JackPikatea/pikatea-macropad-deej-firmware/README.md

# PikateaPCB
This is private repo for the Pikatea Macropad PCB source files. All files are owned by Pikatea Company
