JackPikatea/pikatea-macropad-deej-firmware/Pikatea Macropad GB4/BOM from GB3/Pikatea Macropad GB3.xls

Id | Designator | Package | Quantity | Designation | Manufacturer | Manufacturer Part Number | Description
7 | SW1 | SW_SPST_TL3342 | 1 | SW_DPST | HRO | K2-1187SQ-D4SW-06 | SPST-NO,12VDC,50mA,4-SMD
9 | R3 | R_0805_2012Metric | 1 | 10K | Yageo | RC0805FR-0710KL | 10K,1%,1/8W,0805
11 | C14,C12,C11 | C_0805_2012Metric | 3 | 100nF | Yageo | CC0805KRX7R9BB104 | 100nF,50V,10%,X7R,0805
14 | X1 | Crystal_SMD_SeikoEpson_FA238-4Pin_3.2x2.5mm | 1 | 16MHz | Yangxing Tech | X322516MLB4SI | 16MHz ±10ppm 9pF 60? SMD-3225_4P
15 | U1 | LQFP-44_10x10mm_P0.8mm | 1 | ATMEGA32U4-EP | Microchip Technology | ATMEGA32U4-AU | ATMEGA32U4-AU,44-TQFP
16 | R5,R4 | R_0805_2012Metric | 2 | 22 | Yageo | AC0805FR-0722RL | 22? ±1% 0.125W ±100ppm/? 0805
18 | C10,C5,C4,C3,C2,C1 | C_0805_2012Metric | 6 | 0u1 | Yageo | CC0805KRX7R9BB104 | 100nF,50V,10%,X7R,0805
19 | C9 | C_0805_2012Metric | 1 | 1u | Yageo | CC0805KKX7R9BB105 | 1uF,50V,10%,X7R,0805
20 | C8,C7 | C_0805_2012Metric | 2 | 22p | Yageo | CC0805JRNPO9BN220 | 22pF ±5% 50V NP0 0805
21 | C6 | C_0805_2012Metric | 1 | 4u7 | Yageo | CC0805KKX5R6BB475 | 4.7uF,10V,10%,X5R,0805
22 | J2 |  | 1 |  | Jing Extension of the Electronic Co. | 920-462A2021D10102 | Through Hole USB B Mini Connectors
