JackPikatea/pikatea-macropad-deej-firmware/Pikatea Macropad GB4/BOM from GB3/JLCSMT_Sample_BOM1.xlsx

Comment | Designator | Footprint | LCSC Part #（optional）
 | SW1 | SW_SPST_TL3342 | C223821
 | R3 | R_0805_2012Metric | C84376
 | C14,C12,C11 | C_0805_2012Metric | C49678
16MHz | X1 | Crystal:Crystal_SMD_SeikoEpson_FA238-4Pin_3.2x2.5mm | C13738
Atmega32U4-AU | U1 | Package_QFP:TQFP-44_10x10mm_P0.8mm | C44854
 | R5,R4 | R_0805_2012Metric | C144573
 | C10,C5,C4,C3,C2,C1 | C_0805_2012Metric | C49678
 | C9 | C_0805_2012Metric | C91185
 | C8,C7 | C_0805_2012Metric | C105623
 | C6 | C_0805_2012Metric | C107125
USB_B_Mini | J2 | usb_mini:USB-Mini-B_ LCSC-C46398 | C46398
