JackPikatea/pikatea-macropad-deej-firmware/Pikatea SD card Module/BOM/Pikatea SD card Module.xls

Id | Designator | Package | Quantity | Designation | Manufacturer | Manufacturer Part Number | Description
1 | XS1 | XUNPU_TF-110 | 1 | SD_ebay-uSD-push_push_SMD | XUNPU | TF-110 | microSD™ Memory Card 8 connector 11.25x11.35x1.32mm Card Sockets Connectors RoHS
2 | R4,R3,R2,R1 | R_0805_2012Metric | 4 | 3.3K | Yageo | RC0805FR-073K3L | 3.3K,1%,1/8W,0805
3 | U2 | SOT-223-3_TabPin2 | 1 | AMS1117-3.3 | SHIKUES(??) | AMS1117-3.3 | AMS1117-3.3,SOT-223
4 | U3 | TSSOP-14-1EP_4.4x5mm_P0.65mm | 1 | 74LVC125APW,118 | Nxp Semiconductors | 74LVC125APW,118 | 74LVC125APW,118,14-TSSOP
5 | C1,C2,C4 | C_0805_2012Metric | 3 | 100nF | Yageo | CC0805KRX7R9BB104 | 100nF,50V,10%,X7R,0805
6 | C3 | C_0805_2012Metric | 1 | 10uF | Samsung Electro-Mechanics | CL21A106KAYNNNE | 10uF,25V,10%,X5R,0805
