JackPikatea/pikatea-macropad-deej-firmware/Pikatea Macropad Mini/BOM/Pikatea Macropad Mini.xls

Id | Designator | Package | Quantity | Designation | Manufacturer | Manufacturer Part Number | Description
3 | C13 | C_0805_2012Metric | 1 | 10uF | Samsung Electro-Mechanics | CL21A106KAYNNNE | 10uF,25V,10%,X5R,0805
5 | U3 | TSSOP-14-1EP_4.4x5mm_P0.65mm | 1 | 74LVC125APW,118 | Nxp Semiconductors | 74LVC125APW,118 | 74LVC125APW,118,14-TSSOP
6 | U2 | SOT-223-3_TabPin2 | 1 | AMS1117-3.3 | SHIKUES(??) | AMS1117-3.3 | AMS1117-3.3,SOT-223
7 | SW1 | SW_SPST_TL3342 | 1 | SW_DPST | HRO | K2-1187SQ-D4SW-06 | SPST-NO,12VDC,50mA,4-SMD
8 | R7,R6,R2,R1 | R_0805_2012Metric | 4 | 3.3K | Yageo | RC0805FR-073K3L | 3.3K,1%,1/8W,0805
9 | R3 | R_0805_2012Metric | 1 | 10K | Yageo | RC0805FR-0710KL | 10K,1%,1/8W,0805
11 | C14,C12,C11 | C_0805_2012Metric | 3 | 100nF | Yageo | CC0805KRX7R9BB104 | 100nF,50V,10%,X7R,0805
13 | XS1 | XUNPU_TF-110 | 1 | SD_ebay-uSD-push_push_SMD | XUNPU | TF-110 | microSD™ Memory Card 8 connector 11.25x11.35x1.32mm Card Sockets Connectors RoHS
14 | X1 | Crystal_SMD_SeikoEpson_FA238-4Pin_3.2x2.5mm | 1 | 16MHz | YXC???? | X322516MLB4SI | 16MHZ,9PF,4-SMD
15 | U1 | LQFP-44_10x10mm_P0.8mm | 1 | ATMEGA32U4-EP | Microchip Technology | ATMEGA32U4-AU | ATMEGA32U4-AU,44-TQFP
16 | R5,R4 | R_0805_2012Metric | 2 | 22 | TE Connectivity | CRG0805F22R | 22R,1%,1/8W,0805
18 | C10,C5,C4,C3,C2,C1 | C_0805_2012Metric | 6 | 0u1 | Yageo | CC0805KRX7R9BB104 | 100nF,50V,10%,X7R,0805
19 | C9 | C_0805_2012Metric | 1 | 1u | Yageo | CC0805KKX7R9BB105 | 1uF,50V,10%,X7R,0805
20 | C8,C7 | C_0805_2012Metric | 2 | 22p | KEMET | C0805C220J5GACTU | 22pF,50V,5%,C0G,0805
21 | C6 | C_0805_2012Metric | 1 | 4u7 | Yageo | CC0805KKX5R6BB475 | 4.7uF,10V,10%,X5R,0805
