JackPikatea/pikatea-macropad-deej-firmware/Pikatea R26 macropad/Pikatea R26 Macropad/assembled1.step

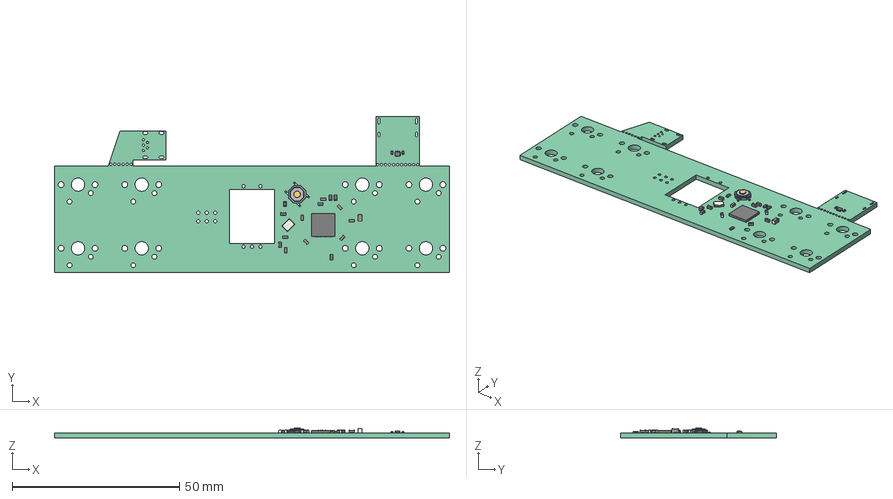
[picture p6: CAD file, 2022-02-02]
Pikatea R26 macropad/Pikatea R26 Macropad/assembled1.step
118.2 x 46.7 x 3.14 mm
Local_CS_fcbd
Pcb_fcbd
PCB_Sketch_fcbd
SW1_SW_SPST_TL3342_61F87470
R5_R_0603_1608Metric_61F8A8D3
Y1_Crystal_SMD_SeikoEpson_FA238-4Pin_3.2x2.5mm_61F812BB
U2_SOT_666_61F81285
U1_QFN-44-1EP_7x7mm_Pitch0.5mm_61F8126F
R_HWB1_R_0603_1608Metric_61F84E14
R4_R_0603_1608Metric_61F853EC
R3_R_0603_1608Metric_61F85494
R2_R_0402_1005Metric_61F81196
R1_R_0402_1005Metric_61F81187
C12_C_0603_1608Metric_61F81039
C11_C_0603_1608Metric_61F8860B
C10_C_0805_2012Metric_61F81017
C9_C_0603_1608Metric_61F81006
C8_C_0603_1608Metric_61F80FF5
C7_C_0603_1608Metric_61F80FE4
C6_C_0603_1608Metric_61F80FD3
C5_C_0603_1608Metric_61F80FC2
C4_C_0603_1608Metric_61F80FB1
C3_C_0603_1608Metric_61F80FA0
C2_C_0603_1608Metric_61F80F8F
C1_C_0603_1608Metric_61F84EFE
