JackPikatea/pikatea-macropad-deej-firmware/Pikatea Desktop Macropad/PCB Model.step

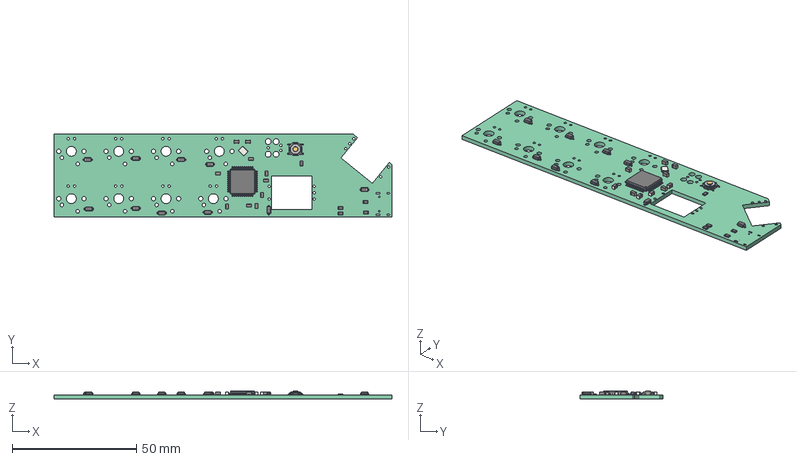
[picture p9: CAD file, 2021-05-04]
Pikatea Desktop Macropad/PCB Model.step
136.0 x 33.5 x 3.14 mm
Local_CS_4ca4
Pcb_4ca4
PCB_Sketch_4ca4
R2_R_0805_2012Metric_607FE78E
R1_R_0805_2012Metric_607FE77D
X1_Crystal_SMD_SeikoEpson_FA238-4Pin_3.2x2.5mm_60806100
U1_LQFP_44_10x10mm_P08mm_608056F7
SW1_SW_SPST_TL3342_607F38D0
R5_R_0805_2012Metric_607F4A5F
R4_R_0805_2012Metric_607F3889
R3_R_0805_2012Metric_607F3878
D10_D_SOD_123_60805B52
D9_D_SOD_123_607F3736
D8_D_SOD_123_607F371D
D7_D_SOD_123_607F3704
D6_D_SOD_123_607F36EB
D5_D_SOD_123_607F36D2
D4_D_SOD_123_607F5B08
D3_D_SOD_123_607F36A0
D2_D_SOD_123_607F3687
D1_D_SOD_123_607F366E
C10_C_0805_2012Metric_60806FC0
C9_C_0805_2012Metric_60809403
C8_C_0805_2012Metric_607F3633
C7_C_0805_2012Metric_607F3622
C6_C_0805_2012Metric_60806B1D
C5_C_0805_2012Metric_607F3600
C4_C_0805_2012Metric_607F35EF
C3_C_0805_2012Metric_607F35DE
C2_C_0805_2012Metric_60806F2E
C1_C_0805_2012Metric_607F35BC
