JackPikatea/pikatea-macropad-deej-firmware/Pikatea handwire helpers/2u Hand Wire Helpers/rev2.step

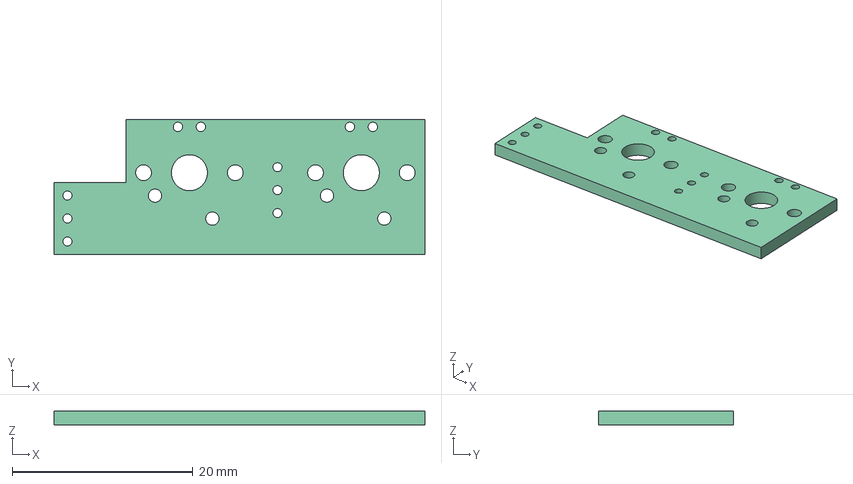
[picture p10: CAD file, 2021-09-28]
Pikatea handwire helpers/2u Hand Wire Helpers/rev2.step
41.1 x 15.0 x 1.60 mm
Local_CS_9b5
Pcb_9b5
PCB_Sketch_9b5
Top_9b5
