JackPikatea/pikatea-macropad-deej-firmware/Pikatea Keyboard ProMicro/PCB1.step

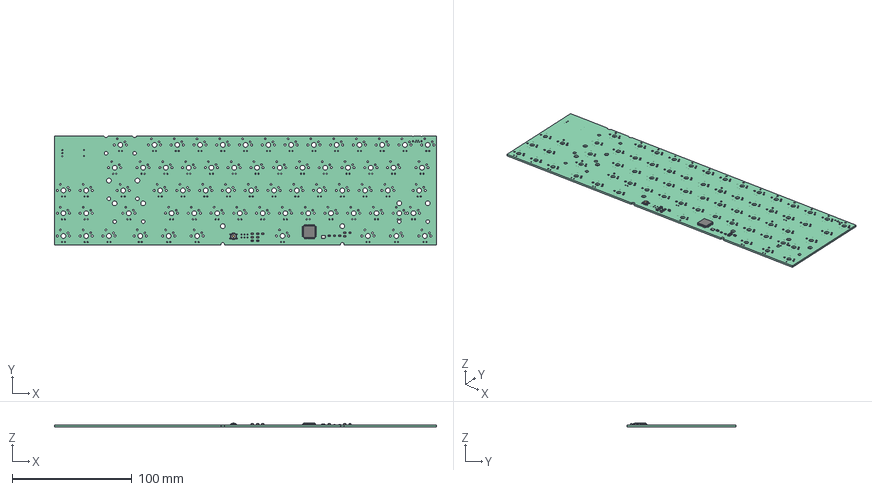
[picture p11: CAD file, 2021-05-04]
Pikatea Keyboard ProMicro/PCB1.step
319.6 x 91.1 x 3.14 mm
Local_CS_c713
Pcb_c713
PCB_Sketch_c713
X1_Crystal_SMD_SeikoEpson_FA238-4Pin_3.2x2.5mm_608C011E
U1_LQFP_44_10x10mm_P08mm_608C921C
SW1_SW_SPST_TL3342_608C00A2
R5_R_0805_2012Metric_608C006C
R4_R_0805_2012Metric_608C005B
R3_R_0805_2012Metric_608C004A
C10_C_0805_2012Metric_608BF9E7
C9_C_0805_2012Metric_608BF9D6
C8_C_0805_2012Metric_608BF9C5
C7_C_0805_2012Metric_608BF9B4
C6_C_0805_2012Metric_608BF9A3
C5_C_0805_2012Metric_608BF992
C4_C_0805_2012Metric_608BF981
C3_C_0805_2012Metric_608BF970
C2_C_0805_2012Metric_608BF95F
C1_C_0805_2012Metric_608BF94E
