JackPikatea/pikatea-macropad-deej-firmware/Pikatea Macropad GB3/GB3 PCB.step

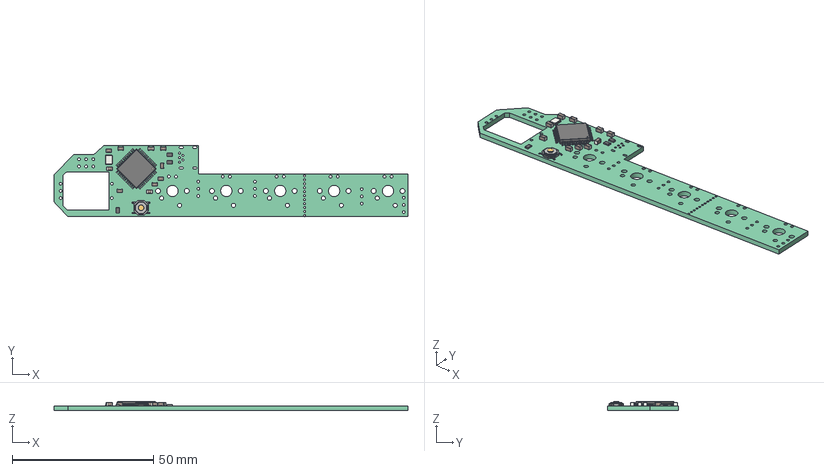
[picture p12: CAD file, 2021-09-28]
Pikatea Macropad GB3/GB3 PCB.step
125.1 x 25.2 x 3.14 mm
Local_CS_68f9
Pcb_68f9
PCB_Sketch_68f9
SW1_SW_SPST_TL3342_605A6D3F
X1_Crystal_SMD_SeikoEpson_FA238-4Pin_3.2x2.5mm_605A6E1B
R5_R_0805_2012Metric_605A6D09
R4_R_0805_2012Metric_605A6CF8
R3_R_0805_2012Metric_605A6CE7
C10_C_0805_2012Metric_605CCE2F
C9_C_0805_2012Metric_605A6B15
C8_C_0805_2012Metric_605A6B04
C7_C_0805_2012Metric_605A6AF3
C6_C_0805_2012Metric_605A6AE2
C5_C_0805_2012Metric_605A6AD1
C4_C_0805_2012Metric_605A6AC0
C3_C_0805_2012Metric_605A6AAF
C2_C_0805_2012Metric_605A6A9E
C1_C_0805_2012Metric_605CC52D
U1_LQFP_44_10x10mm_P08mm_605AD741
