JackPikatea/pikatea-macropad-deej-firmware/Pikatea Macropad GB4 Full Kit/Library Files/Type-C.pretty-master/Type-C.pretty-master/HRO  TYPE-C-31-M-12.step

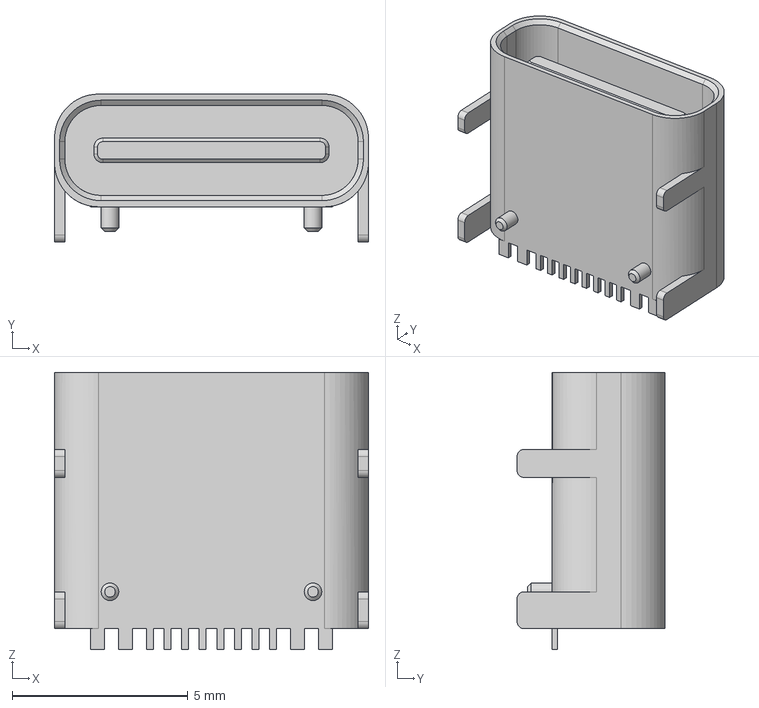
[picture p13: CAD file, 2021-05-04]
Pikatea Macropad GB4 Full Kit/Library Files/Type-C.pretty-master/Type-C.pretty-master/HRO TYPE-C-31-M-12.step
8.94 x 4.21 x 7.90 mm
