JackPikatea/pikatea-macropad-deej-firmware/Pikatea R26 macropad/Pikatea R26 Kit LED Macropad/Pikatea R26 Kit LED Macropad PCB Model.step

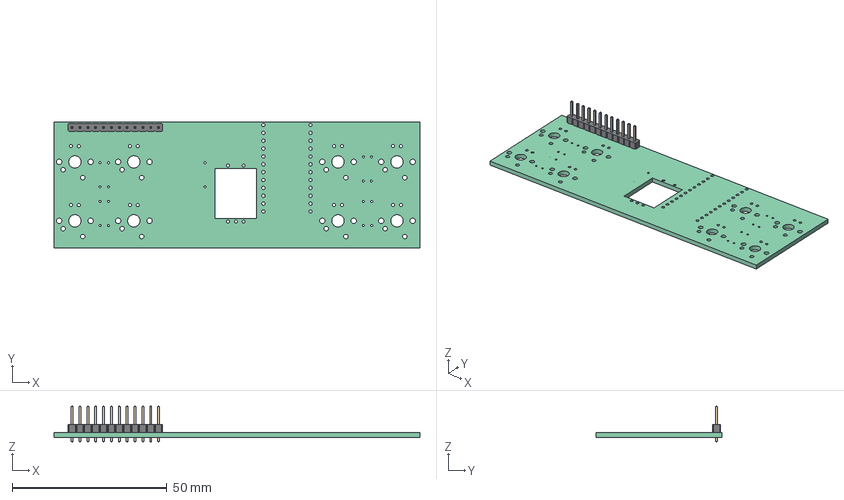
[picture p14: CAD file, 2022-01-25]
Pikatea R26 macropad/Pikatea R26 Kit LED Macropad/Pikatea R26 Kit LED Macropad PCB Model.step
118.3 x 40.8 x 11.5 mm
Local_CS_c334
Pcb_c334
PCB_Sketch_c334
J1_PinHeader_1x12_P254mm_Vertical_61C3FEEA
