JackPikatea/pikatea-macropad-deej-firmware/Pikatea R26 macropad/Pikatea R26 Plate/reference plate2.dxf

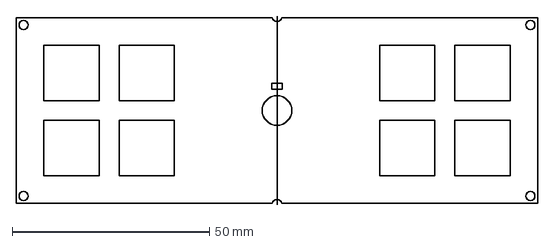
[picture p15: CAD file, 2022-02-08]
Pikatea R26 macropad/Pikatea R26 Plate/reference plate2.dxf
132.1 x 47.6 mm
