JackPikatea/pikatea-macropad-deej-firmware/Pikatea R26 macropad/top plate template sketch.dxf

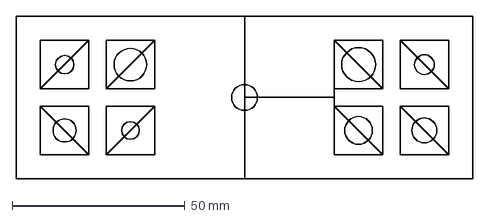
[picture p16: CAD file, 2022-01-31]
Pikatea R26 macropad/top plate template sketch.dxf
132.1 x 47.1 mm
