JackPikatea/pikatea-macropad-deej-firmware/Pikatea Richard/PR-BottomCase/The Richard Bottom Plate.step

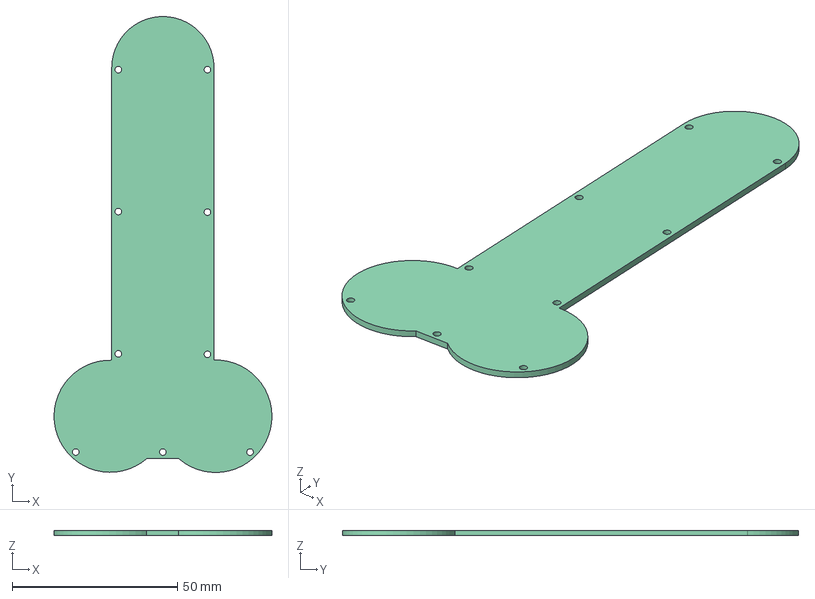
[picture p17: CAD file, 2021-06-23]
Pikatea Richard/PR-BottomCase/The Richard Bottom Plate.step
66.0 x 138.1 x 1.60 mm
Local_CS_8dec
Pcb_8dec
PCB_Sketch_8dec
Step_Models_8dec
