JackPikatea/pikatea-macropad-deej-firmware/Pikatea Richard/PR-PCB/The richard PCB.step

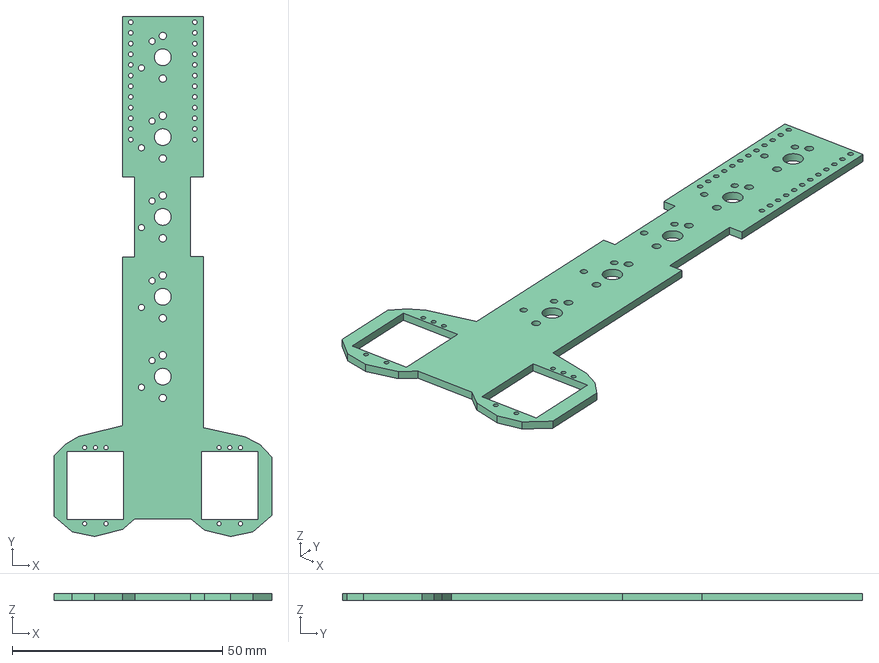
[picture p18: CAD file, 2022-03-31]
Pikatea Richard/PR-PCB/The richard PCB.step
51.8 x 123.8 x 1.60 mm
Local_CS_413a
Pcb_413a
PCB_Sketch_413a
Step_Models_413a
