JackPikatea/pikatea-macropad-deej-firmware/Pikatea Richard/PR-TopPlate/Richard Top Plate.step

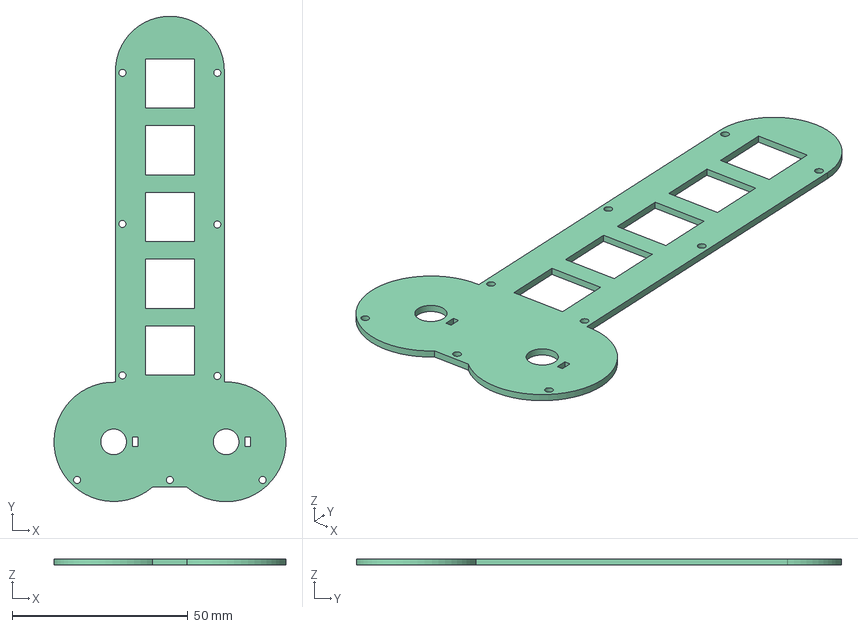
[picture p19: CAD file, 2021-06-23]
Pikatea Richard/PR-TopPlate/Richard Top Plate.step
66.0 x 138.1 x 1.60 mm
Local_CS_3f50
Pcb_3f50
PCB_Sketch_3f50
Step_Models_3f50
