JackPikatea/pikatea-macropad-deej-firmware/Pikatea R26 macropad/Backside cover sketch.dxf

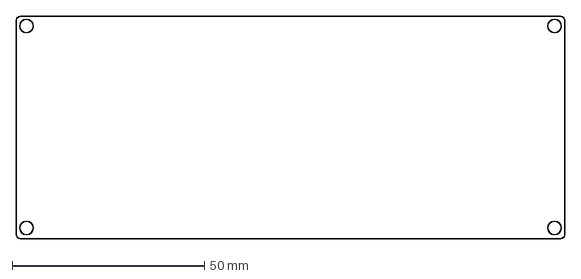
[picture p21: CAD file, 2022-01-31]
Pikatea R26 macropad/Backside cover sketch.dxf
142.6 x 57.8 mm
