JackPikatea/pikatea-macropad-deej-firmware/Pikatea R26 macropad/Pikatea R26 Plate/reference plate.dxf

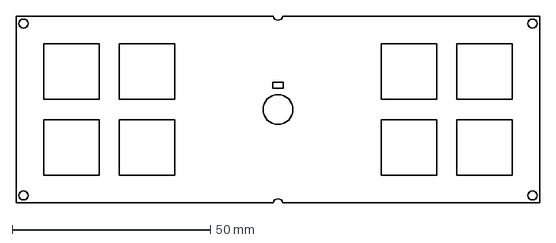
[picture p22: CAD file, 2022-02-08]
Pikatea R26 macropad/Pikatea R26 Plate/reference plate.dxf
132.1 x 47.1 mm
