JackPikatea/pikatea-macropad-deej-firmware/Pikatea R26 macropad/Pikatea R26 Macropad/step6.step

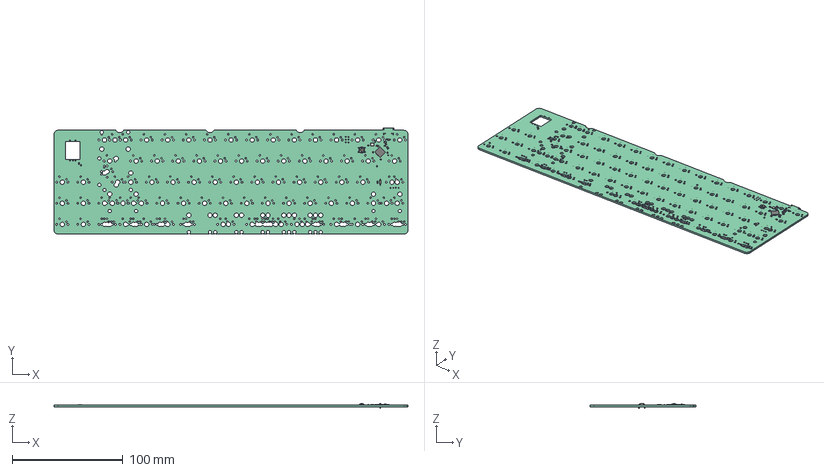
[picture p23: CAD file, 2022-01-31]
Pikatea R26 macropad/Pikatea R26 Macropad/step6.step
319.6 x 95.7 x 4.59 mm
Local_CS_8b00
Pcb_8b00
PCB_Sketch_8b00
SW1_SW_SPST_TL3342_61CD82D5
C12_C_0603_1608Metric_61CD6900
C11_C_0603_1608Metric_61CD68EF
C6_C_0603_1608Metric_61CA5CF7
R5_R_0603_1608Metric_61CCE06B
U2_SOT_666_61CB1819
U1_QFN-44-1EP_7x7mm_Pitch0.5mm_61CAB430
Y1_Crystal_SMD_SeikoEpson_FA238-4Pin_3.2x2.5mm_61CA77BC
R_HWB1_R_0603_1608Metric_61CA7686
R4_R_0603_1608Metric_61CA7664
R3_R_0603_1608Metric_61CA7653
R2_R_0402_1005Metric_61CA7642
R1_R_0402_1005Metric_61CA7633
C10_C_0805_2012Metric_61CADA8C
C9_C_0603_1608Metric_61CA5D2A
C8_C_0603_1608Metric_61CAD480
C7_C_0603_1608Metric_61CD3611
C5_C_0603_1608Metric_61CA5CE6
C4_C_0603_1608Metric_61CAD9CA
C3_C_0603_1608Metric_61CAC993
C2_C_0603_1608Metric_61CA5CB3
C1_C_0603_1608Metric_61CA5CA2
capslock_led_resistor_SMD1_R_0805_2012Metric_61611AB7
capslock_led_resistor_THT1_R_Axial_DIN0204_L36mm_D16mm_P508mm_ Horizontal_6144AEC9
