JackPikatea/pikatea-macropad-deej-firmware/(list of files, cad)

Other CAD files:
4 button Macropad(2)/pcb.step
Pikatea handwire helpers/1u Hand Wire Helpers/rev1.step
Pikatea handwire helpers/2u Hand Wire Helpers/rev1.step
Pikatea handwire helpers/Space Hand Wire Helpers/rev1.step
