JackPikatea/pikatea-macropad-deej-firmware/(list of files, drawings)

Other design files:
4 button Macropad(2)/BigSwitch.dsn
