JackPikatea/pikatea-macropad-deej-firmware/Pikatea Macropad GB4 Full Kit/Pikatea Macropad GB4 Full Kit.kicad_pcb

## KiCad design Pikatea Macropad GB4 Full Kit/Pikatea Macropad GB4 Full Kit.kicad_pcb (2022-03-31)

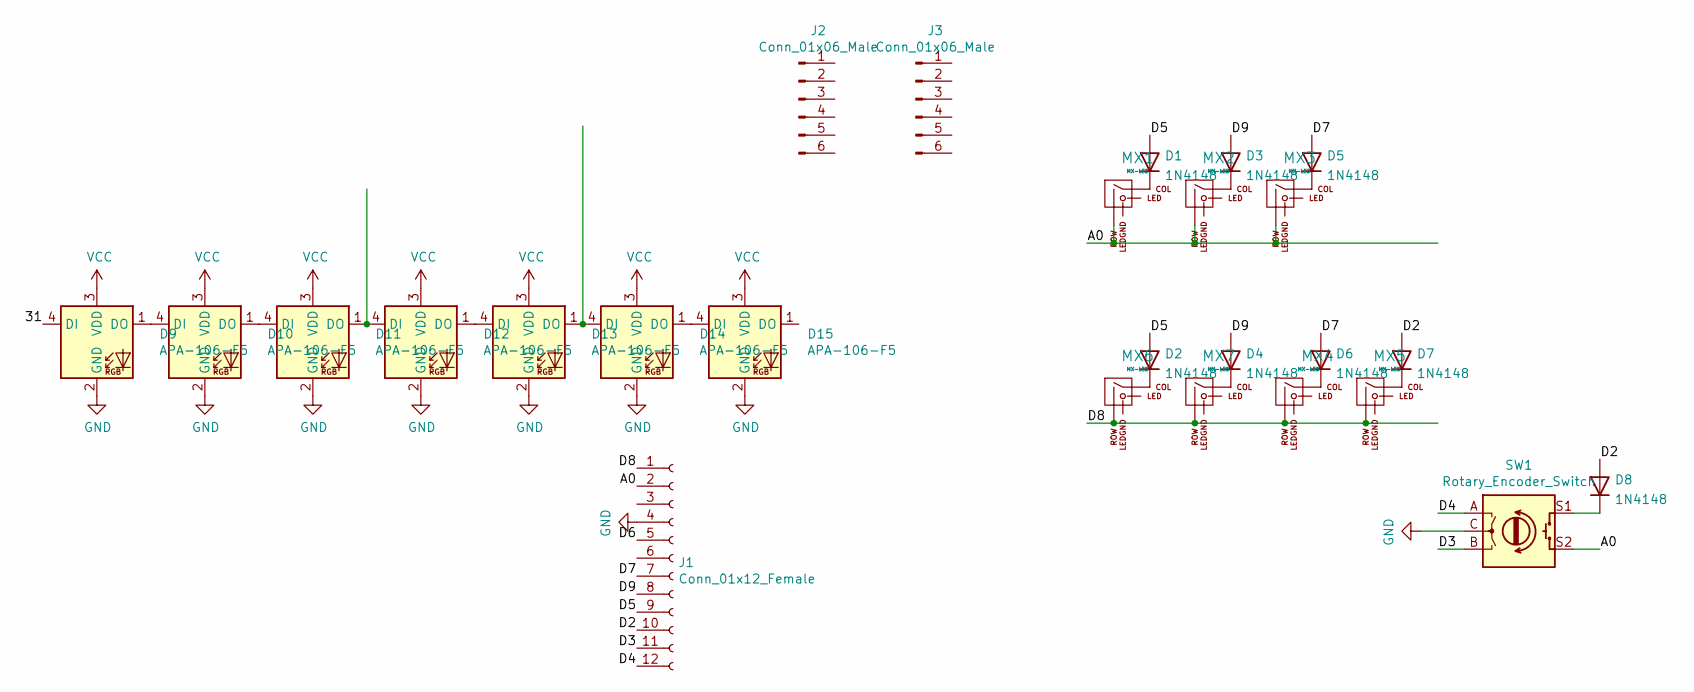
[picture p27: schematic Pikatea Macropad GB4 Full Kit.kicad_sch]

Parts:
D1, D2, D3, D4, D5, D6, D7, D8: 1N4148; D_SOD123W_hand
D9, D10, D11, D12, D13, D14, D15: APA-106-F5; TONYU-DY-S352818-RGBC
J1: Conn_01x12_Female; PinHeader_1x12_P2.54mm_Vertical
J2, J3: Conn_01x06_Male; Breakaway-Throughole
MX1, MX2, MX3, MX4, MX5, MX6, MX7: MX-LED; MXOnly-1U-SquareCutLED
SW1: Rotary_Encoder_Switch; Encoder-BI_EN11_HSM0E

Connections:
/31: D9.4 (DI)
/A0: J1.2, MX1.2 (ROW), MX2.2 (ROW), MX3.2 (ROW), SW1.S2
/D2: D7.2 (A), D8.2 (A), J1.10
/D3: J1.11, SW1.B
/D4: J1.12, SW1.A
/D5: D1.2 (A), D2.2 (A), J1.9
/D6: J1.5
/D7: D5.2 (A), D6.2 (A), J1.7
/D8: J1.1, MX4.2 (ROW), MX5.2 (ROW), MX6.2 (ROW), MX7.2 (ROW)
/D9: D3.2 (A), D4.2 (A), J1.8
GND: D9.2 (GND), D10.2 (GND), D11.2 (GND), D12.2 (GND), D13.2 (GND), D14.2 (GND), D15.2 (GND), J1.4, SW1.C
unnamed: D2.1 (K), MX6.1 (COL)
unnamed: D4.1 (K), MX7.1 (COL)
unnamed: D10.1 (DO), D11.4 (DI)
unnamed: D9.1 (DO), D10.4 (DI)
unnamed: D11.1 (DO), D12.4 (DI)
unnamed: D12.1 (DO), D13.4 (DI)
unnamed: D13.1 (DO), D14.4 (DI)
unnamed: D14.1 (DO), D15.4 (DI)
unnamed: D1.1 (K), MX1.1 (COL)
unnamed: D3.1 (K), MX2.1 (COL)
unnamed: D5.1 (K), MX3.1 (COL)
unnamed: D6.1 (K), MX4.1 (COL)
unnamed: D7.1 (K), MX5.1 (COL)
unnamed: D8.1 (K), SW1.S1
VCC: D9.3 (VDD), D10.3 (VDD), D11.3 (VDD), D12.3 (VDD), D13.3 (VDD), D14.3 (VDD), D15.3 (VDD)

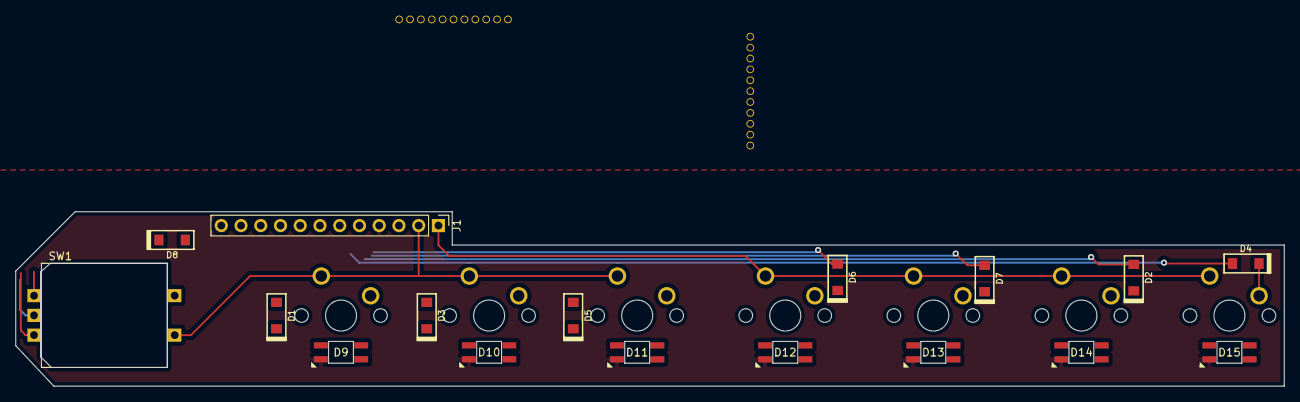
[picture p28: board Pikatea Macropad GB4 Full Kit.kicad_pcb from above]

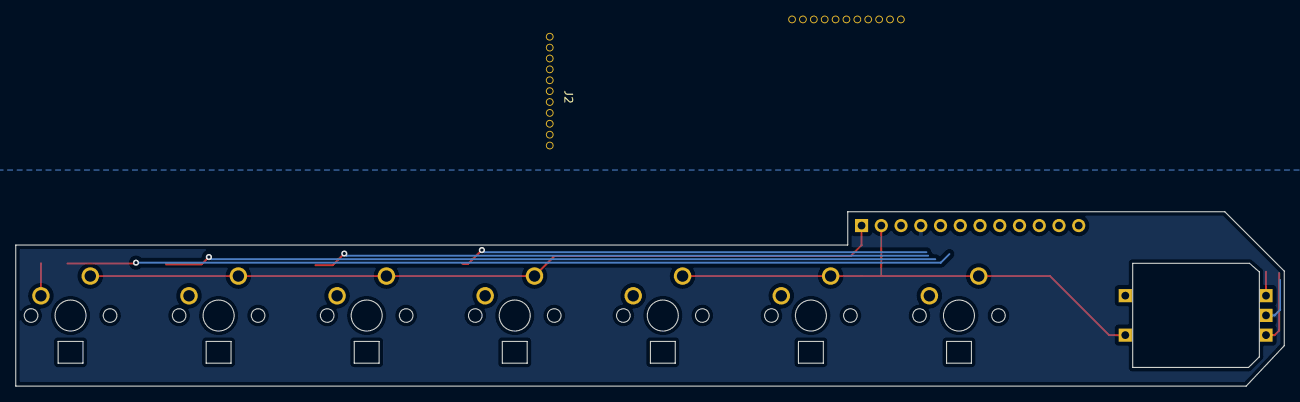
[picture p29: board Pikatea Macropad GB4 Full Kit.kicad_pcb from below]

Board: 2 copper layers, 163.2 x 22.4 mm, 26 parts (14 on the bottom side), 24 nets.
