JackPikatea/pikatea-macropad-deej-firmware/Pikatea Richard/PR-PCB/PR-PCB.kicad_pcb

## KiCad design Pikatea Richard/PR-PCB/PR-PCB.kicad_pcb (2022-03-31)

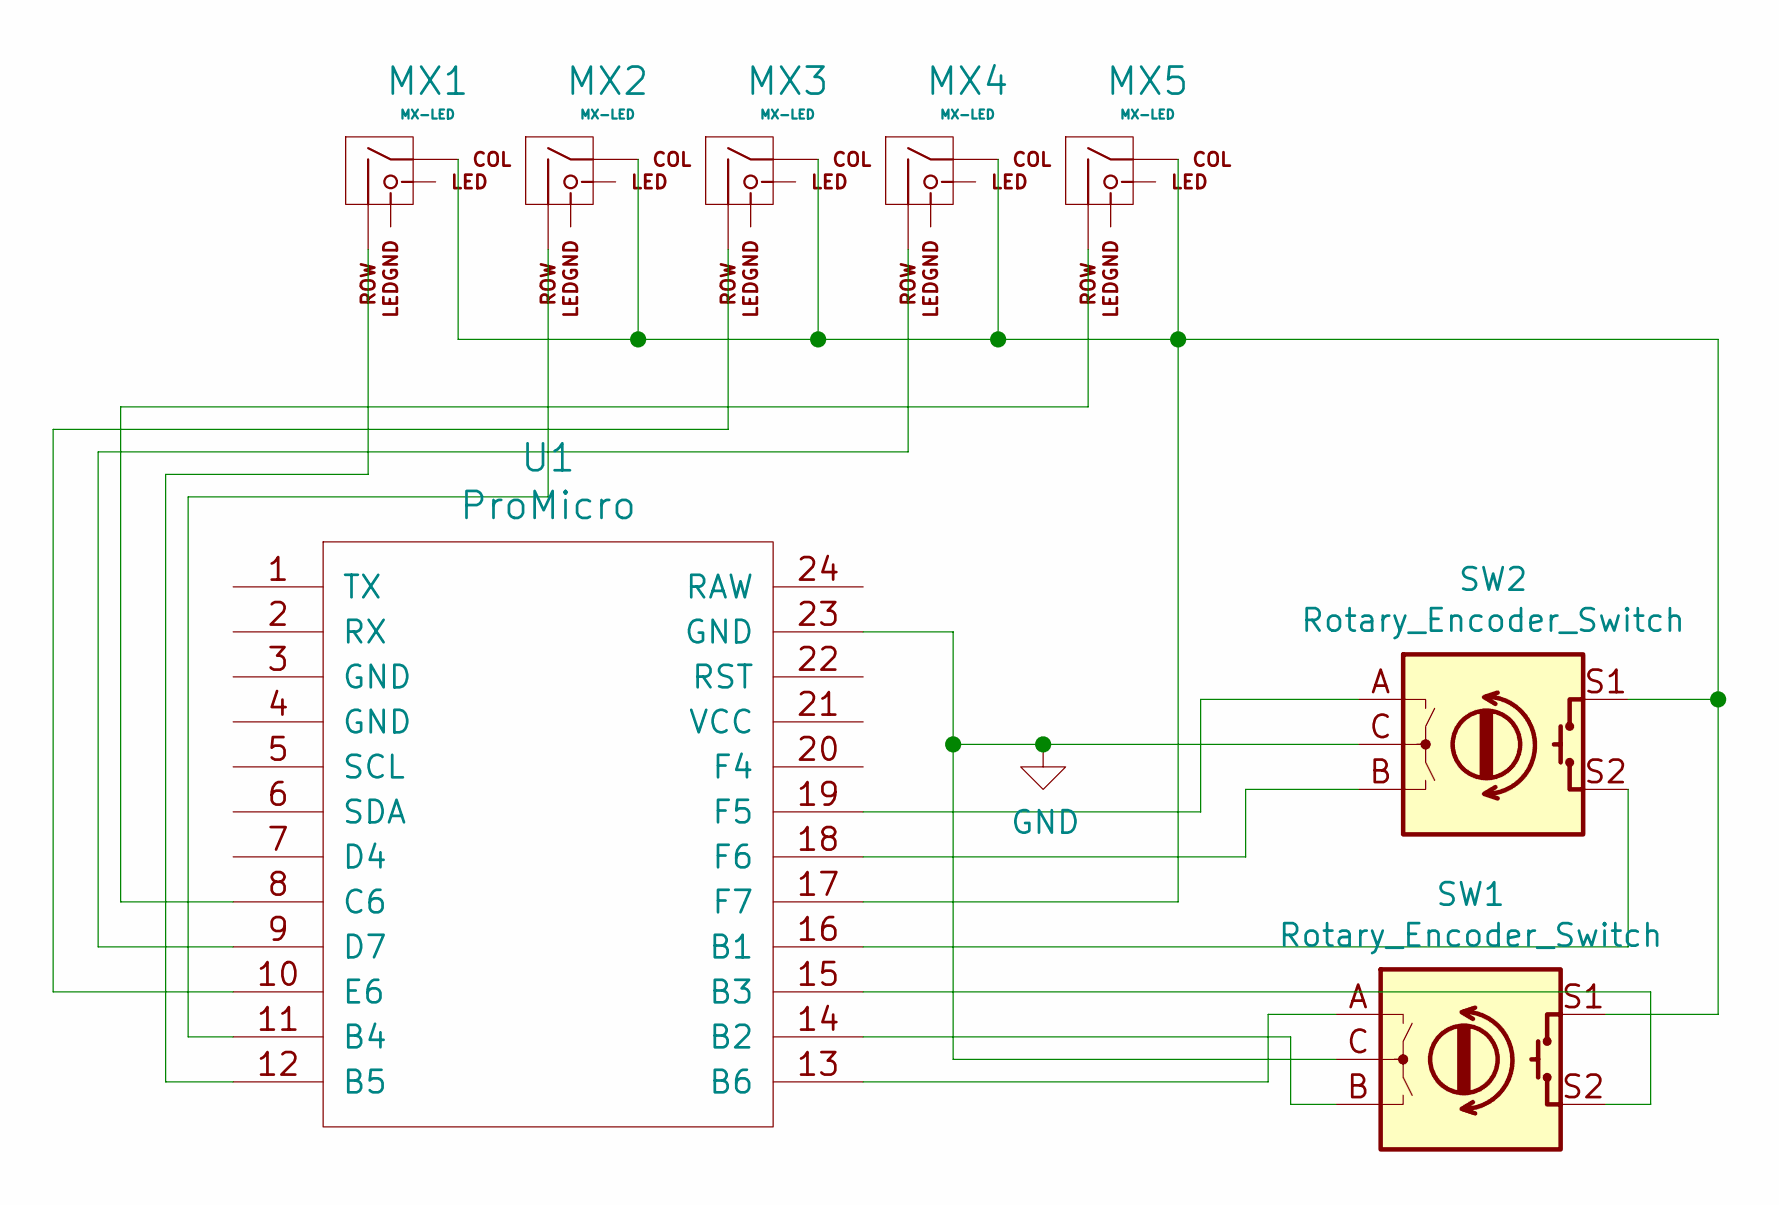
[picture p30: schematic PR-PCB.sch]

Parts:
MX1, MX2, MX3, MX4, MX5: MX-LED; MXOnly-1U-NoLED
SW1, SW2: Rotary_Encoder_Switch; Encoder-BI_EN11_HSM0E
U1: ProMicro

Connections:
GND: SW1.C, SW2.C, U1.23 (GND)
unnamed: MX1.1 (COL), MX2.1 (COL), MX3.1 (COL), MX4.1 (COL), MX5.1 (COL), SW1.S1, SW2.S1, U1.17 (F7)
unnamed: MX1.2 (ROW), U1.12 (B5)
unnamed: MX2.2 (ROW), U1.11 (B4)
unnamed: MX3.2 (ROW), U1.10 (E6)
unnamed: MX4.2 (ROW), U1.9 (D7)
unnamed: MX5.2 (ROW), U1.8 (C6)
unnamed: SW1.A, U1.13 (B6)
unnamed: SW1.B, U1.14 (B2)
unnamed: SW1.S2, U1.15 (B3)
unnamed: SW2.A, U1.19 (F5)
unnamed: SW2.B, U1.18 (F6)
unnamed: SW2.S2, U1.16 (B1)

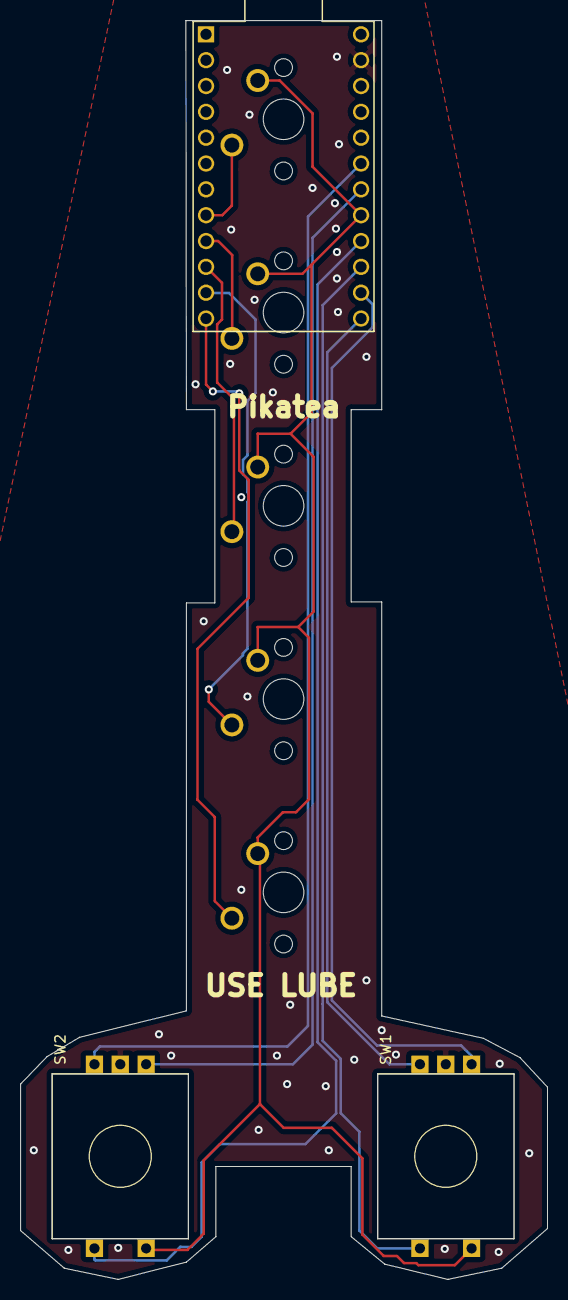
[picture p31: board PR-PCB.kicad_pcb from above]

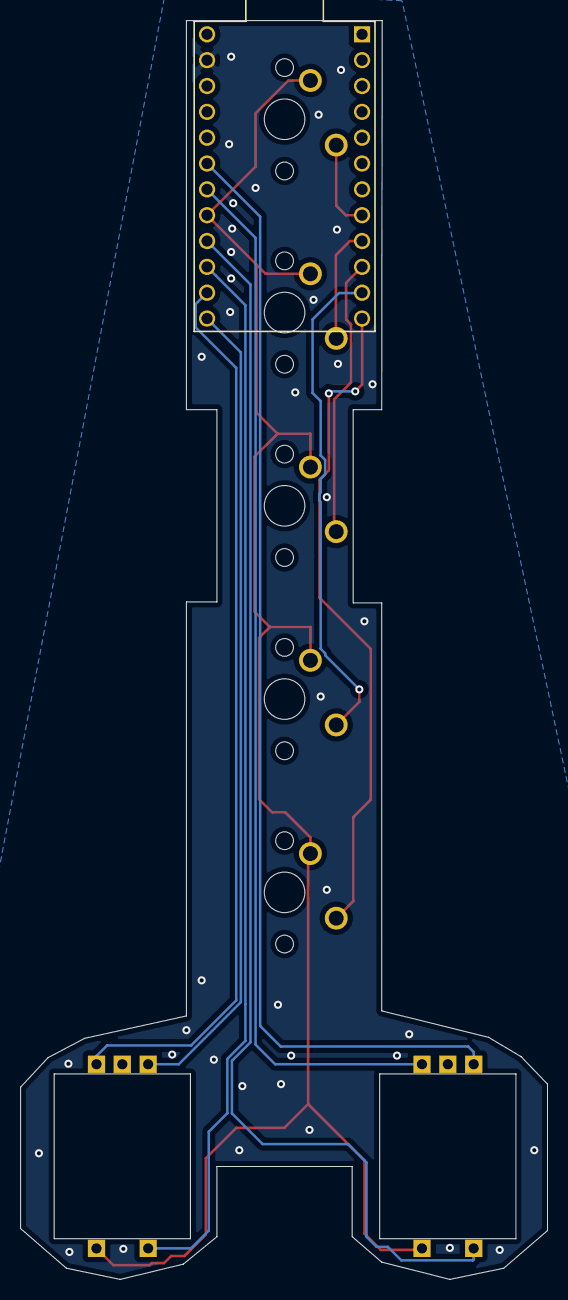
[picture p32: board PR-PCB.kicad_pcb from below]

Board: 2 copper layers, 51.8 x 123.8 mm, 8 parts (5 on the bottom side), 13 nets.
