JackPikatea/pikatea-macropad-deej-firmware/Pikatea Macropad GB4/Pikatea Macropad GB4.kicad_pcb

## KiCad design Pikatea Macropad GB4/Pikatea Macropad GB4.kicad_pcb (2022-03-31)

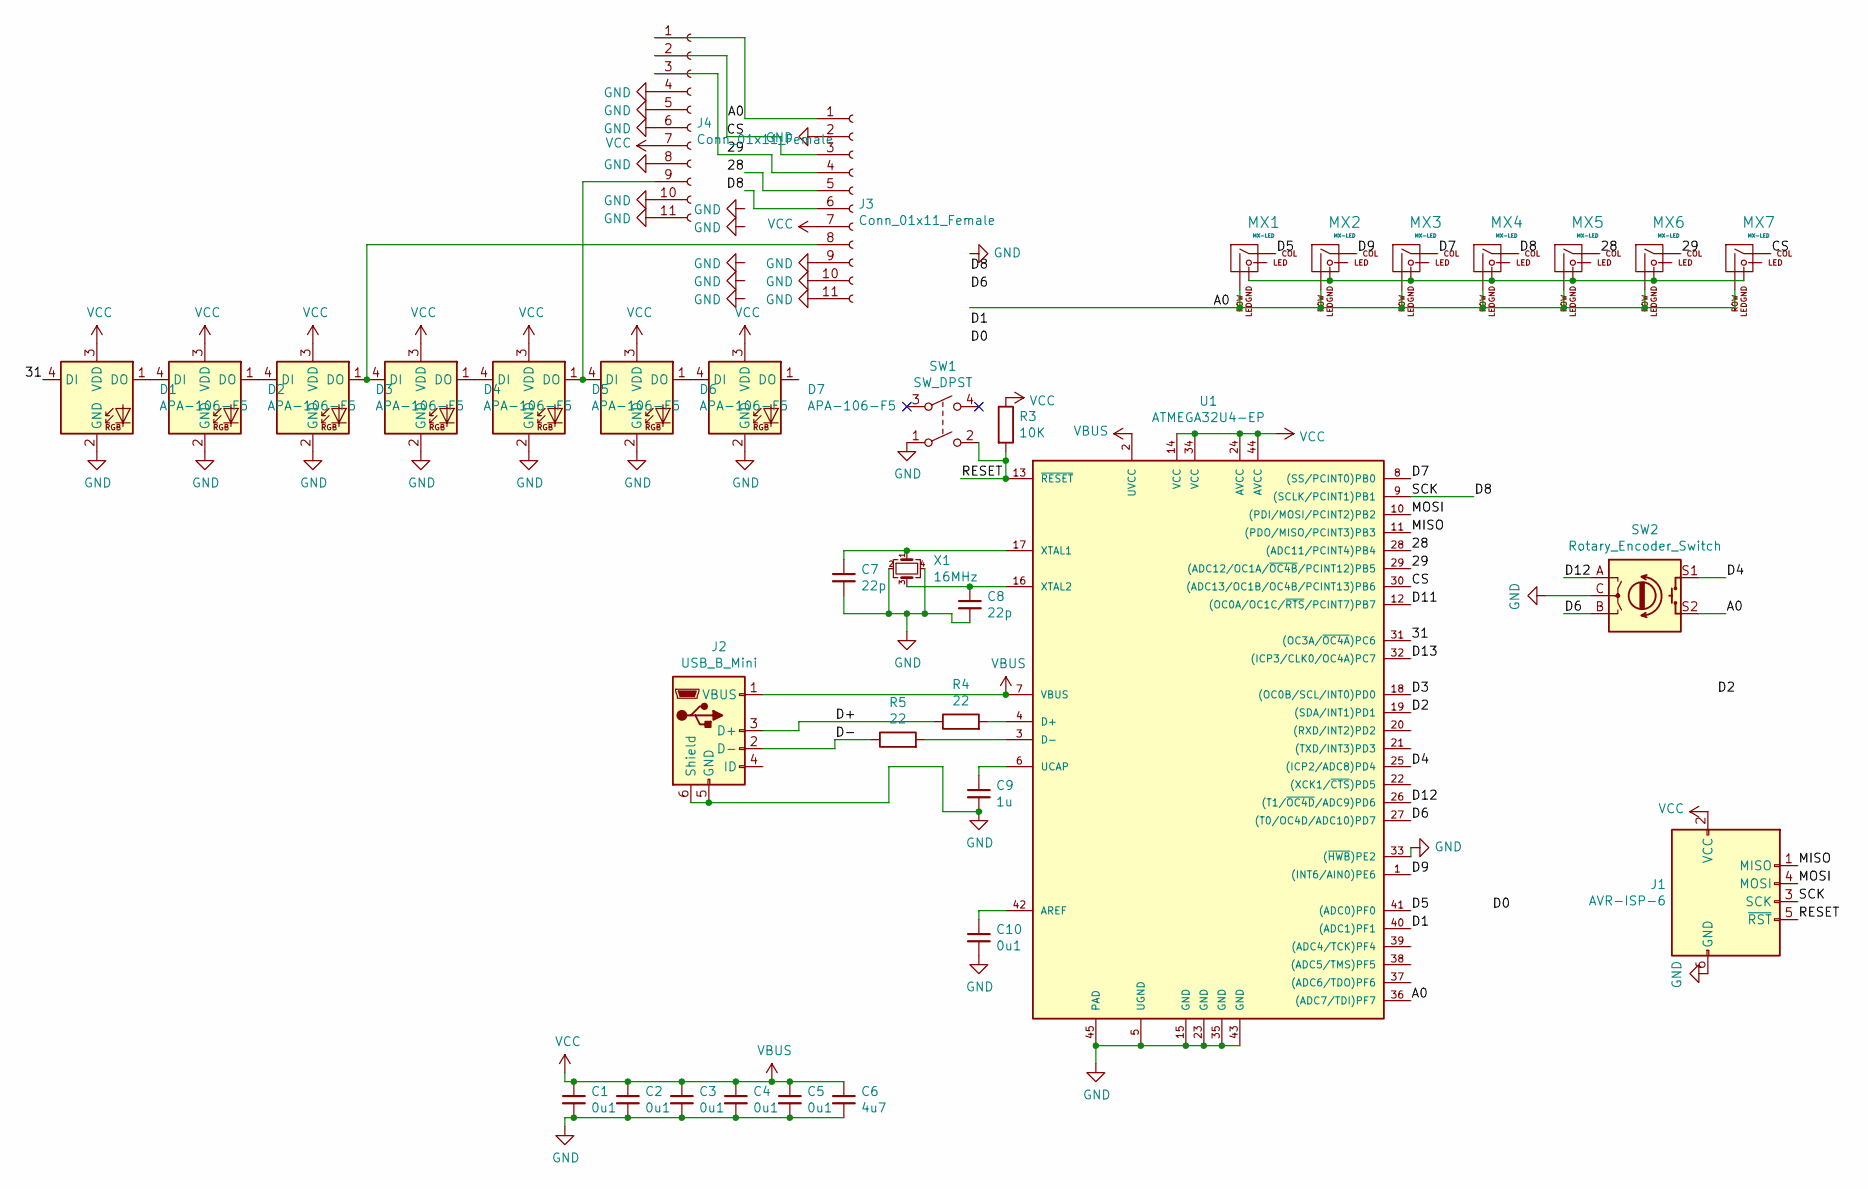
[picture p33: schematic Pikatea Macropad GB4.kicad_sch]

Parts:
C1, C2, C3, C4, C5, C10: 0u1; C_0805_2012Metric
C6: 4u7; C_0805_2012Metric
C7, C8: 22p; C_0805_2012Metric
C9: 1u; C_0805_2012Metric
D1, D2, D3, D4, D5, D6, D7: APA-106-F5; TONYU-DY-S352818-RGBC
J1: AVR-ISP-6; AVR_ICSP_3x2
J2: USB_B_Mini; USB-Mini-B_ LCSC-C46398
J3, J4: Conn_01x11_Female; Breakaway-Throughole-GB4
MX1, MX2, MX3, MX4, MX5, MX6, MX7: MX-LED; MXOnly-1U-NoLED
R3: 10K; R_0805_2012Metric
R4, R5: 22; R_0805_2012Metric
SW1: SW_DPST; SW_SPST_TL3342
SW2: Rotary_Encoder_Switch; Encoder-BI_EN11_HSM0E
U1: ATMEGA32U4-EP; QFN-44-1EP_7x7mm_P0.5mm_EP5.15x5.15mm_ThermalVias
X1: 16MHz; Crystal_SMD_SeikoEpson_FA238-4Pin_3.2x2.5mm

Connections:
/28: J3.5, MX5.1 (COL), U1.28 ((ADC11/PCINT4)PB4)
/29: J3.4, J4.3, MX6.1 (COL), U1.29 ((ADC12/OC1A/~OC4B/PCINT12)PB5)
/31: D1.4 (DI), U1.31 ((OC3A/~OC4A)PC6)
/A0: J3.1, J4.1, MX1.2 (ROW), MX2.2 (ROW), MX3.2 (ROW), MX4.2 (ROW), MX5.2 (ROW), MX6.2 (ROW), MX7.2 (ROW), SW2.S2, U1.36 ((ADC7/TDI)PF7)
/CS: J3.3, J4.2, MX7.1 (COL), U1.30 ((ADC13/OC1B/OC4B/PCINT13)PB6)
/D1: U1.40 ((ADC1)PF1)
/D2: U1.19 ((SDA/INT1)PD1)
/D3: U1.18 ((OC0B/SCL/INT0)PD0)
/D4: SW2.S1, U1.25 ((ICP2/ADC8)PD4)
/D5: MX1.1 (COL), U1.41 ((ADC0)PF0)
/D6: SW2.B, U1.27 ((T0/OC4D/ADC10)PD7)
/D7: MX3.1 (COL), U1.8 ((SS/PCINT0)PB0)
/D8: J1.3 (SCK), J3.6, MX4.1 (COL), U1.9 ((SCLK/PCINT1)PB1)
/D9: MX2.1 (COL), U1.1 ((INT6/AIN0)PE6)
/D11: U1.12 ((OC0A/OC1C/~RTS/PCINT7)PB7)
/D12: SW2.A, U1.26 ((T1/~OC4D/ADC9)PD6)
/D13: U1.32 ((ICP3/CLK0/OC4A)PC7)
/D+: J2.3 (D+), R4.1
/D-: J2.2 (D-), R5.1
/MISO: J1.1 (MISO), U1.11 ((PDO/MISO/PCINT3)PB3)
/MOSI: J1.4 (MOSI), U1.10 ((PDI/MOSI/PCINT2)PB2)
/RESET: J1.5 (~RST), R3.2, SW1.2, U1.13 (~RESET)
GND: C1.2, C2.2, C3.2, C4.2, C5.2, C6.2, C7.2, C8.2, C9.2, C10.2, D1.2 (GND), D2.2 (GND), D3.2 (GND), D4.2 (GND), D5.2 (GND), D6.2 (GND), D7.2 (GND), J1.6 (GND), J2.5 (GND), J2.6 (Shield), J3.2, J3.9, J3.10, J3.11, J4.4, J4.5, J4.6, J4.8, J4.10, J4.11, SW1.1, SW2.C, U1.5 (UGND), U1.15 (GND), U1.23 (GND), U1.33 ((~HWB)PE2), U1.35 (GND), U1.43 (GND), U1.45 (PAD), X1.2, X1.4
unnamed: C7.1, U1.17 (XTAL1), X1.1
unnamed: C8.1, U1.16 (XTAL2), X1.3
unnamed: C9.1, U1.6 (UCAP)
unnamed: C10.1, U1.42 (AREF)
unnamed: D1.1 (DO), D2.4 (DI)
unnamed: D2.1 (DO), D3.4 (DI)
unnamed: D3.1 (DO), D4.4 (DI), J3.8
unnamed: D4.1 (DO), D5.4 (DI)
unnamed: D5.1 (DO), D6.4 (DI), J4.9
unnamed: D6.1 (DO), D7.4 (DI)
unnamed: R4.2, U1.4 (D+)
unnamed: R5.2, U1.3 (D-)
VBUS: C1.1, C2.1, C3.1, C4.1, C5.1, C6.1, D1.3 (VDD), D2.3 (VDD), D3.3 (VDD), D4.3 (VDD), D5.3 (VDD), D6.3 (VDD), D7.3 (VDD), J1.2 (VCC), J2.1 (VBUS), J3.7, J4.7, R3.1, U1.2 (UVCC), U1.7 (VBUS), U1.14 (VCC), U1.24 (AVCC), U1.34 (VCC), U1.44 (AVCC)

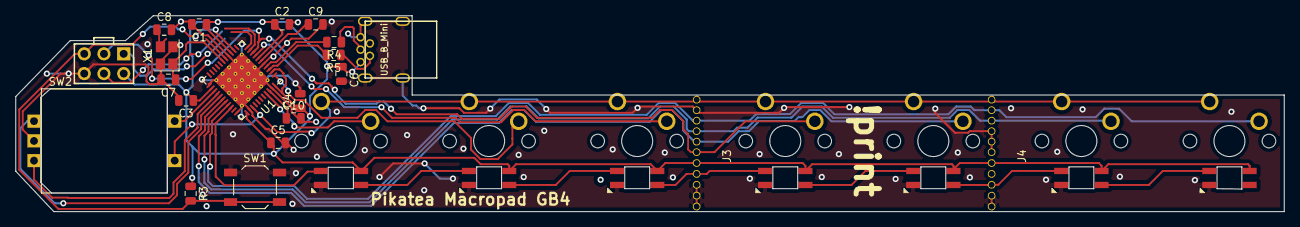
[picture p34: board Pikatea Macropad GB4.kicad_pcb from above]

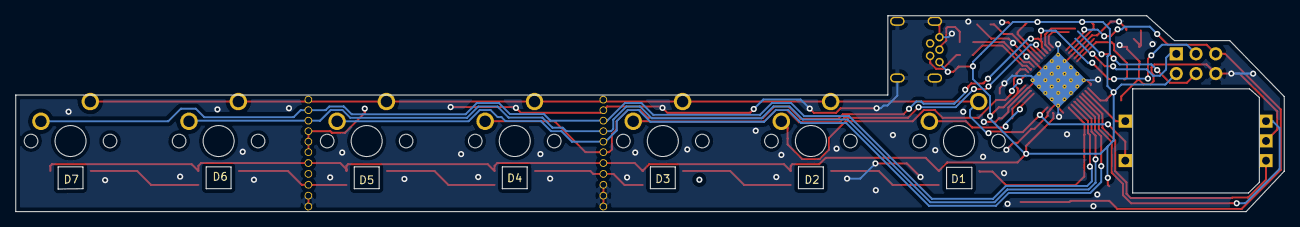
[picture p35: board Pikatea Macropad GB4.kicad_pcb from below]

Board: 2 copper layers, 163.2 x 25.2 mm, 35 parts (14 on the bottom side), 31 nets.
