JackPikatea/pikatea-macropad-deej-firmware/Pikatea R26 macropad/Pikatea R26 Macropad/Pikatea R26 PCB.kicad_pcb

## KiCad design Pikatea R26 macropad/Pikatea R26 Macropad/Pikatea R26 PCB.kicad_pcb (2022-03-21)

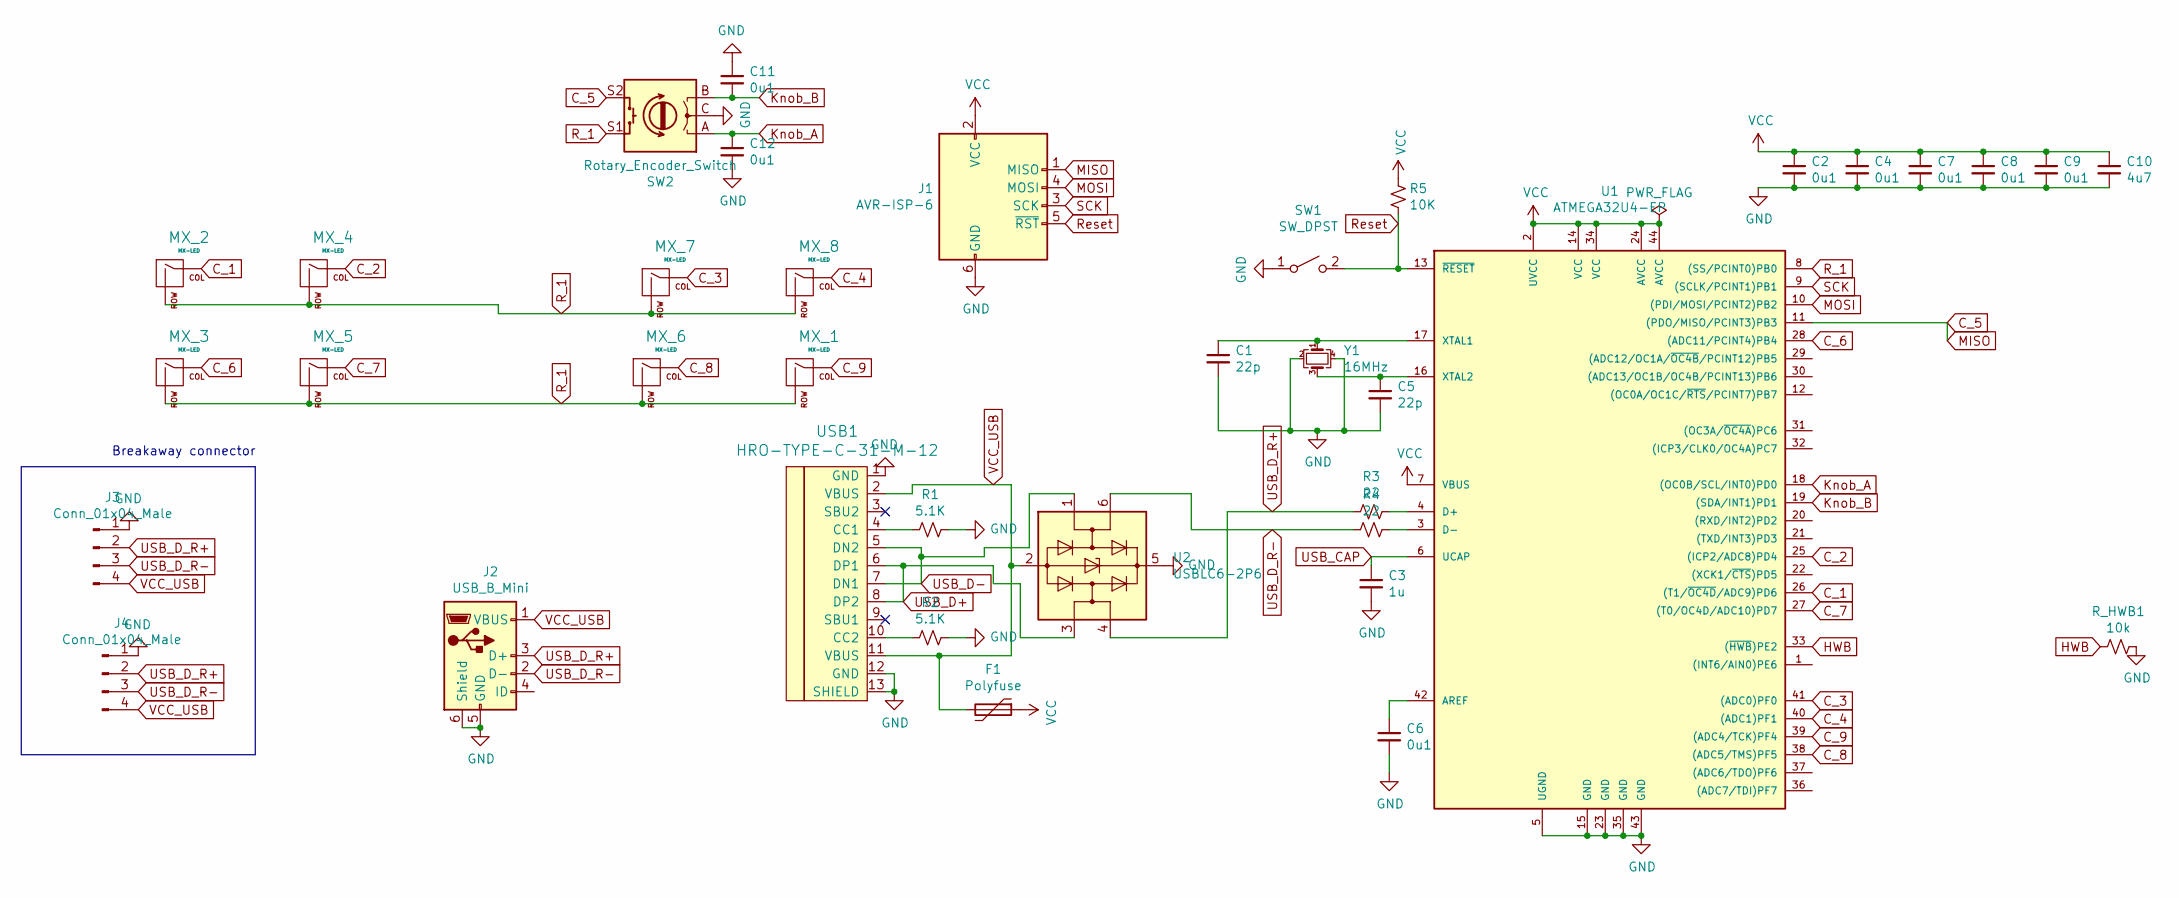
[picture p36: schematic Pikatea R26 PCB.sch]

Parts:
C1, C5: 22p; C_0603_1608Metric
C2, C4, C6, C7, C8, C9, C11, C12: 0u1; C_0603_1608Metric
C3: 1u; C_0603_1608Metric
C10: 4u7; C_0805_2012Metric
F1: Polyfuse; Fuse_1812_4532Metric
J1: AVR-ISP-6; AVR_ICSP_3x2
J2: USB_B_Mini; USB-Mini-B_ LCSC-C46398
J3: Conn_01x04_Male; Breakaway-Throughole-R26
J4: Conn_01x04_Male; Breakaway-Throughole-R26_2
MX_1, MX_2, MX_3, MX_4, MX_5, MX_6, MX_7, MX_8: MX-LED; MXOnly-1U-NoLED
R1, R2: 5.1K; R_0402_1005Metric
R3, R4: 22; R_0603_1608Metric
R5: 10K; R_0603_1608Metric
R_HWB1: 10k; R_0603_1608Metric
SW1: SW_DPST; SW_SPST_TL3342
SW2: Rotary_Encoder_Switch; Encoder-BI_EN11_HSM0E
U1: ATMEGA32U4-EP; QFN-44-1EP_7x7mm_P0.5mm_EP5.15x5.15mm
U2: USBLC6-2P6; SOT-666
USB1: HRO-TYPE-C-31-M-12
Y1: 16MHz; Crystal_SMD_SeikoEpson_FA238-4Pin_3.2x2.5mm

Connections:
C_1: MX_2.1 (COL), U1.26 ((T1/~OC4D~/ADC9)PD6)
C_2: MX_4.1 (COL), U1.25 ((ICP2/ADC8)PD4)
C_3: MX_7.1 (COL), U1.41 ((ADC0)PF0)
C_4: MX_8.1 (COL), U1.40 ((ADC1)PF1)
C_5: J1.1 (MISO), SW2.S2, U1.11 ((PDO/MISO/PCINT3)PB3)
C_6: MX_3.1 (COL), U1.28 ((ADC11/PCINT4)PB4)
C_7: MX_5.1 (COL), U1.27 ((T0/OC4D/ADC10)PD7)
C_8: MX_6.1 (COL), U1.38 ((ADC5/TMS)PF5)
C_9: MX_1.1 (COL), U1.39 ((ADC4/TCK)PF4)
GND: C1.2, C2.2, C3.2, C4.2, C5.2, C6.2, C7.2, C8.2, C9.2, C10.2, C11.1, C12.2, J1.6 (GND), J2.5 (GND), J2.6 (Shield), J3.1, J4.1, R1.1, R2.1, R_HWB1.1, SW1.1 (A), SW2.C, U1.5 (UGND), U1.15 (GND), U1.23 (GND), U1.35 (GND), U1.43 (GND), U2.5 (VBUS), USB1.1 (GND), USB1.12 (GND), USB1.13 (SHIELD), Y1.2, Y1.4
HWB: R_HWB1.2, U1.33 ((~HWB~)PE2)
Knob_A: C12.1, SW2.A, U1.18 ((OC0B/SCL/INT0)PD0)
Knob_B: C11.2, SW2.B, U1.19 ((SDA/INT1)PD1)
MOSI: J1.4 (MOSI), U1.10 ((PDI/MOSI/PCINT2)PB2)
unnamed: C1.1, U1.17 (XTAL1), Y1.1
unnamed: C5.1, U1.16 (XTAL2), Y1.3
unnamed: C6.1, U1.42 (AREF)
unnamed: R1.2, USB1.4 (CC1)
unnamed: R2.2, USB1.10 (CC2)
unnamed: R3.1, U1.4 (D+)
unnamed: R4.1, U1.3 (D-)
R_1: MX_1.2 (ROW), MX_2.2 (ROW), MX_3.2 (ROW), MX_4.2 (ROW), MX_5.2 (ROW), MX_6.2 (ROW), MX_7.2 (ROW), MX_8.2 (ROW), SW2.S1, U1.8 ((SS/PCINT0)PB0)
Reset: J1.5 (~RST), R5.2, SW1.2 (B), U1.13 (~RESET~)
SCK: J1.3 (SCK), U1.9 ((SCLK/PCINT1)PB1)
USB_CAP: C3.1, U1.6 (UCAP)
USB_D+: U2.3 (I/O2), USB1.6 (DP1), USB1.8 (DP2)
USB_D-: U2.1 (I/O1), USB1.5 (DN2), USB1.7 (DN1)
USB_D_R+: J2.3 (D+), J3.2, J4.2, R3.2, U2.4 (I/O2)
USB_D_R-: J2.2 (D-), J3.3, J4.3, R4.2, U2.6 (I/O1)
VCC: C2.1, C4.1, C7.1, C8.1, C9.1, C10.1, F1.1, J1.2 (VCC), R5.1, U1.2 (UVCC), U1.7 (VBUS), U1.14 (VCC), U1.24 (AVCC), U1.34 (VCC), U1.44 (AVCC)
VCC_USB: F1.2, J2.1 (VBUS), J3.4, J4.4, U2.2 (GND), USB1.2 (VBUS), USB1.11 (VBUS)

Notes on the sheet:
Breakaway connector

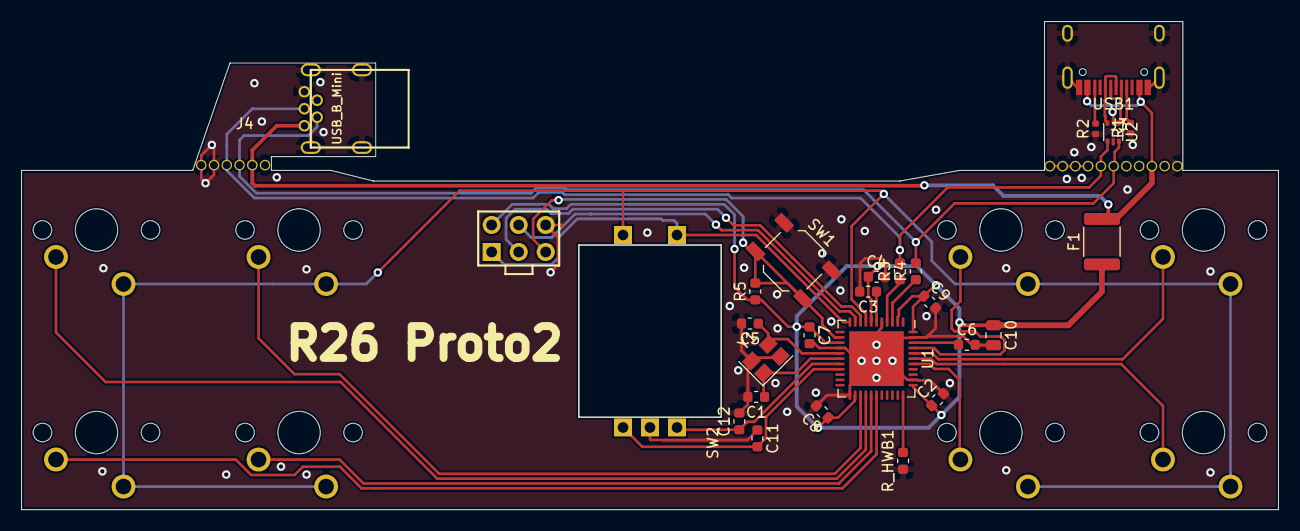
[picture p37: board Pikatea R26 PCB.kicad_pcb from above]

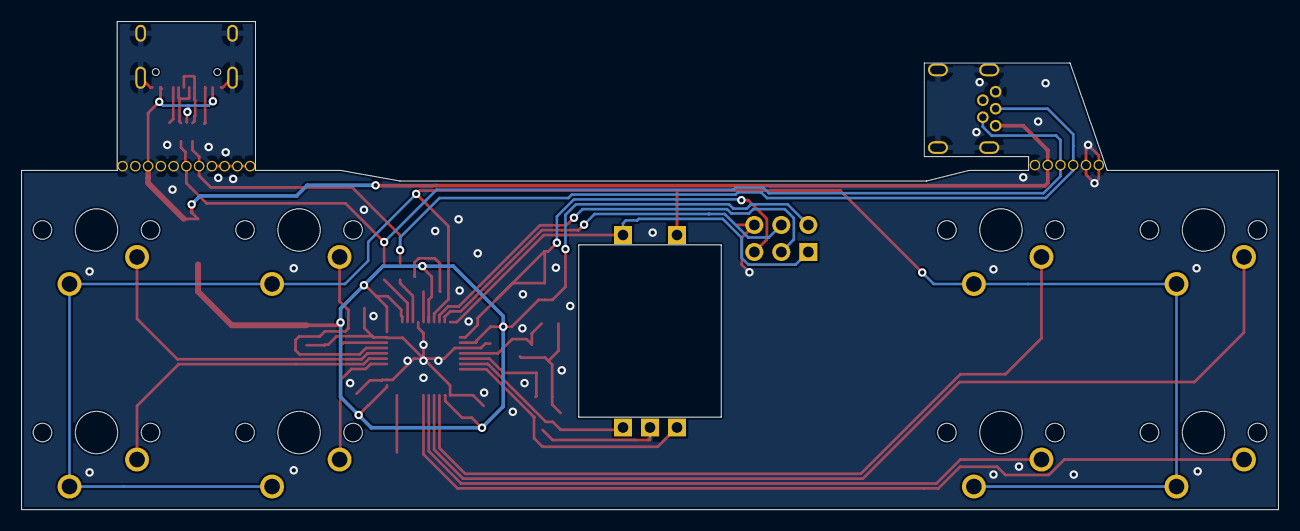
[picture p38: board Pikatea R26 PCB.kicad_pcb from below]

Board: 2 copper layers, 118.2 x 45.9 mm, 37 parts (8 on the bottom side), 31 nets.
