JackPikatea/pikatea-macropad-deej-firmware/Pikatea handwire helpers/2u Hand Wire Helpers/2u Hand Wire Helpers.kicad_pcb

## KiCad design Pikatea handwire helpers/2u Hand Wire Helpers/2u Hand Wire Helpers.kicad_pcb (2022-02-20)

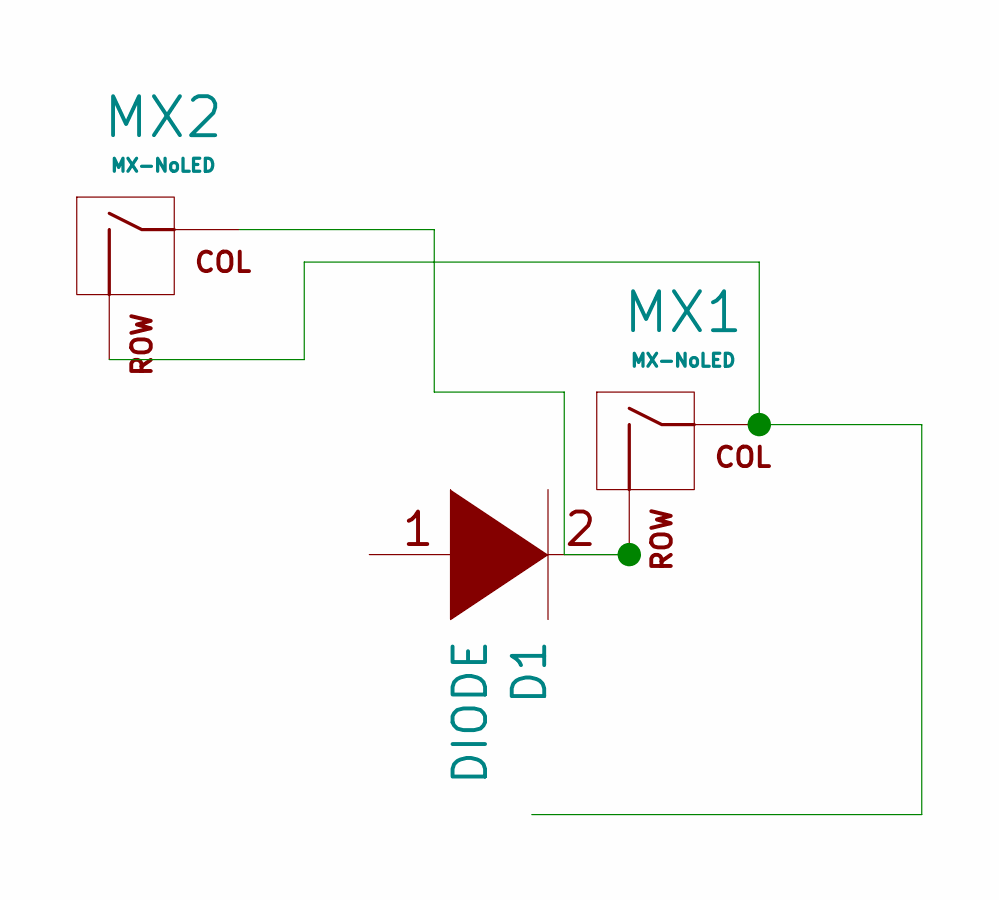
[picture p39: schematic 2u Hand Wire Helpers.sch]

Parts:
D1: DIODE; Diode Handwire helper
MX1: MX-NoLED; SW_Cherry_MX_2.00u_PCB
MX2: MX-NoLED; SW_Cherry_MX_1.00u_PCB

Connections:
unnamed: D1.2 (A), MX1.2 (ROW), MX2.1 (COL)
unnamed: MX1.1 (COL), MX2.2 (ROW)

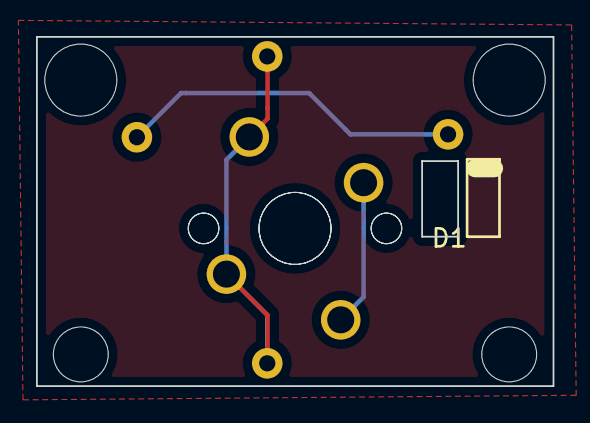
[picture p40: board 2u Hand Wire Helpers.kicad_pcb from above]

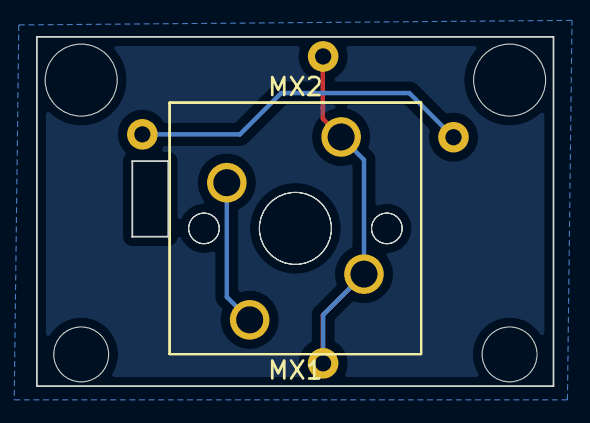
[picture p41: board 2u Hand Wire Helpers.kicad_pcb from below]

Board: 2 copper layers, 28.7 x 19.4 mm, 3 parts (2 on the bottom side), 2 nets.
