JackPikatea/pikatea-macropad-deej-firmware/FinnGus/FinnGusPCB/FinnGusPCB.kicad_pcb

## KiCad design FinnGus/FinnGusPCB/FinnGusPCB.kicad_pcb (2021-11-05)

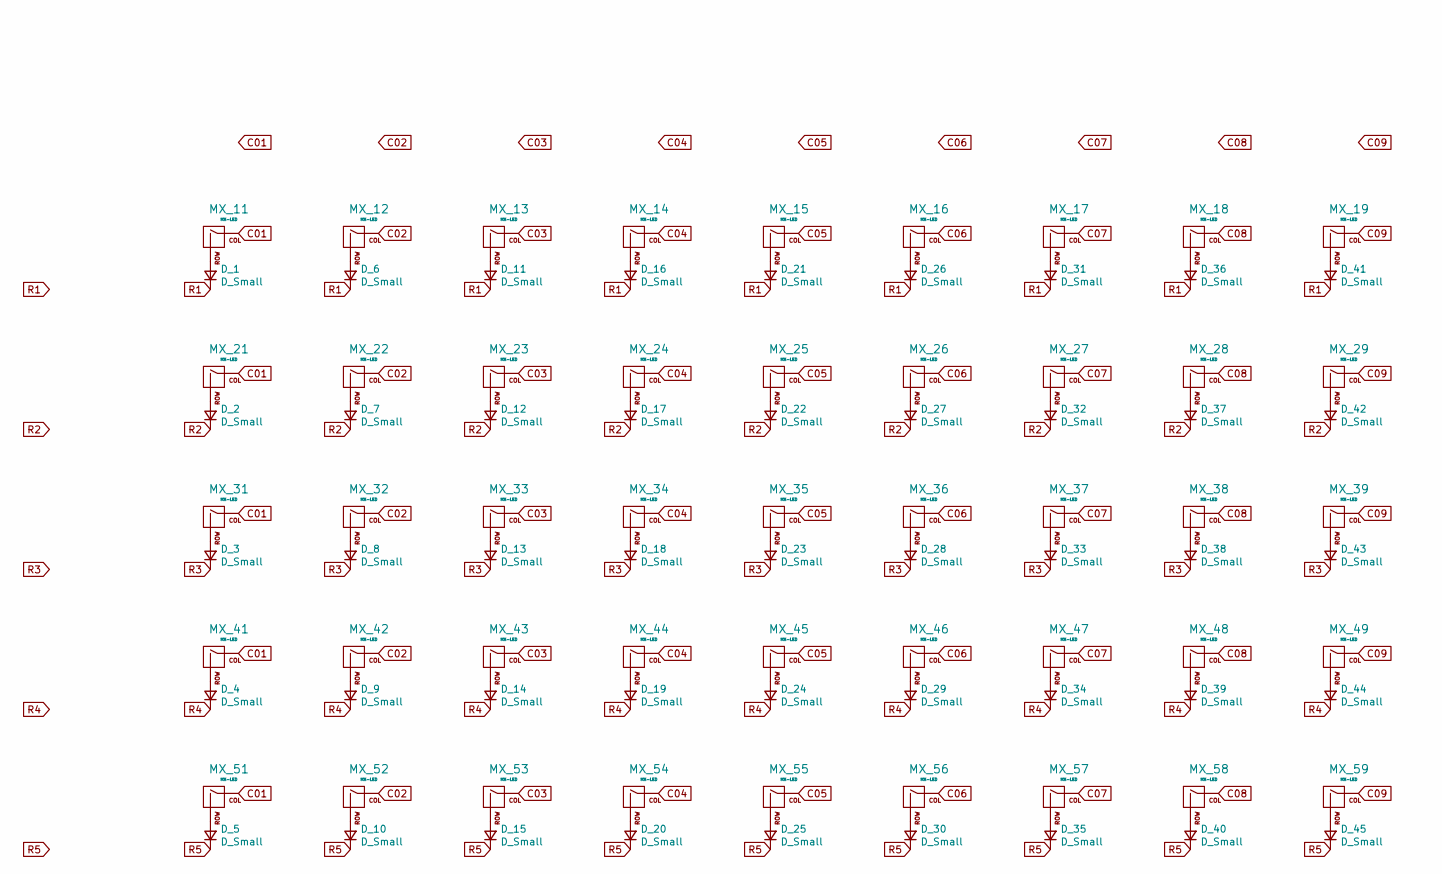
[picture p42: schematic FinnGusPCB.sch, part in row 1, column 1]

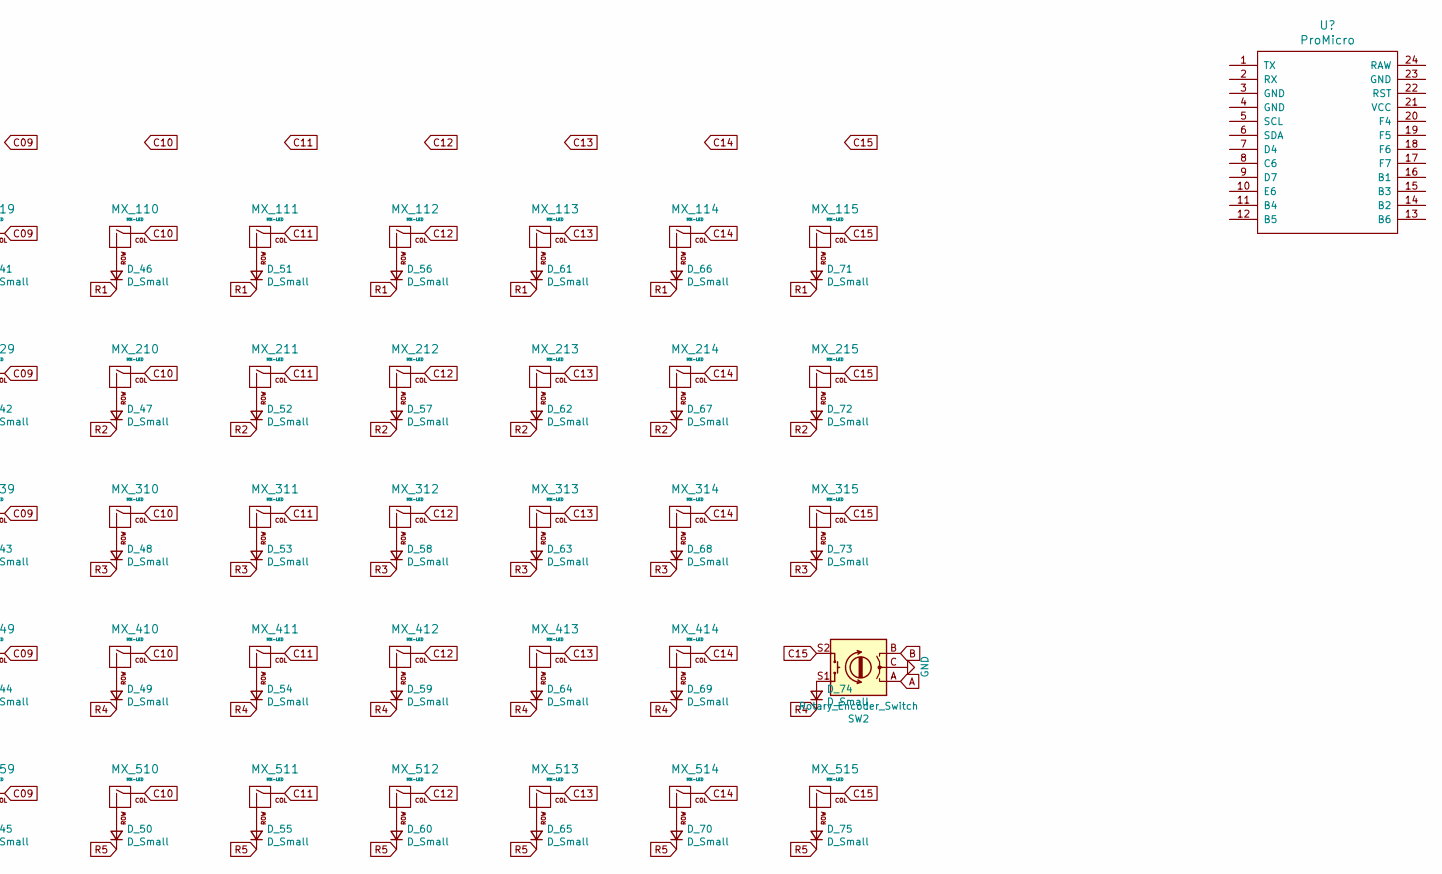
[picture p43: schematic FinnGusPCB.sch, part in row 1, column 2]

Parts:
D_1, D_2, D_3, D_4, D_5, D_6, D_7, D_8, D_9, D_10, D_11, D_12, D_13, D_14, D_15, D_16, D_17, D_18, D_19, D_20, D_21, D_22, D_23, D_24, D_25, D_26, D_27, D_28, D_29, D_30, D_31, D_32, D_33, D_34, D_35, D_36, D_37, D_38, D_39, D_40, D_41, D_42, D_43, D_44, D_45, D_46, D_47, D_48, D_49, D_50, D_51, D_52, D_53, D_54, D_55, D_56, D_57, D_58, D_59, D_60, D_61, D_62, D_63, D_64, D_65, D_66, D_67, D_68, D_69, D_70, D_71, D_72, D_73, D_74, D_75: D_Small; D_axial
MX_11, MX_12, MX_13, MX_14, MX_15, MX_16, MX_17, MX_18, MX_19, MX_21, MX_22, MX_23, MX_24, MX_25, MX_26, MX_27, MX_28, MX_29, MX_31, MX_32, MX_33, MX_34, MX_35, MX_36, MX_37, MX_38, MX_39, MX_41, MX_42, MX_43, MX_44, MX_45, MX_46, MX_47, MX_48, MX_49, MX_51, MX_52, MX_53, MX_54, MX_55, MX_56, MX_57, MX_58, MX_59, MX_110, MX_111, MX_112, MX_113, MX_114, MX_115, MX_210, MX_211, MX_212, MX_213, MX_214, MX_215, MX_310, MX_311, MX_312, MX_313, MX_314, MX_315, MX_410, MX_411, MX_412, MX_413, MX_414, MX_510, MX_511, MX_512, MX_513, MX_514, MX_515: MX-LED; MXOnly-1U-NoLED
SW2: Rotary_Encoder_Switch; Encoder-BI_EN11_HSM0E

Connections:
A: SW2.A; also elsewhere on the board
B: SW2.B; also elsewhere on the board
C01: MX_11.1 (COL), MX_21.1 (COL), MX_31.1 (COL), MX_41.1 (COL), MX_51.1 (COL); also elsewhere on the board
C02: MX_12.1 (COL), MX_22.1 (COL), MX_32.1 (COL), MX_42.1 (COL), MX_52.1 (COL); also elsewhere on the board
C03: MX_13.1 (COL), MX_23.1 (COL), MX_33.1 (COL), MX_43.1 (COL), MX_53.1 (COL); also elsewhere on the board
C04: MX_14.1 (COL), MX_24.1 (COL), MX_34.1 (COL), MX_44.1 (COL), MX_54.1 (COL); also elsewhere on the board
C05: MX_15.1 (COL), MX_25.1 (COL), MX_35.1 (COL), MX_45.1 (COL), MX_55.1 (COL); also elsewhere on the board
C06: MX_16.1 (COL), MX_26.1 (COL), MX_36.1 (COL), MX_46.1 (COL), MX_56.1 (COL); also elsewhere on the board
C07: MX_17.1 (COL), MX_27.1 (COL), MX_37.1 (COL), MX_47.1 (COL), MX_57.1 (COL); also elsewhere on the board
C08: MX_18.1 (COL), MX_28.1 (COL), MX_38.1 (COL), MX_48.1 (COL), MX_58.1 (COL); also elsewhere on the board
C09: MX_19.1 (COL), MX_29.1 (COL), MX_39.1 (COL), MX_49.1 (COL), MX_59.1 (COL); also elsewhere on the board
C10: MX_110.1 (COL), MX_210.1 (COL), MX_310.1 (COL), MX_410.1 (COL), MX_510.1 (COL); also elsewhere on the board
C11: MX_111.1 (COL), MX_211.1 (COL), MX_311.1 (COL), MX_411.1 (COL), MX_511.1 (COL); also elsewhere on the board
C12: MX_112.1 (COL), MX_212.1 (COL), MX_312.1 (COL), MX_412.1 (COL), MX_512.1 (COL); also elsewhere on the board
C13: MX_113.1 (COL), MX_213.1 (COL), MX_313.1 (COL), MX_413.1 (COL), MX_513.1 (COL); also elsewhere on the board
C14: MX_114.1 (COL), MX_214.1 (COL), MX_314.1 (COL), MX_414.1 (COL), MX_514.1 (COL); also elsewhere on the board
GND: SW2.C; also elsewhere on the board
unnamed: D_1.2 (A), MX_11.2 (ROW)
unnamed: D_2.2 (A), MX_21.2 (ROW)
unnamed: D_3.2 (A), MX_31.2 (ROW)
unnamed: D_4.2 (A), MX_41.2 (ROW)
unnamed: D_5.2 (A), MX_51.2 (ROW)
unnamed: D_6.2 (A), MX_12.2 (ROW)
unnamed: D_7.2 (A), MX_22.2 (ROW)
unnamed: D_8.2 (A), MX_32.2 (ROW)
unnamed: D_9.2 (A), MX_42.2 (ROW)
unnamed: D_10.2 (A), MX_52.2 (ROW)
unnamed: D_11.2 (A), MX_13.2 (ROW)
unnamed: D_12.2 (A), MX_23.2 (ROW)
unnamed: D_13.2 (A), MX_33.2 (ROW)
unnamed: D_14.2 (A), MX_43.2 (ROW)
unnamed: D_15.2 (A), MX_53.2 (ROW)
unnamed: D_16.2 (A), MX_14.2 (ROW)
unnamed: D_17.2 (A), MX_24.2 (ROW)
unnamed: D_18.2 (A), MX_34.2 (ROW)
unnamed: D_19.2 (A), MX_44.2 (ROW)
unnamed: D_20.2 (A), MX_54.2 (ROW)
unnamed: D_21.2 (A), MX_15.2 (ROW)
unnamed: D_22.2 (A), MX_25.2 (ROW)
unnamed: D_23.2 (A), MX_35.2 (ROW)
unnamed: D_24.2 (A), MX_45.2 (ROW)
unnamed: D_25.2 (A), MX_55.2 (ROW)
unnamed: D_26.2 (A), MX_16.2 (ROW)
unnamed: D_27.2 (A), MX_26.2 (ROW)
unnamed: D_28.2 (A), MX_36.2 (ROW)
unnamed: D_29.2 (A), MX_46.2 (ROW)
unnamed: D_30.2 (A), MX_56.2 (ROW)
unnamed: D_31.2 (A), MX_17.2 (ROW)
unnamed: D_32.2 (A), MX_27.2 (ROW)
unnamed: D_33.2 (A), MX_37.2 (ROW)
unnamed: D_34.2 (A), MX_47.2 (ROW)
unnamed: D_35.2 (A), MX_57.2 (ROW)
unnamed: D_36.2 (A), MX_18.2 (ROW)
unnamed: D_37.2 (A), MX_28.2 (ROW)
unnamed: D_38.2 (A), MX_38.2 (ROW)
unnamed: D_39.2 (A), MX_48.2 (ROW)
unnamed: D_40.2 (A), MX_58.2 (ROW)
unnamed: D_41.2 (A), MX_19.2 (ROW)
unnamed: D_42.2 (A), MX_29.2 (ROW)
unnamed: D_43.2 (A), MX_39.2 (ROW)
unnamed: D_44.2 (A), MX_49.2 (ROW)
unnamed: D_45.2 (A), MX_59.2 (ROW)
unnamed: D_46.2 (A), MX_110.2 (ROW)
unnamed: D_47.2 (A), MX_210.2 (ROW)
unnamed: D_48.2 (A), MX_310.2 (ROW)
unnamed: D_49.2 (A), MX_410.2 (ROW)
unnamed: D_50.2 (A), MX_510.2 (ROW)
unnamed: D_51.2 (A), MX_111.2 (ROW)
unnamed: D_52.2 (A), MX_211.2 (ROW)
unnamed: D_53.2 (A), MX_311.2 (ROW)
unnamed: D_54.2 (A), MX_411.2 (ROW)
unnamed: D_55.2 (A), MX_511.2 (ROW)
unnamed: D_56.2 (A), MX_112.2 (ROW)
unnamed: D_57.2 (A), MX_212.2 (ROW)
unnamed: D_58.2 (A), MX_312.2 (ROW)
unnamed: D_59.2 (A), MX_412.2 (ROW)
unnamed: D_60.2 (A), MX_512.2 (ROW)
unnamed: D_61.2 (A), MX_113.2 (ROW)
unnamed: D_62.2 (A), MX_213.2 (ROW)
unnamed: D_63.2 (A), MX_313.2 (ROW)
unnamed: D_64.2 (A), MX_413.2 (ROW)
unnamed: D_65.2 (A), MX_513.2 (ROW)
unnamed: D_66.2 (A), MX_114.2 (ROW)
unnamed: D_67.2 (A), MX_214.2 (ROW)
unnamed: D_68.2 (A), MX_314.2 (ROW)
unnamed: D_69.2 (A), MX_414.2 (ROW)
unnamed: D_70.2 (A), MX_514.2 (ROW)
unnamed: D_71.2 (A), MX_115.2 (ROW)
unnamed: D_72.2 (A), MX_215.2 (ROW)
unnamed: D_73.2 (A), MX_315.2 (ROW)
unnamed: D_75.2 (A), MX_515.2 (ROW)
R1: D_1.1 (K), D_6.1 (K), D_11.1 (K), D_16.1 (K), D_21.1 (K), D_26.1 (K), D_31.1 (K), D_36.1 (K), D_41.1 (K), D_46.1 (K), D_51.1 (K), D_56.1 (K), D_61.1 (K), D_66.1 (K), D_71.1 (K); also elsewhere on the board
R2: D_2.1 (K), D_7.1 (K), D_12.1 (K), D_17.1 (K), D_22.1 (K), D_27.1 (K), D_32.1 (K), D_37.1 (K), D_42.1 (K), D_47.1 (K), D_52.1 (K), D_57.1 (K), D_62.1 (K), D_67.1 (K), D_72.1 (K); also elsewhere on the board
R3: D_3.1 (K), D_8.1 (K), D_13.1 (K), D_18.1 (K), D_23.1 (K), D_28.1 (K), D_33.1 (K), D_38.1 (K), D_43.1 (K), D_48.1 (K), D_53.1 (K), D_58.1 (K), D_63.1 (K), D_68.1 (K), D_73.1 (K); also elsewhere on the board
R4: D_4.1 (K), D_9.1 (K), D_14.1 (K), D_19.1 (K), D_24.1 (K), D_29.1 (K), D_34.1 (K), D_39.1 (K), D_44.1 (K), D_49.1 (K), D_54.1 (K), D_59.1 (K), D_64.1 (K), D_69.1 (K), D_74.1 (K); also elsewhere on the board
R5: D_5.1 (K), D_10.1 (K), D_15.1 (K), D_20.1 (K), D_25.1 (K), D_30.1 (K), D_35.1 (K), D_40.1 (K), D_45.1 (K), D_50.1 (K), D_55.1 (K), D_60.1 (K), D_65.1 (K), D_70.1 (K), D_75.1 (K); also elsewhere on the board

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
Board: 2 copper layers, 152 parts (71 on the bottom side), 98 nets, no tracks yet.

Other parts of the board:
D_152: D_Small; D_axial
U2: Teensy2.0_(Arduino); Teensy2.0

Their connections:
A: U2.24; also elsewhere on the board
B: U2.23; also elsewhere on the board
C01: U2.27; also elsewhere on the board
C02: U2.28; also elsewhere on the board
C03: U2.12; also elsewhere on the board
C04: U2.11; also elsewhere on the board
C05: U2.10; also elsewhere on the board
C06: U2.9; also elsewhere on the board
C07: U2.21; also elsewhere on the board
C08: U2.6; also elsewhere on the board
C09: U2.5; also elsewhere on the board
C10: U2.4; also elsewhere on the board
C11: U2.2; also elsewhere on the board
C12: U2.3; also elsewhere on the board
C13: U2.30; also elsewhere on the board
C14: U2.17; also elsewhere on the board
GND: U2.1, U2.15; also elsewhere on the board
R1: U2.13; also elsewhere on the board
R2: U2.25; also elsewhere on the board
R3: U2.19; also elsewhere on the board
R4: U2.20; also elsewhere on the board
R5: U2.22; also elsewhere on the board
