JackPikatea/pikatea-macropad-deej-firmware/Pikatea Macropad GB3 Addon/Pikatea Macropad GB3 Addon.kicad_pcb

## KiCad design Pikatea Macropad GB3 Addon/Pikatea Macropad GB3 Addon.kicad_pcb (2021-09-28)

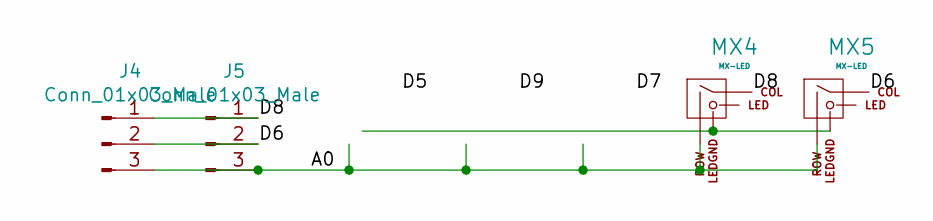
[picture p44: schematic Pikatea Macropad GB3 Addon.sch]

Parts:
J4, J5: Conn_01x03_Male; PinHeader_1x03_P2.54mm_Vertical
MX4, MX5: MX-LED; MXOnly-1U

Connections:
/A0: J4.3, J5.3, MX4.2 (ROW), MX5.2 (ROW)
/D6: J4.2, J5.2, MX5.1 (COL)
/D8: J4.1, J5.1, MX4.1 (COL)
unnamed: MX4.4 (LEDGND), MX5.4 (LEDGND)

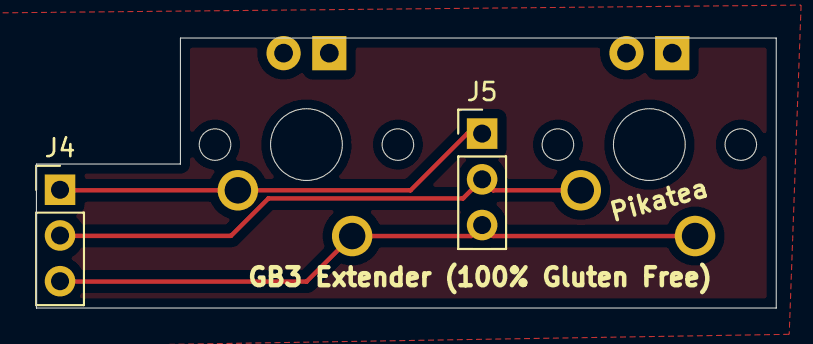
[picture p45: board Pikatea Macropad GB3 Addon.kicad_pcb from above]

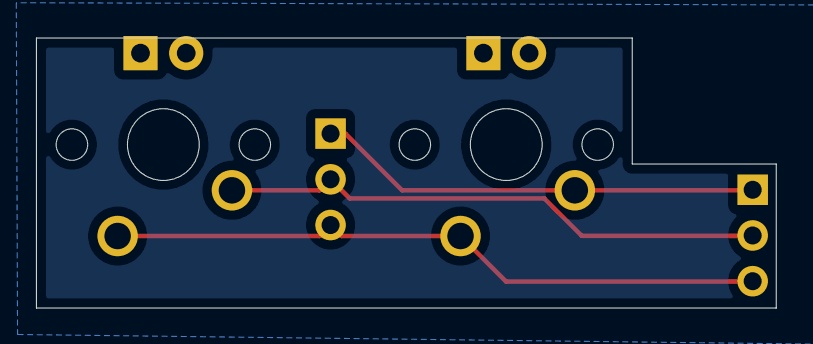
[picture p46: board Pikatea Macropad GB3 Addon.kicad_pcb from below]

Board: 2 copper layers, 41.1 x 15.0 mm, 4 parts (2 on the bottom side), 4 nets.
