JackPikatea/pikatea-macropad-deej-firmware/Pikatea Keyboard ProMicro/Pikatea Keyboard Pro Micro.kicad_pcb

## KiCad design Pikatea Keyboard ProMicro/Pikatea Keyboard Pro Micro.kicad_pcb (2021-06-23)

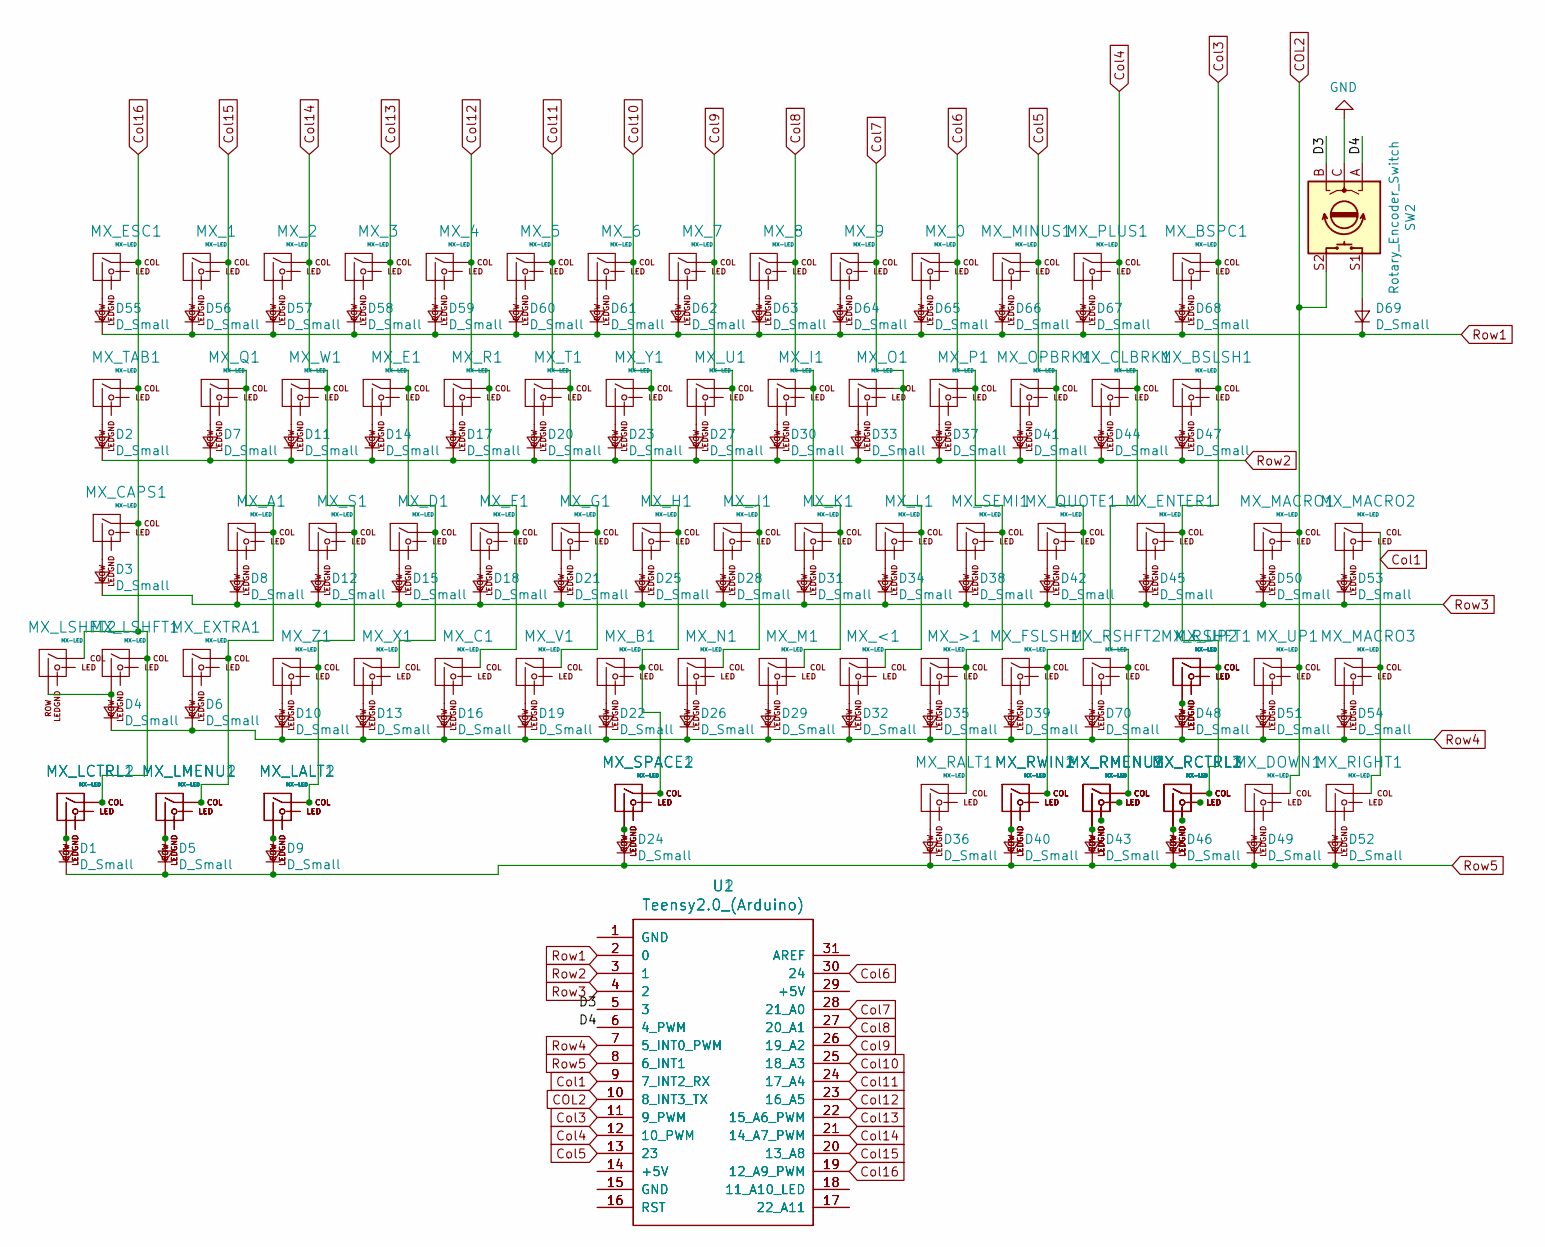
[picture p47: schematic Pikatea Keyboard Pro Micro.sch]

Parts:
D1, D2, D3, D4, D5, D6, D7, D8, D9, D10, D11, D12, D13, D14, D15, D16, D17, D18, D19, D20, D21, D22, D23, D24, D25, D26, D27, D28, D29, D30, D31, D32, D33, D34, D35, D36, D37, D38, D39, D40, D41, D42, D43, D44, D45, D46, D47, D48, D49, D50, D51, D52, D53, D54, D55, D56, D57, D58, D59, D60, D61, D62, D63, D64, D65, D66, D67, D68, D69, D70: D_Small; D_SOD-123
MX_0, MX_3, MX_4, MX_5, MX_6, MX_7, MX_8, MX_9: MX-LED; MXOnly-1U
MX_1, MX_2: MX-LED; MXOnly-1U-FLIPPED
MX_<1: MX-LED; MXOnly-1U
MX_>1: MX-LED; MXOnly-1U
MX_A1: MX-LED; MXOnly-1U-FLIPPED
MX_B1: MX-LED; MXOnly-1U
MX_BSLSH1: MX-LED; MXOnly-1.5U-FLIPPED
MX_BSPC1: MX-LED; MXOnly-2U-FLIPPED
MX_C1: MX-LED; MXOnly-1U
MX_CAPS1: MX-LED; MXOnly-1.75U-FLIPPED
MX_CLBRK1: MX-LED; MXOnly-1U
MX_D1: MX-LED; MXOnly-1U
MX_DOWN1: MX-LED; MXOnly-1U
MX_E1: MX-LED; MXOnly-1U
MX_ENTER1: MX-LED; MXOnly-2.25U-FLIPPED-ReversedStabilizers
MX_ESC1: MX-LED; MXOnly-1U-FLIPPED
MX_EXTRA1: MX-LED; MXOnly-1U-FLIPPED
MX_F1: MX-LED; MXOnly-1U
MX_FSLSH1: MX-LED; MXOnly-1U
MX_G1: MX-LED; MXOnly-1U
MX_H1: MX-LED; MXOnly-1U
MX_I1: MX-LED; MXOnly-1U
MX_J1: MX-LED; MXOnly-1U
MX_K1: MX-LED; MXOnly-1U
MX_L1: MX-LED; MXOnly-1U
MX_LALT1: MX-LED; MXOnly-1.25U-FLIPPED
MX_LALT2: MX-LED; MXOnly-1.5U-FLIPPED
MX_LCTRL1: MX-LED; MXOnly-1.25U-FLIPPED
MX_LCTRL2: MX-LED; MXOnly-1.5U-FLIPPED
MX_LMENU1: MX-LED; MXOnly-1.25U-FLIPPED
MX_LMENU2: MX-LED; MXOnly-1U-FLIPPED
MX_LSHFT1: MX-LED; MXOnly-2.25U-FLIPPED-ReversedStabilizers
MX_LSHFT2: MX-LED; MXOnly-1.25U-FLIPPED
MX_M1: MX-LED; MXOnly-1U
MX_MACRO1, MX_MACRO2, MX_MACRO3: MX-LED; MXOnly-1U
MX_MINUS1: MX-LED; MXOnly-1U
MX_N1: MX-LED; MXOnly-1U
MX_O1: MX-LED; MXOnly-1U
MX_OPBRK1: MX-LED; MXOnly-1U
MX_P1: MX-LED; MXOnly-1U
MX_PLUS1: MX-LED; MXOnly-1U
MX_Q1: MX-LED; MXOnly-1U-FLIPPED
MX_QUOTE1: MX-LED; MXOnly-1U
MX_R1: MX-LED; MXOnly-1U
MX_RALT1: MX-LED; MXOnly-1.25U-FLIPPED
MX_RCTRL1: MX-LED; MXOnly-1.25U-FLIPPED
MX_RCTRL2: MX-LED; MXOnly-1.5U-FLIPPED
MX_RCTRL3: MX-LED; MXOnly-1U
MX_RIGHT1: MX-LED; MXOnly-1U
MX_RMENU1: MX-LED; MXOnly-1.25U-FLIPPED
MX_RMENU2: MX-LED; MXOnly-1.5U-FLIPPED
MX_RMENU3: MX-LED; MXOnly-1U-FLIPPED
MX_RSHFT1: MX-LED; MXOnly-2.75U-FLIPPED-ReversedStabilizers
MX_RSHFT2: MX-LED; MXOnly-1.75U-FLIPPED
MX_RWIN1: MX-LED; MXOnly-1.25U-FLIPPED
MX_RWIN2: MX-LED; MXOnly-1U-FLIPPED
MX_S1: MX-LED; MXOnly-1U
MX_SEMI1: MX-LED; MXOnly-1U
MX_SPACE1: MX-LED; MXOnly-6.25U-FLIPPED-ReversedStabilizers
MX_SPACE2: MX-LED; MXOnly-7U-FLIPPED-ReversedStabilizers
MX_T1: MX-LED; MXOnly-1U
MX_TAB1: MX-LED; MXOnly-1.5U-FLIPPED
MX_U1: MX-LED; MXOnly-1U
MX_UP1, MX_UP2: MX-LED; MXOnly-1U
MX_V1: MX-LED; MXOnly-1U
MX_W1: MX-LED; MXOnly-1U
MX_X1: MX-LED; MXOnly-1U
MX_Y1: MX-LED; MXOnly-1U
MX_Z1: MX-LED; MXOnly-1U
SW2: Rotary_Encoder_Switch; Encoder-BI_EN11_HSM0E
U1, U2: Teensy2.0_(Arduino); Teensy2.0

Connections:
/D3: SW2.B, U1.5 (3), U2.5 (3)
/D4: SW2.A, U1.6 (4_PWM), U2.6 (4_PWM)
COL2: MX_DOWN1.1 (COL), MX_MACRO1.1 (COL), MX_UP1.1 (COL), SW2.S2, U1.10 (8_INT3_TX), U2.10 (8_INT3_TX)
Col1: MX_MACRO2.1 (COL), MX_MACRO3.1 (COL), MX_RIGHT1.1 (COL), U1.9 (7_INT2_RX), U2.9 (7_INT2_RX)
Col3: MX_BSLSH1.1 (COL), MX_BSPC1.1 (COL), MX_ENTER1.1 (COL), MX_RCTRL1.1 (COL), MX_RCTRL2.1 (COL), MX_RCTRL3.1 (COL), MX_RSHFT1.1 (COL), MX_UP2.1 (COL), U1.11 (9_PWM), U2.11 (9_PWM)
Col4: MX_CLBRK1.1 (COL), MX_PLUS1.1 (COL), MX_RMENU1.1 (COL), MX_RMENU2.1 (COL), MX_RMENU3.1 (COL), MX_RSHFT2.1 (COL), U1.12 (10_PWM), U2.12 (10_PWM)
Col5: MX_FSLSH1.1 (COL), MX_MINUS1.1 (COL), MX_OPBRK1.1 (COL), MX_QUOTE1.1 (COL), MX_RWIN1.1 (COL), MX_RWIN2.1 (COL), U1.13 (23), U2.13 (23)
Col6: MX_0.1 (COL), MX_>1.1 (COL), MX_P1.1 (COL), MX_RALT1.1 (COL), MX_SEMI1.1 (COL), U1.30 (24), U2.30 (24)
Col7: MX_9.1 (COL), MX_<1.1 (COL), MX_L1.1 (COL), MX_O1.1 (COL), U1.28 (21_A0), U2.28 (21_A0)
Col8: MX_8.1 (COL), MX_I1.1 (COL), MX_K1.1 (COL), MX_M1.1 (COL), U1.27 (20_A1), U2.27 (20_A1)
Col9: MX_7.1 (COL), MX_J1.1 (COL), MX_N1.1 (COL), MX_U1.1 (COL), U1.26 (19_A2), U2.26 (19_A2)
Col10: MX_6.1 (COL), MX_B1.1 (COL), MX_H1.1 (COL), MX_SPACE1.1 (COL), MX_SPACE2.1 (COL), MX_Y1.1 (COL), U1.25 (18_A3), U2.25 (18_A3)
Col11: MX_5.1 (COL), MX_G1.1 (COL), MX_T1.1 (COL), MX_V1.1 (COL), U1.24 (17_A4), U2.24 (17_A4)
Col12: MX_4.1 (COL), MX_C1.1 (COL), MX_F1.1 (COL), MX_R1.1 (COL), U1.23 (16_A5), U2.23 (16_A5)
Col13: MX_3.1 (COL), MX_D1.1 (COL), MX_E1.1 (COL), MX_X1.1 (COL), U1.22 (15_A6_PWM), U2.22 (15_A6_PWM)
Col14: MX_2.1 (COL), MX_LALT1.1 (COL), MX_LALT2.1 (COL), MX_S1.1 (COL), MX_W1.1 (COL), MX_Z1.1 (COL), U1.21 (14_A7_PWM), U2.21 (14_A7_PWM)
Col15: MX_1.1 (COL), MX_A1.1 (COL), MX_EXTRA1.1 (COL), MX_LMENU1.1 (COL), MX_LMENU2.1 (COL), MX_Q1.1 (COL), U1.20 (13_A8), U2.20 (13_A8)
Col16: MX_CAPS1.1 (COL), MX_ESC1.1 (COL), MX_LCTRL1.1 (COL), MX_LCTRL2.1 (COL), MX_LSHFT1.1 (COL), MX_LSHFT2.1 (COL), MX_TAB1.1 (COL), U1.19 (12_A9_PWM), U2.19 (12_A9_PWM)
GND: SW2.C
unnamed: D1.2 (A), MX_LCTRL1.2 (ROW), MX_LCTRL2.2 (ROW)
unnamed: D2.2 (A), MX_TAB1.2 (ROW)
unnamed: D3.2 (A), MX_CAPS1.2 (ROW)
unnamed: D4.2 (A), MX_LSHFT1.2 (ROW), MX_LSHFT2.2 (ROW)
unnamed: D5.2 (A), MX_LMENU1.2 (ROW), MX_LMENU2.2 (ROW)
unnamed: D6.2 (A), MX_EXTRA1.2 (ROW)
unnamed: D7.2 (A), MX_Q1.2 (ROW)
unnamed: D8.2 (A), MX_A1.2 (ROW)
unnamed: D9.2 (A), MX_LALT1.2 (ROW), MX_LALT2.2 (ROW)
unnamed: D10.2 (A), MX_Z1.2 (ROW)
unnamed: D11.2 (A), MX_W1.2 (ROW)
unnamed: D12.2 (A), MX_S1.2 (ROW)
unnamed: D13.2 (A), MX_X1.2 (ROW)
unnamed: D14.2 (A), MX_E1.2 (ROW)
unnamed: D15.2 (A), MX_D1.2 (ROW)
unnamed: D16.2 (A), MX_C1.2 (ROW)
unnamed: D17.2 (A), MX_R1.2 (ROW)
unnamed: D18.2 (A), MX_F1.2 (ROW)
unnamed: D19.2 (A), MX_V1.2 (ROW)
unnamed: D20.2 (A), MX_T1.2 (ROW)
unnamed: D21.2 (A), MX_G1.2 (ROW)
unnamed: D22.2 (A), MX_B1.2 (ROW)
unnamed: D23.2 (A), MX_Y1.2 (ROW)
unnamed: D24.2 (A), MX_SPACE1.2 (ROW), MX_SPACE2.2 (ROW)
unnamed: D25.2 (A), MX_H1.2 (ROW)
unnamed: D26.2 (A), MX_N1.2 (ROW)
unnamed: D27.2 (A), MX_U1.2 (ROW)
unnamed: D28.2 (A), MX_J1.2 (ROW)
unnamed: D29.2 (A), MX_M1.2 (ROW)
unnamed: D30.2 (A), MX_I1.2 (ROW)
unnamed: D31.2 (A), MX_K1.2 (ROW)
unnamed: D32.2 (A), MX_<1.2 (ROW)
unnamed: D33.2 (A), MX_O1.2 (ROW)
unnamed: D34.2 (A), MX_L1.2 (ROW)
unnamed: D35.2 (A), MX_>1.2 (ROW)
unnamed: D36.2 (A), MX_RALT1.2 (ROW)
unnamed: D37.2 (A), MX_P1.2 (ROW)
unnamed: D38.2 (A), MX_SEMI1.2 (ROW)
unnamed: D39.2 (A), MX_FSLSH1.2 (ROW)
unnamed: D40.2 (A), MX_RWIN1.2 (ROW), MX_RWIN2.2 (ROW)
unnamed: D41.2 (A), MX_OPBRK1.2 (ROW)
unnamed: D42.2 (A), MX_QUOTE1.2 (ROW)
unnamed: D43.2 (A), MX_RMENU1.2 (ROW), MX_RMENU2.2 (ROW), MX_RMENU3.2 (ROW)
unnamed: D44.2 (A), MX_CLBRK1.2 (ROW)
unnamed: D45.2 (A), MX_ENTER1.2 (ROW)
unnamed: D46.2 (A), MX_RCTRL1.2 (ROW), MX_RCTRL2.2 (ROW), MX_RCTRL3.2 (ROW)
unnamed: D47.2 (A), MX_BSLSH1.2 (ROW)
unnamed: D48.2 (A), MX_RSHFT1.2 (ROW), MX_UP2.2 (ROW)
unnamed: D49.2 (A), MX_DOWN1.2 (ROW)
unnamed: D50.2 (A), MX_MACRO1.2 (ROW)
unnamed: D51.2 (A), MX_UP1.2 (ROW)
unnamed: D52.2 (A), MX_RIGHT1.2 (ROW)
unnamed: D53.2 (A), MX_MACRO2.2 (ROW)
unnamed: D54.2 (A), MX_MACRO3.2 (ROW)
unnamed: D55.2 (A), MX_ESC1.2 (ROW)
unnamed: D56.2 (A), MX_1.2 (ROW)
unnamed: D57.2 (A), MX_2.2 (ROW)
unnamed: D58.2 (A), MX_3.2 (ROW)
unnamed: D59.2 (A), MX_4.2 (ROW)
unnamed: D60.2 (A), MX_5.2 (ROW)
unnamed: D61.2 (A), MX_6.2 (ROW)
unnamed: D62.2 (A), MX_7.2 (ROW)
unnamed: D63.2 (A), MX_8.2 (ROW)
unnamed: D64.2 (A), MX_9.2 (ROW)
unnamed: D65.2 (A), MX_0.2 (ROW)
unnamed: D66.2 (A), MX_MINUS1.2 (ROW)
unnamed: D67.2 (A), MX_PLUS1.2 (ROW)
unnamed: D68.2 (A), MX_BSPC1.2 (ROW)
unnamed: D69.2 (A), SW2.S1
unnamed: D70.2 (A), MX_RSHFT2.2 (ROW)
unnamed: MX_LALT1.3 (LED), MX_LALT2.3 (LED)
unnamed: MX_LALT1.4 (LEDGND), MX_LALT2.4 (LEDGND)
unnamed: MX_LCTRL1.3 (LED), MX_LCTRL2.3 (LED)
unnamed: MX_LCTRL1.4 (LEDGND), MX_LCTRL2.4 (LEDGND)
unnamed: MX_LMENU1.3 (LED), MX_LMENU2.3 (LED)
unnamed: MX_LMENU1.4 (LEDGND), MX_LMENU2.4 (LEDGND)
unnamed: MX_RCTRL1.3 (LED), MX_RCTRL2.3 (LED), MX_RCTRL3.3 (LED)
unnamed: MX_RCTRL1.4 (LEDGND), MX_RCTRL2.4 (LEDGND), MX_RCTRL3.4 (LEDGND)
unnamed: MX_RMENU1.3 (LED), MX_RMENU2.3 (LED), MX_RMENU3.3 (LED)
unnamed: MX_RMENU1.4 (LEDGND), MX_RMENU2.4 (LEDGND), MX_RMENU3.4 (LEDGND)
unnamed: MX_RSHFT1.3 (LED), MX_UP2.3 (LED)
unnamed: MX_RSHFT1.4 (LEDGND), MX_UP2.4 (LEDGND)
unnamed: MX_RWIN1.3 (LED), MX_RWIN2.3 (LED)
unnamed: MX_RWIN1.4 (LEDGND), MX_RWIN2.4 (LEDGND)
unnamed: MX_SPACE1.3 (LED), MX_SPACE2.3 (LED)
unnamed: MX_SPACE1.4 (LEDGND), MX_SPACE2.4 (LEDGND)
unnamed: U1.1 (GND), U2.1 (GND)
unnamed: U1.14 (+5V), U2.14 (+5V)
unnamed: U1.15 (GND), U2.15 (GND)
unnamed: U1.16 (RST), U2.16 (RST)
unnamed: U1.17 (22_A11), U2.17 (22_A11)
unnamed: U1.18 (11_A10_LED), U2.18 (11_A10_LED)
unnamed: U1.29 (+5V), U2.29 (+5V)
unnamed: U1.31 (AREF), U2.31 (AREF)
Row1: D55.1 (K), D56.1 (K), D57.1 (K), D58.1 (K), D59.1 (K), D60.1 (K), D61.1 (K), D62.1 (K), D63.1 (K), D64.1 (K), D65.1 (K), D66.1 (K), D67.1 (K), D68.1 (K), D69.1 (K), U1.2 (0), U2.2 (0)
Row2: D2.1 (K), D7.1 (K), D11.1 (K), D14.1 (K), D17.1 (K), D20.1 (K), D23.1 (K), D27.1 (K), D30.1 (K), D33.1 (K), D37.1 (K), D41.1 (K), D44.1 (K), D47.1 (K), U1.3 (1), U2.3 (1)
Row3: D3.1 (K), D8.1 (K), D12.1 (K), D15.1 (K), D18.1 (K), D21.1 (K), D25.1 (K), D28.1 (K), D31.1 (K), D34.1 (K), D38.1 (K), D42.1 (K), D45.1 (K), D50.1 (K), D53.1 (K), U1.4 (2), U2.4 (2)
Row4: D4.1 (K), D6.1 (K), D10.1 (K), D13.1 (K), D16.1 (K), D19.1 (K), D22.1 (K), D26.1 (K), D29.1 (K), D32.1 (K), D35.1 (K), D39.1 (K), D48.1 (K), D51.1 (K), D54.1 (K), D70.1 (K), U1.7 (5_INT0_PWM), U2.7 (5_INT0_PWM)
Row5: D1.1 (K), D5.1 (K), D9.1 (K), D24.1 (K), D36.1 (K), D40.1 (K), D43.1 (K), D46.1 (K), D49.1 (K), D52.1 (K), U1.8 (6_INT1), U2.8 (6_INT1)

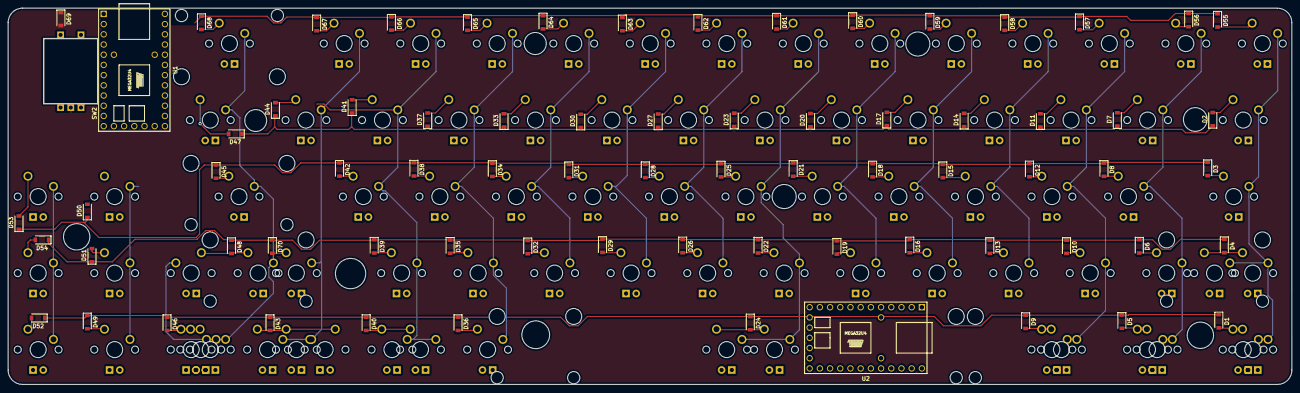
[picture p48: board Pikatea Keyboard Pro Micro.kicad_pcb from above]

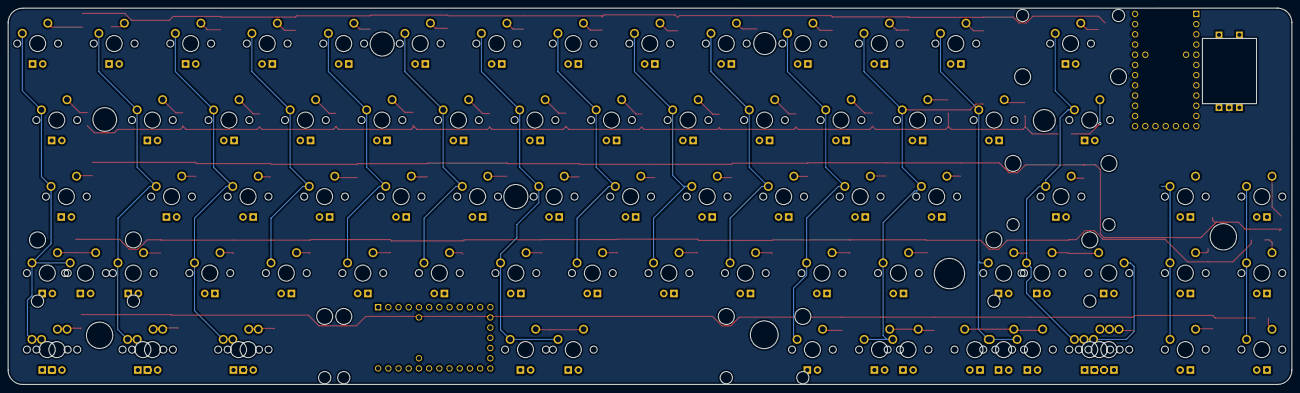
[picture p49: board Pikatea Keyboard Pro Micro.kicad_pcb from below]

Board: 2 copper layers, 319.6 x 93.7 mm, 153 parts (78 on the bottom side), 117 nets.
