JackPikatea/pikatea-macropad-deej-firmware/4 button Macropad(2)/BigSwitch.kicad_pcb

## KiCad design 4 button Macropad(2)/BigSwitch.kicad_pcb (2021-06-23, an earlier design)

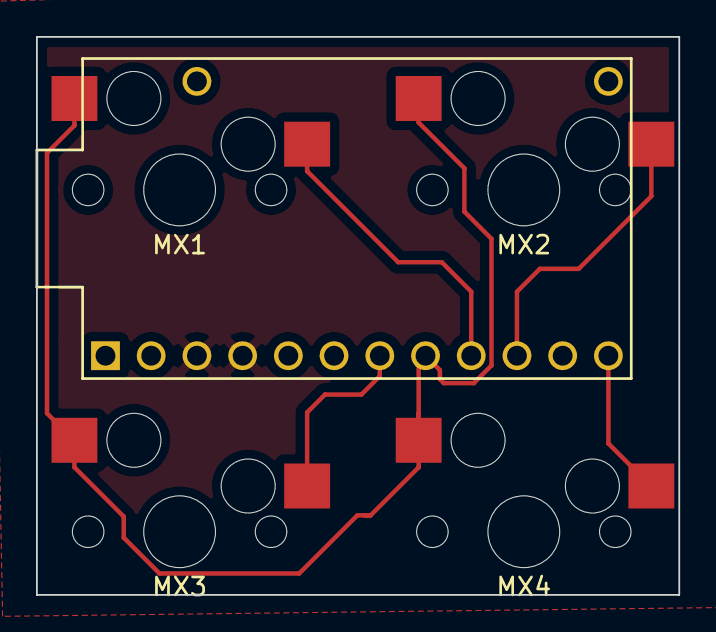
[picture p50: board 4 button Macropad(2)/BigSwitch.kicad_pcb from above]

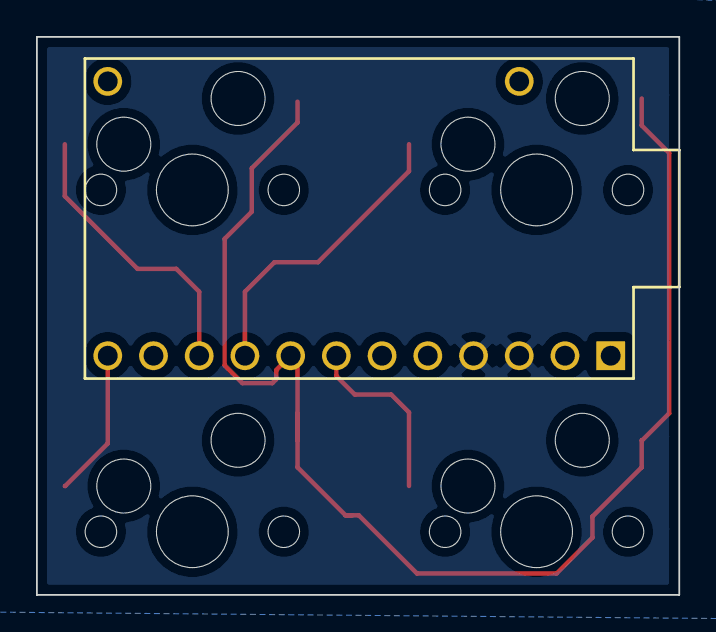
[picture p51: board 4 button Macropad(2)/BigSwitch.kicad_pcb from below]

Board: 2 copper layers, 35.7 x 31.0 mm, 5 parts (4 on the bottom side), 6 nets.

Parts:
MX1, MX2, MX3, MX4: MX-NoLED; MXOnly-1U-Hotswap
U1: ProMicro

Connections:
/D4: MX3.1, U1.7
/D5: MX1.2, MX2.2, MX3.2, MX4.2, U1.8
/D6: MX1.1, U1.9
/D7: MX2.1, U1.10
/D9: MX4.1, U1.12
GND: U1.3, U1.4
