JackPikatea/pikatea-macropad-deej-firmware/Pikatea Desktop Macropad/Pikatea Desktop Macropad.kicad_pcb

## KiCad design Pikatea Desktop Macropad/Pikatea Desktop Macropad.kicad_pcb (2021-05-04)

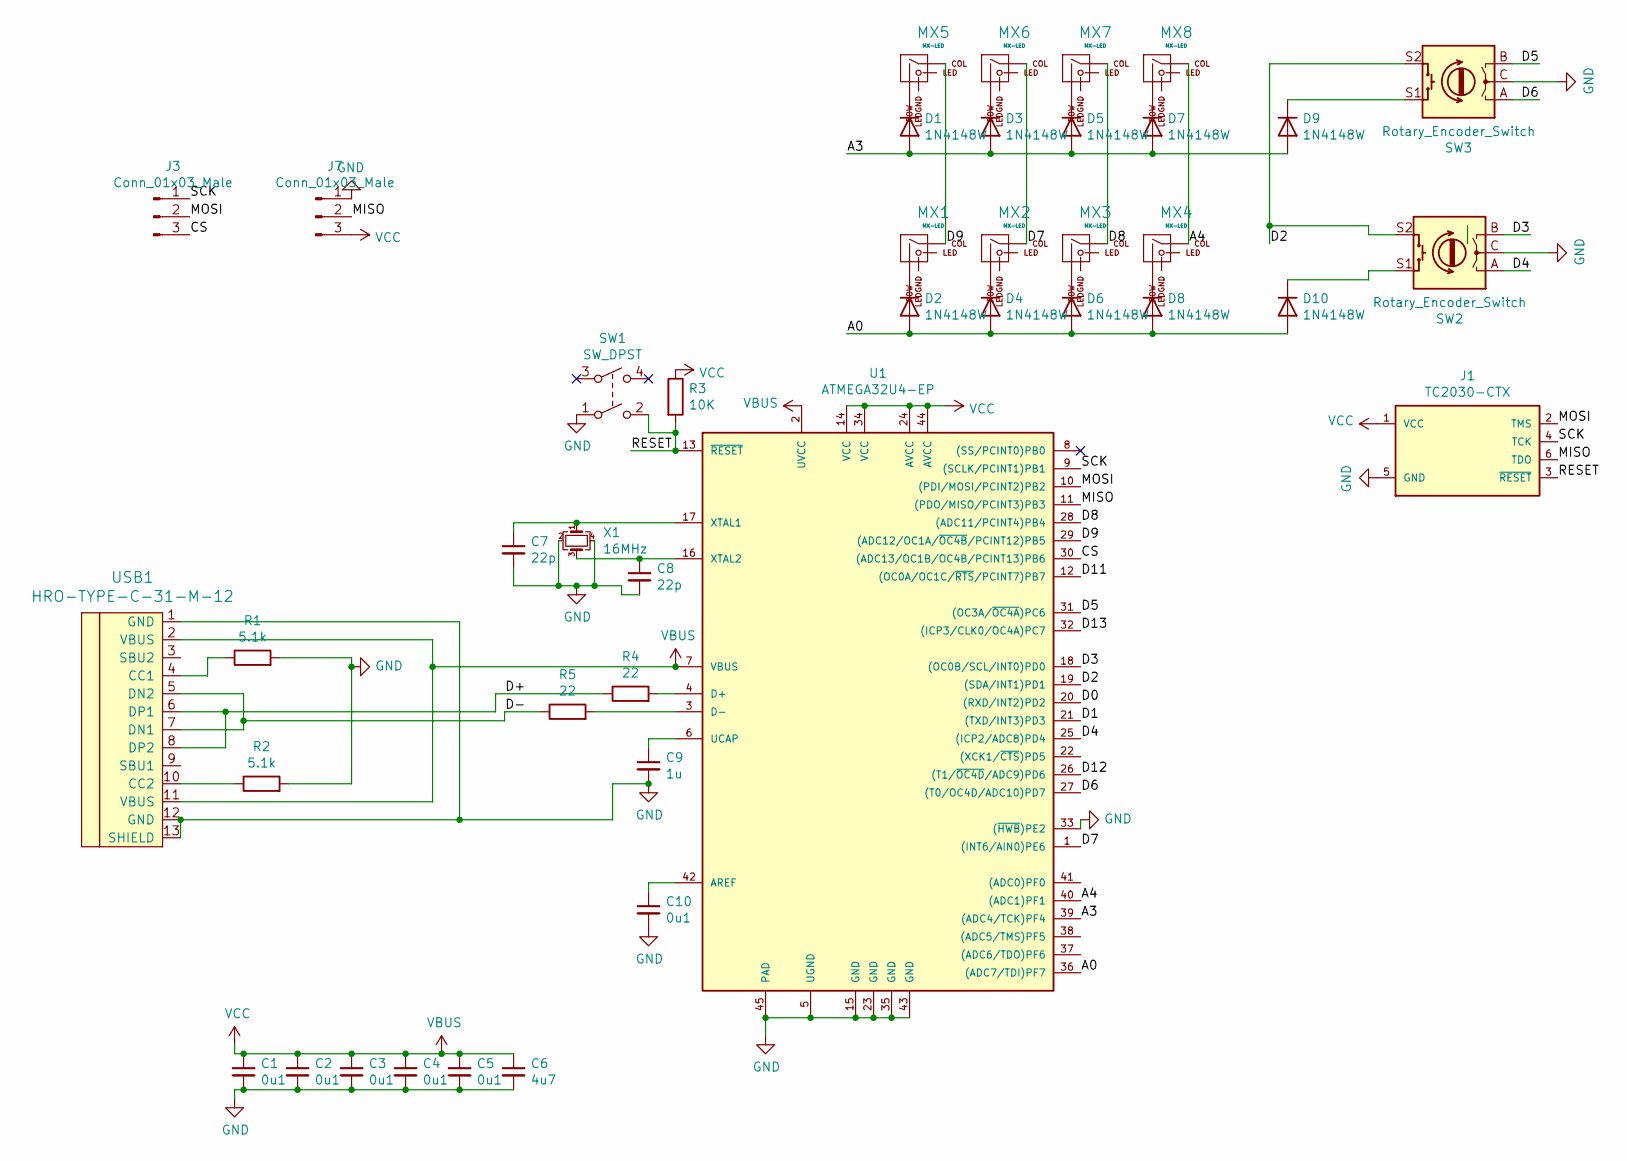
[picture p52: schematic Pikatea Desktop Macropad.sch]

Parts:
C1, C2, C3, C4, C5, C10: 0u1; C_0805_2012Metric
C6: 4u7; C_0805_2012Metric
C7, C8: 22p; C_0805_2012Metric
C9: 1u; C_0805_2012Metric
D1, D2, D3, D4, D5, D6, D7, D8, D9, D10: 1N4148W; D_SOD-123
J1: TC2030-CTX; TC2030-IDC
J3, J7: Conn_01x03_Male; PinHeader_1x03_P2.54mm_Vertical
MX1, MX2, MX3, MX4, MX5, MX6, MX7, MX8: MX-LED; MXOnly-1U
R1, R2: 5.1k; R_0805_2012Metric
R3: 10K; R_0805_2012Metric
R4, R5: 22; R_0805_2012Metric
SW1: SW_DPST; SW_SPST_TL3342
SW2, SW3: Rotary_Encoder_Switch; Encoder-BI_EN11_HSM0E
U1: ATMEGA32U4-EP; LQFP-44_10x10mm_P0.8mm
USB1: HRO-TYPE-C-31-M-12; HRO-TYPE-C-31-M-12-Assembly
X1: 16MHz; Crystal_SMD_SeikoEpson_FA238-4Pin_3.2x2.5mm

Connections:
/A0: D2.2 (A), D4.2 (A), D6.2 (A), D8.2 (A), D10.2 (A), U1.36 ((ADC7/TDI)PF7)
/A3: D1.2 (A), D3.2 (A), D5.2 (A), D7.2 (A), D9.2 (A), U1.39 ((ADC4/TCK)PF4)
/A4: MX4.1 (COL), MX8.1 (COL), U1.40 ((ADC1)PF1)
/CS: J3.3, U1.30 ((ADC13/OC1B/OC4B/PCINT13)PB6)
/D0: U1.20 ((RXD/INT2)PD2)
/D1: U1.21 ((TXD/INT3)PD3)
/D2: SW2.S2, SW3.S2, U1.19 ((SDA/INT1)PD1)
/D3: SW2.B, U1.18 ((OC0B/SCL/INT0)PD0)
/D4: SW2.A, U1.25 ((ICP2/ADC8)PD4)
/D5: SW3.B, U1.31 ((OC3A/~OC4A~)PC6)
/D6: SW3.A, U1.27 ((T0/OC4D/ADC10)PD7)
/D7: MX2.1 (COL), MX6.1 (COL), U1.1 ((INT6/AIN0)PE6)
/D8: MX3.1 (COL), MX7.1 (COL), U1.28 ((ADC11/PCINT4)PB4)
/D9: MX1.1 (COL), MX5.1 (COL), U1.29 ((ADC12/OC1A/~OC4B~/PCINT12)PB5)
/D11: U1.12 ((OC0A/OC1C/~RTS~/PCINT7)PB7)
/D12: U1.26 ((T1/~OC4D~/ADC9)PD6)
/D13: U1.32 ((ICP3/CLK0/OC4A)PC7)
/D+: R4.1, USB1.6 (DP1), USB1.8 (DP2)
/D-: R5.1, USB1.5 (DN2), USB1.7 (DN1)
/MISO: J1.6 (TDO), J7.2, U1.11 ((PDO/MISO/PCINT3)PB3)
/MOSI: J1.2 (TMS), J3.2, U1.10 ((PDI/MOSI/PCINT2)PB2)
/RESET: J1.3 (~RESET), R3.2, SW1.2, U1.13 (~RESET~)
/SCK: J1.4 (TCK), J3.1, U1.9 ((SCLK/PCINT1)PB1)
GND: C1.2, C2.2, C3.2, C4.2, C5.2, C6.2, C7.2, C8.2, C9.2, C10.2, J1.5 (GND), J7.1, R1.2, R2.2, SW1.1, SW2.C, SW3.C, U1.5 (UGND), U1.15 (GND), U1.23 (GND), U1.33 ((~HWB~)PE2), U1.35 (GND), U1.43 (GND), U1.45 (PAD), USB1.1 (GND), USB1.12 (GND), USB1.13 (SHIELD), X1.2, X1.4
unnamed: C7.1, U1.17 (XTAL1), X1.1
unnamed: C8.1, U1.16 (XTAL2), X1.3
unnamed: C9.1, U1.6 (UCAP)
unnamed: C10.1, U1.42 (AREF)
unnamed: D1.1 (K), MX5.2 (ROW)
unnamed: D2.1 (K), MX1.2 (ROW)
unnamed: D3.1 (K), MX6.2 (ROW)
unnamed: D4.1 (K), MX2.2 (ROW)
unnamed: D5.1 (K), MX7.2 (ROW)
unnamed: D6.1 (K), MX3.2 (ROW)
unnamed: D7.1 (K), MX8.2 (ROW)
unnamed: D8.1 (K), MX4.2 (ROW)
unnamed: D9.1 (K), SW3.S1
unnamed: D10.1 (K), SW2.S1
unnamed: R1.1, USB1.4 (CC1)
unnamed: R2.1, USB1.10 (CC2)
unnamed: R4.2, U1.4 (D+)
unnamed: R5.2, U1.3 (D-)
VBUS: C1.1, C2.1, C3.1, C4.1, C5.1, C6.1, J1.1 (VCC), J7.3, R3.1, U1.2 (UVCC), U1.7 (VBUS), U1.14 (VCC), U1.24 (AVCC), U1.34 (VCC), U1.44 (AVCC), USB1.2 (VBUS), USB1.11 (VBUS)

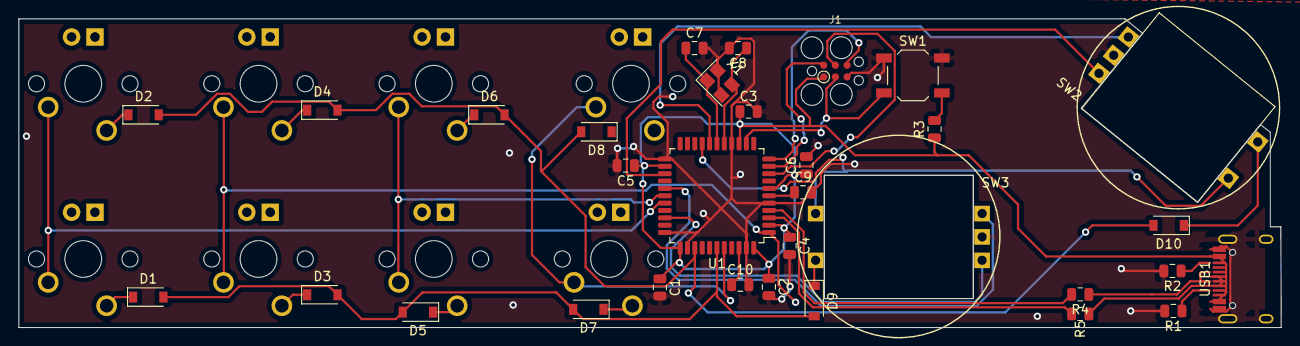
[picture p53: board Pikatea Desktop Macropad.kicad_pcb from above]

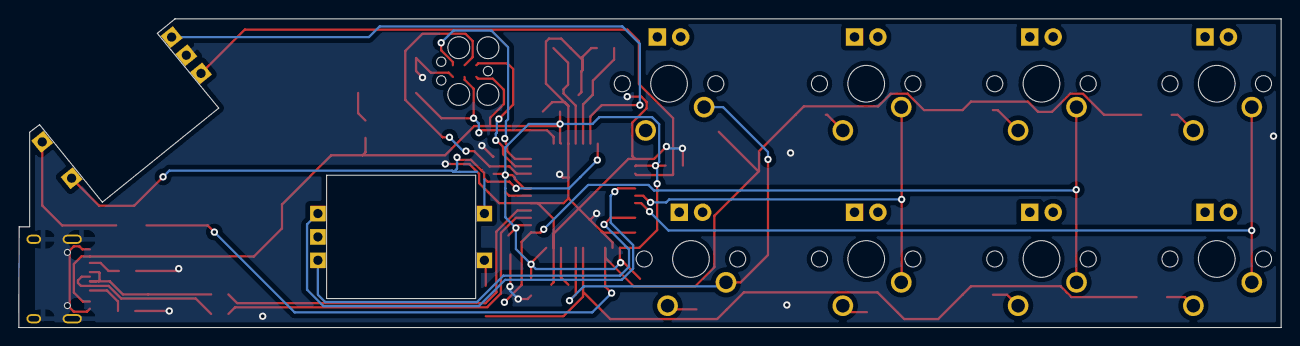
[picture p54: board Pikatea Desktop Macropad.kicad_pcb from below]

Board: 2 copper layers, 137.2 x 33.5 mm, 40 parts (8 on the bottom side), 37 nets.
