JackPikatea/pikatea-macropad-deej-firmware/Pikatea Macropad Mini/Pikatea Macropad Mini.kicad_pcb

## KiCad design Pikatea Macropad Mini/Pikatea Macropad Mini.kicad_pcb (2021-05-04)

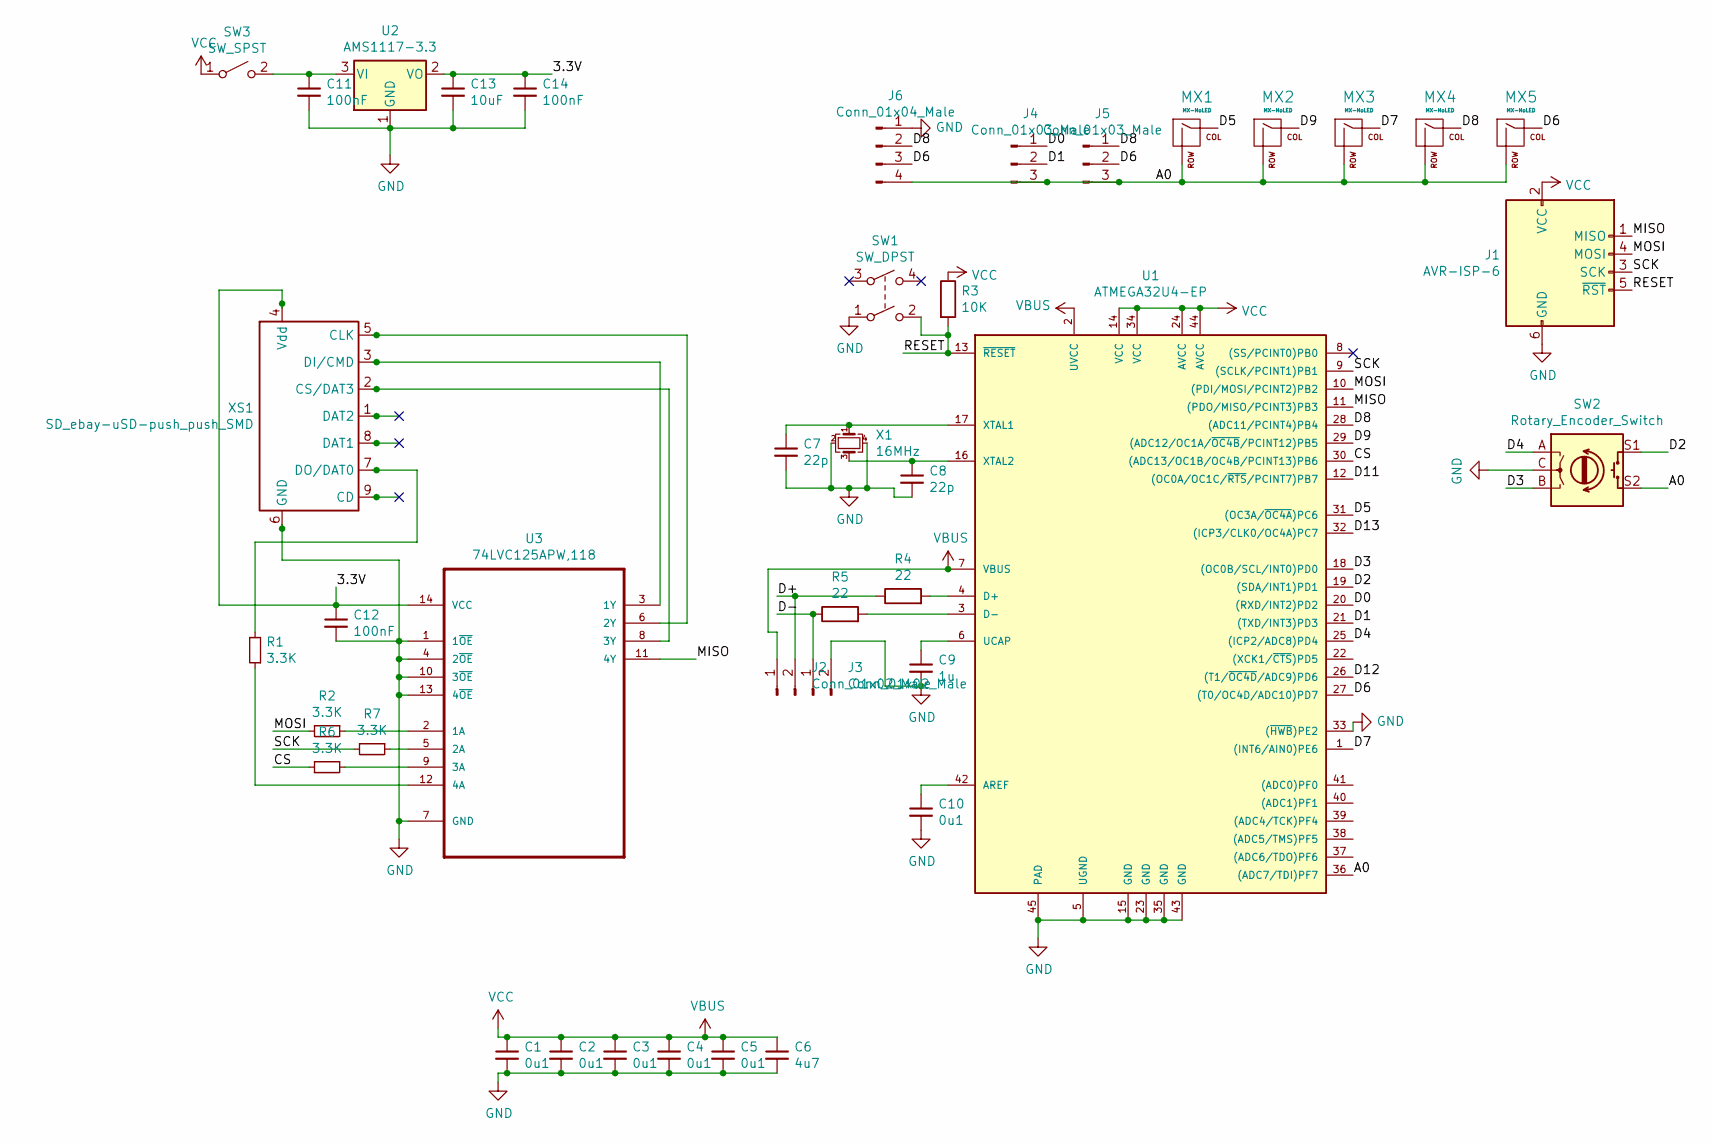
[picture p55: schematic Pikatea Macropad Mini.sch]

Parts:
C1, C2, C3, C4, C5, C10: 0u1; C_0805_2012Metric
C6: 4u7; C_0805_2012Metric
C7, C8: 22p; C_0805_2012Metric
C9: 1u; C_0805_2012Metric
C11, C12, C14: 100nF; C_0805_2012Metric
C13: 10uF; C_0805_2012Metric
J1: AVR-ISP-6; IDC-Header_2x03_P2.54mm_Vertical
J2, J3: Conn_01x02_Male; PinHeader_1x02_P2.54mm_Vertical
J4, J5: Conn_01x03_Male; PinHeader_1x03_P2.54mm_Vertical
J6: Conn_01x04_Male; Breakaway-Throughole
MX1, MX2, MX3, MX4, MX5: MX-NoLED; SW_Cherry_MX_1.00u_PCB
R1, R2, R6, R7: 3.3K; R_0805_2012Metric
R3: 10K; R_0805_2012Metric
R4, R5: 22; R_0805_2012Metric
SW1: SW_DPST; SW_SPST_TL3342
SW2: Rotary_Encoder_Switch; Encoder-BI_EN11_HSM0E
SW3: SW_SPST; Pikatea_Solder_switch
U1: ATMEGA32U4-EP; LQFP-44_10x10mm_P0.8mm
U2: AMS1117-3.3; SOT-223-3_TabPin2
U3: 74LVC125APW,118; TSSOP-14-1EP_4.4x5mm_P0.65mm
X1: 16MHz; Crystal_SMD_SeikoEpson_FA238-4Pin_3.2x2.5mm
XS1: SD_ebay-uSD-push_push_SMD; XUNPU_TF-110

Connections:
/3.3V: C12.1, C13.1, C14.1, U2.2 (VO), U3.14 (VCC), XS1.4 (Vdd)
/A0: J4.3, J5.3, J6.4, MX1.2 (ROW), MX2.2 (ROW), MX3.2 (ROW), MX4.2 (ROW), MX5.2 (ROW), SW2.S2, U1.36 ((ADC7/TDI)PF7)
/CS: R6.1, U1.30 ((ADC13/OC1B/OC4B/PCINT13)PB6)
/D0: J4.1, U1.20 ((RXD/INT2)PD2)
/D1: J4.2, U1.21 ((TXD/INT3)PD3)
/D2: SW2.S1, U1.19 ((SDA/INT1)PD1)
/D3: SW2.B, U1.18 ((OC0B/SCL/INT0)PD0)
/D4: SW2.A, U1.25 ((ICP2/ADC8)PD4)
/D5: MX1.1 (COL), U1.31 ((OC3A/~OC4A~)PC6)
/D6: J5.2, J6.3, MX5.1 (COL), U1.27 ((T0/OC4D/ADC10)PD7)
/D7: MX3.1 (COL), U1.1 ((INT6/AIN0)PE6)
/D8: J5.1, J6.2, MX4.1 (COL), U1.28 ((ADC11/PCINT4)PB4)
/D9: MX2.1 (COL), U1.29 ((ADC12/OC1A/~OC4B~/PCINT12)PB5)
/D11: U1.12 ((OC0A/OC1C/~RTS~/PCINT7)PB7)
/D12: U1.26 ((T1/~OC4D~/ADC9)PD6)
/D13: U1.32 ((ICP3/CLK0/OC4A)PC7)
/D+: J2.2, R4.1
/D-: J3.1, R5.1
/MISO: J1.1 (MISO), U1.11 ((PDO/MISO/PCINT3)PB3), U3.11 (4Y)
/MOSI: J1.4 (MOSI), R2.2, U1.10 ((PDI/MOSI/PCINT2)PB2)
/RESET: J1.5 (~RST), R3.2, SW1.2, U1.13 (~RESET~)
/SCK: J1.3 (SCK), R7.2, U1.9 ((SCLK/PCINT1)PB1)
GND: C1.2, C2.2, C3.2, C4.2, C5.2, C6.2, C7.2, C8.2, C9.2, C10.2, C11.2, C12.2, C13.2, C14.2, J1.6 (GND), J3.2, J6.1, SW1.1, SW2.C, U1.5 (UGND), U1.15 (GND), U1.23 (GND), U1.33 ((~HWB~)PE2), U1.35 (GND), U1.43 (GND), U1.45 (PAD), U2.1 (GND), U3.1 (1~OE), U3.4 (2~OE), U3.7 (GND), U3.10 (3~OE), U3.13 (4~OE), X1.2, X1.4, XS1.6 (GND)
unnamed: C7.1, U1.17 (XTAL1), X1.1
unnamed: C8.1, U1.16 (XTAL2), X1.3
unnamed: C9.1, U1.6 (UCAP)
unnamed: C10.1, U1.42 (AREF)
unnamed: C11.1, SW3.2 (B), U2.3 (VI)
unnamed: R1.1, U3.12 (4A)
unnamed: R1.2, XS1.7 (DO/DAT0)
unnamed: R2.1, U3.2 (1A)
unnamed: R4.2, U1.4 (D+)
unnamed: R5.2, U1.3 (D-)
unnamed: R6.2, U3.9 (3A)
unnamed: R7.1, U3.5 (2A)
unnamed: U3.3 (1Y), XS1.3 (DI/CMD)
unnamed: U3.6 (2Y), XS1.5 (CLK)
unnamed: U3.8 (3Y), XS1.2 (CS/DAT3)
VBUS: C1.1, C2.1, C3.1, C4.1, C5.1, C6.1, J1.2 (VCC), J2.1, R3.1, SW3.1 (A), U1.2 (UVCC), U1.7 (VBUS), U1.14 (VCC), U1.24 (AVCC), U1.34 (VCC), U1.44 (AVCC)

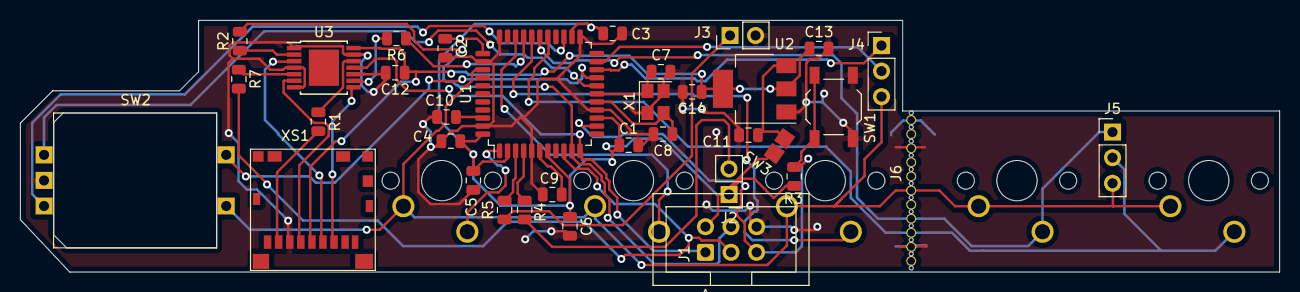
[picture p56: board Pikatea Macropad Mini.kicad_pcb from above]

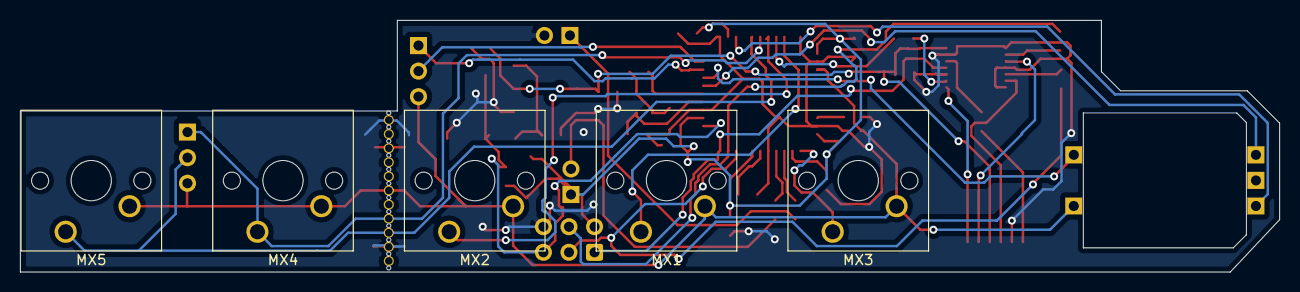
[picture p57: board Pikatea Macropad Mini.kicad_pcb from below]

Board: 2 copper layers, 125.1 x 25.0 mm, 40 parts (5 on the bottom side), 36 nets.
