JackPikatea/pikatea-macropad-deej-firmware/Pikatea SD card Module/Pikatea SD card Module.kicad_pcb

## KiCad design Pikatea SD card Module/Pikatea SD card Module.kicad_pcb (2021-04-14)

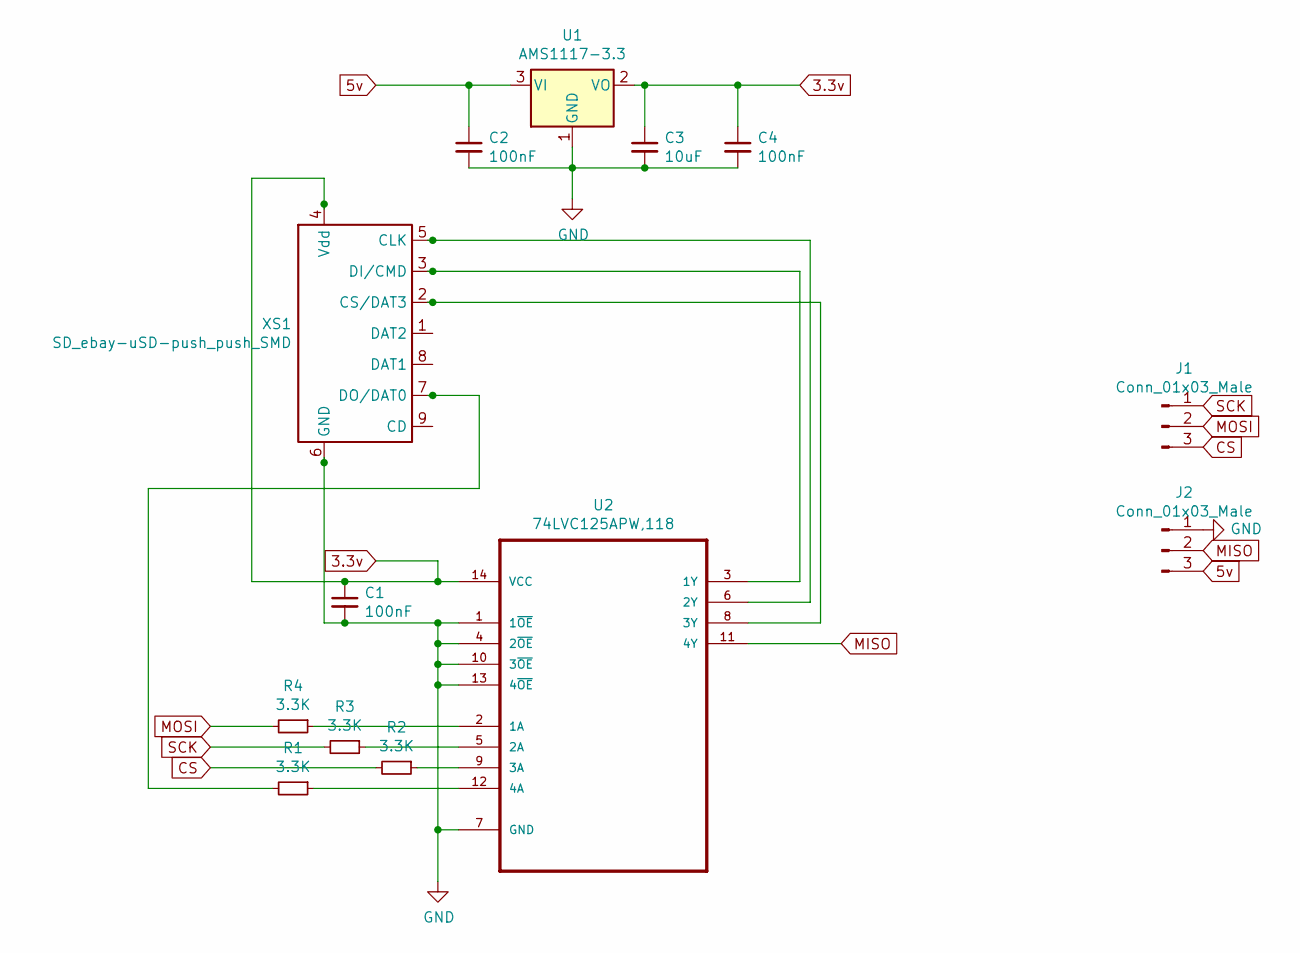
[picture p58: schematic Pikatea SD card Module.sch]

Parts:
C1, C2, C4: 100nF; C_0805_2012Metric
C3: 10uF; C_0805_2012Metric
J1, J2: Conn_01x03_Male; PinHeader_1x03_P2.54mm_Vertical
R1, R2, R3, R4: 3.3K; R_0805_2012Metric
U1: AMS1117-3.3; SOT-223-3_TabPin2
U2: 74LVC125APW,118; TSSOP-14-1EP_4.4x5mm_P0.65mm
XS1: SD_ebay-uSD-push_push_SMD; Conn_uSDcard

Connections:
3.3v: C1.1, C3.1, C4.1, U1.2 (VO), U2.14 (VCC), XS1.4 (Vdd)
5v: C2.1, J2.3, U1.3 (VI)
CS: J1.3, R2.2
GND: C1.2, C2.2, C3.2, C4.2, J2.1, U1.1 (GND), U2.1 (1~OE), U2.4 (2~OE), U2.7 (GND), U2.10 (3~OE), U2.13 (4~OE), XS1.6 (GND)
MISO: J2.2, U2.11 (4Y)
MOSI: J1.2, R4.2
unnamed: R1.1, U2.12 (4A)
unnamed: R1.2, XS1.7 (DO/DAT0)
unnamed: R2.1, U2.9 (3A)
unnamed: R3.1, U2.5 (2A)
unnamed: R4.1, U2.2 (1A)
unnamed: U2.3 (1Y), XS1.3 (DI/CMD)
unnamed: U2.6 (2Y), XS1.5 (CLK)
unnamed: U2.8 (3Y), XS1.2 (CS/DAT3)
SCK: J1.1, R3.2

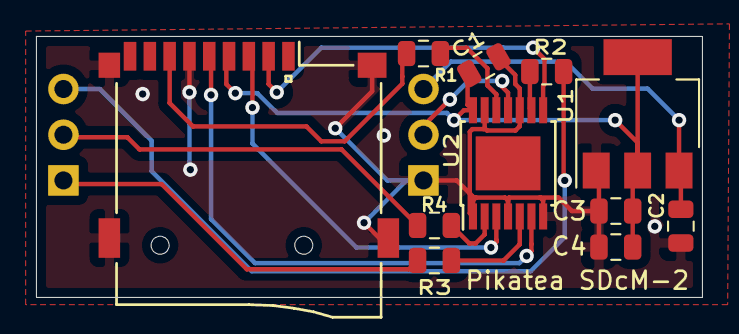
[picture p59: board Pikatea SD card Module.kicad_pcb from above]

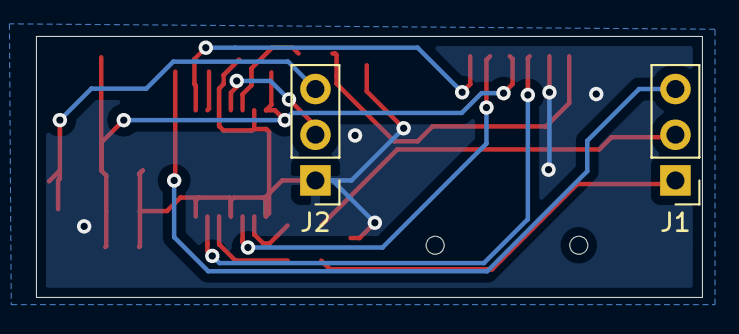
[picture p60: board Pikatea SD card Module.kicad_pcb from below]

Board: 2 copper layers, 37.0 x 14.5 mm, 13 parts (2 on the bottom side), 15 nets.
