JackPikatea/pikatea-macropad-deej-firmware/Prusa Lights Switch PCB/Prusa Lights Switch PCB.kicad_pcb

## KiCad design Prusa Lights Switch PCB/Prusa Lights Switch PCB.kicad_pcb (2021-03-23)

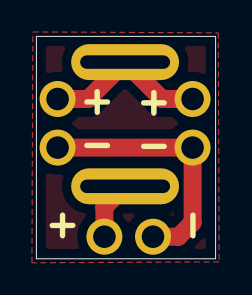
[picture p61: board Prusa Lights Switch PCB.kicad_pcb from above]

Board: 2 copper layers, 10.0 x 12.3 mm, 4 parts (0 on the bottom side), 3 nets.

Parts:
J1, J2, J3: 2 Pin larger header holes
SW1: Prusa Light Switch

Connections:
unnamed: J1.1, J2.1, SW1.1
unnamed: J1.2, J2.2, J3.2
unnamed: J3.1, SW1.2
