JackPikatea/pikatea-macropad-deej-firmware/BigSwitch/BigSwitch.kicad_pcb

## KiCad design BigSwitch/BigSwitch.kicad_pcb (2021-01-30, an earlier design)

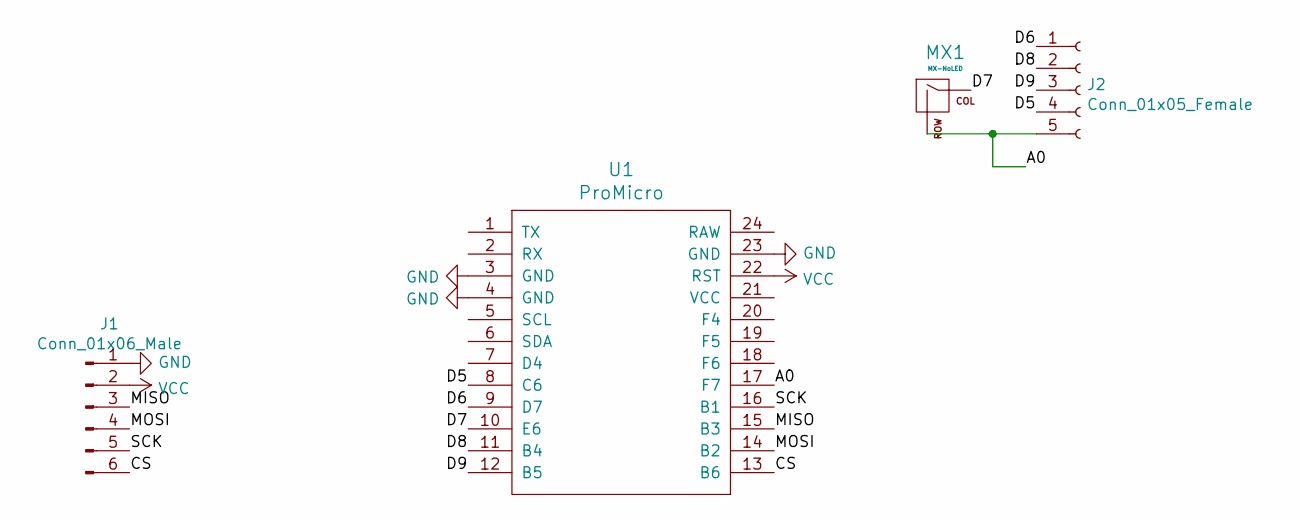
[picture p62: schematic BigSwitch.sch]

Parts:
J1: Conn_01x06_Male; SDcardModule-BottomSideDown
J2: Conn_01x05_Female; PinHeader_1x05_P2.54mm_Vertical
MX1: MX-NoLED; BigSwitch
U1: ProMicro

Connections:
/A0: J2.5, MX1.2 (ROW), U1.17 (F7)
/CS: J1.6, U1.13 (B6)
/D5: J2.4, U1.8 (C6)
/D6: J2.1, U1.9 (D7)
/D7: MX1.1 (COL), U1.10 (E6)
/D8: J2.2, U1.11 (B4)
/D9: J2.3, U1.12 (B5)
/MISO: J1.3, U1.15 (B3)
/MOSI: J1.4, U1.14 (B2)
/SCK: J1.5, U1.16 (B1)
GND: J1.1, U1.3 (GND), U1.4 (GND), U1.23 (GND)
VCC: J1.2, U1.22 (RST)

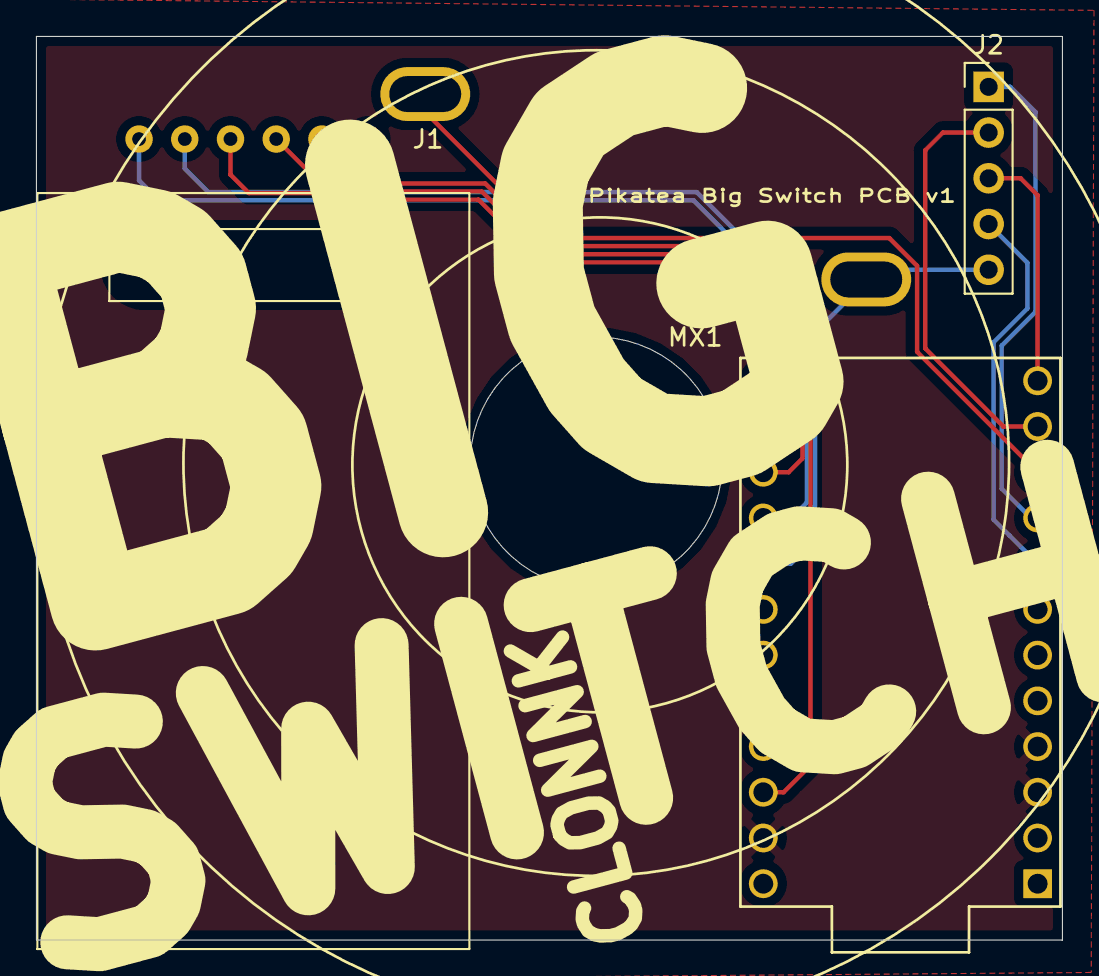
[picture p63: board BigSwitch/BigSwitch.kicad_pcb from above]

Board: 2 copper layers, 57.0 x 50.2 mm, 4 parts (0 on the bottom side), 12 nets.
