JackPikatea/pikatea-macropad-deej-firmware/Pikatea Bottom Switch/PikateaBSB.kicad_pcb

## KiCad design Pikatea Bottom Switch/PikateaBSB.kicad_pcb (2020-09-01)

Schematic: PikateaBSB.sch

Parts:
C1, C2, C4: 100nF; C_0805_2012Metric
C3: 10uF; C_0805_2012Metric
J1: Conn_01x16; PinHeader_1x16_P2.54mm_Vertical
J2, J3: Conn_01x03; PinHeader_1x03_P2.54mm_Vertical
MX1, MX2, MX3, MX4, MX5: MX-NoLED; MX-1U
R1, R2, R3, R4: 3.3K; R_0805_2012Metric
SW1: Rotary_Encoder_Switch; RotaryEncoder_Alps_EC12E-Switch_Vertical_H20mm
SW2: SW_DPST; SW_SPST_TL3342
U1: AMS1117-3.3; SOT-223-3_TabPin2
U2: 74LVC125APW,118; TSSOP-14-1EP_4.4x5mm_P0.65mm
XS1: SD_ebay-uSD-push_push_SMD; Conn_uSDcard

Connections:
/3.3V: C1.1, C3.1, C4.1, U1.2 (VO), U2.14 (VCC), XS1.4
/5v: C2.1, J1.1, U1.3 (VI)
/A0: J1.3, J3.3, MX1.2 (ROW), MX2.2 (ROW), MX3.2 (ROW), MX4.2 (ROW), MX5.2 (ROW), SW1.S2
/CS: J1.5, R2.1
/D2: J1.12, J3.1, SW1.S1
/D3: J1.13, J2.1, SW1.B
/D4: J1.9, J2.3, SW1.A
/D5: J1.4, MX3.1 (COL)
/D6: J1.8, MX2.1 (COL)
/D7: J1.2, MX5.1 (COL)
/D8: J1.7, MX4.1 (COL)
/D9: J1.6, MX1.1 (COL)
/MISO: J1.14, U2.11 (4Y)
/MOSI: J1.11, R3.1
/RESET: J1.16, SW2.2
/SCK: J1.10, R4.1
GND: C1.2, C2.2, C3.2, C4.2, J1.15, J2.2, SW1.C, SW2.1, U1.1 (GND), U2.1 (1~OE), U2.4 (2~OE), U2.7 (GND), U2.10 (3~OE), U2.13 (4~OE), XS1.6
unnamed: R1.1, U2.12 (4A)
unnamed: R1.2, XS1.7
unnamed: R2.2, U2.9 (3A)
unnamed: R3.2, U2.2 (1A)
unnamed: R4.2, U2.5 (2A)
unnamed: U2.3 (1Y), XS1.3
unnamed: U2.6 (2Y), XS1.5
unnamed: U2.8 (3Y), XS1.2

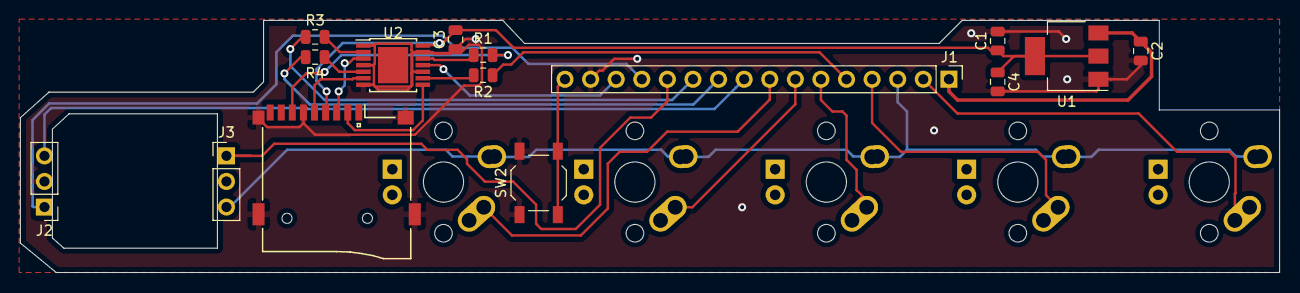
[picture p66: board PikateaBSB.kicad_pcb from above]

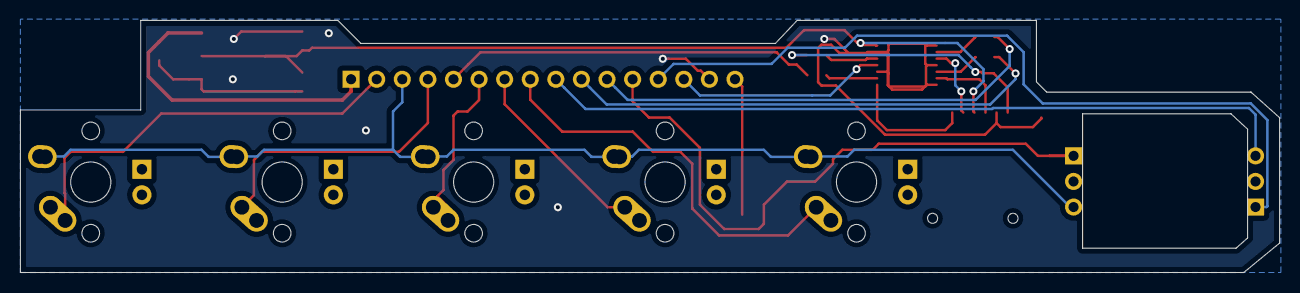
[picture p67: board PikateaBSB.kicad_pcb from below]

Board: 2 copper layers, 125.0 x 25.0 mm, 20 parts (5 on the bottom side), 25 nets.
