JackPikatea/pikatea-macropad-deej-firmware/Pikatea R26 macropad/Pikatea R26 Barbones Macropad/Pikatea R26 Barebones Macropad.kicad_pcb

## KiCad design Pikatea R26 macropad/Pikatea R26 Barbones Macropad/Pikatea R26 Barebones Macropad.kicad_pcb (2022-02-07)

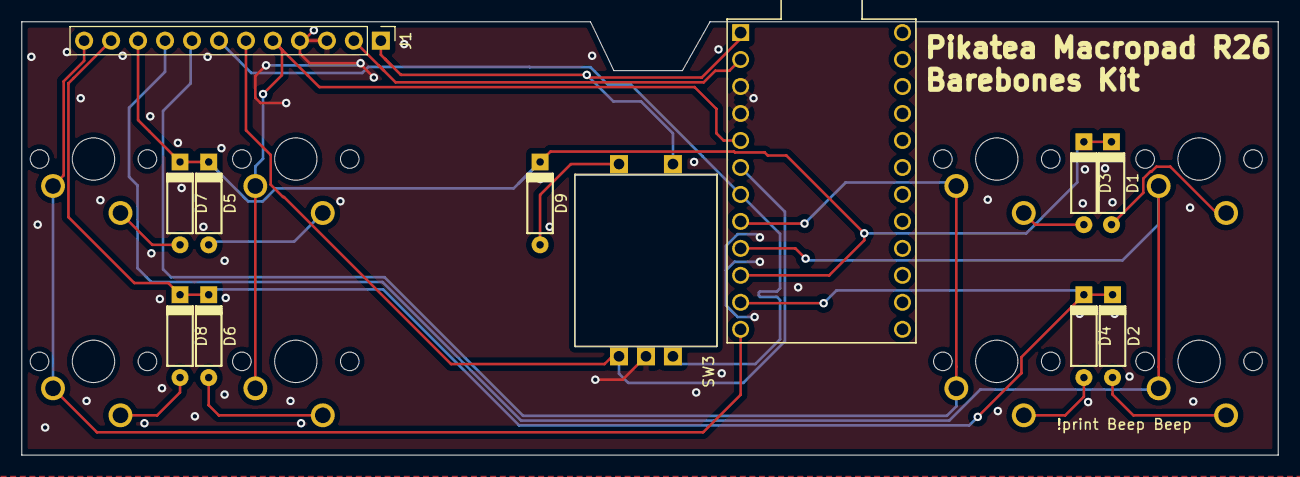
[picture p68: board Pikatea R26 Barebones Macropad.kicad_pcb from above]

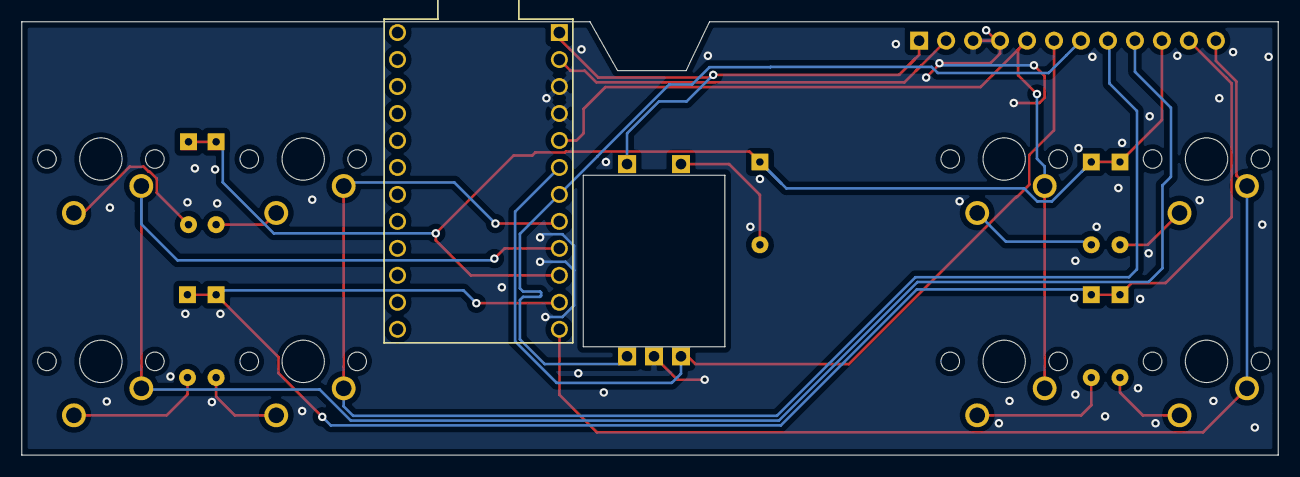
[picture p69: board Pikatea R26 Barebones Macropad.kicad_pcb from below]

Board: 2 copper layers, 118.3 x 40.8 mm, 20 parts (8 on the bottom side), 20 nets.

Parts:
D1, D2, D3, D4, D5, D6, D7, D8, D9: 1N4148W; D_axial
J1: Conn_01x12_Female; PinHeader_1x12_P2.54mm_Vertical
MX1, MX2, MX3, MX4, MX5, MX6, MX7, MX8: MX-LED; MXOnly-1U-NoLED
SW3: Rotary_Encoder_Switch; Encoder-BI_EN11_HSM0E
U1: ProMicro

Connections:
/A: J1.7, SW3.A, U1.7
/A0: D2.1, D4.1, D6.1, D8.1, J1.11, U1.11
/A3: D1.1, D3.1, D5.1, D7.1, D9.1, J1.10, U1.10
/A4: J1.12, MX4.1, MX8.1, U1.12
/A10: J1.1, SW3.S2, U1.1
/B: J1.6, SW3.B, U1.6
/D7: J1.8, MX2.1, MX6.1, U1.8
/D8: J1.5, MX3.1, MX7.1, U1.5
/D9: J1.9, MX1.1, MX5.1, U1.9
GND: J1.3, J1.4, SW3.C, U1.3, U1.4
unnamed: D1.2, MX5.2
unnamed: D2.2, MX1.2
unnamed: D3.2, MX6.2
unnamed: D4.2, MX2.2
unnamed: D5.2, MX7.2
unnamed: D6.2, MX3.2
unnamed: D7.2, MX8.2
unnamed: D8.2, MX4.2
unnamed: D9.2, SW3.S1
unnamed: J1.2, U1.2
