JackPikatea/pikatea-macropad-deej-firmware/Pikatea Macropad FK1/Pikatea Macropad FK1.kicad_pcb

## KiCad design Pikatea Macropad FK1/Pikatea Macropad FK1.kicad_pcb (2022-01-12)

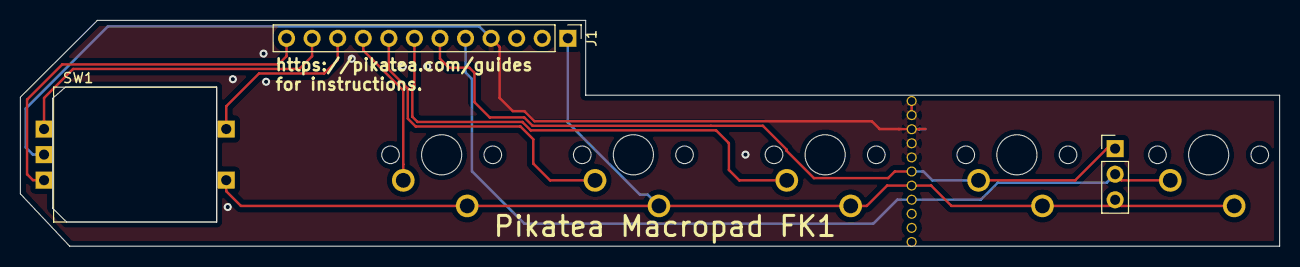
[picture p70: board Pikatea Macropad FK1.kicad_pcb from above]

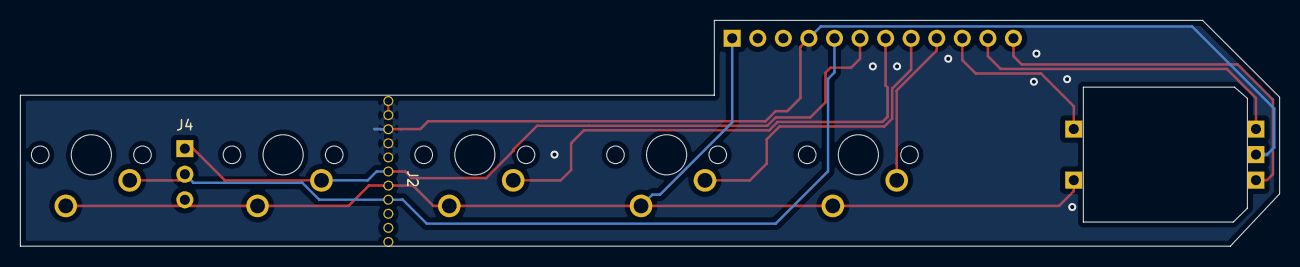
[picture p71: board Pikatea Macropad FK1.kicad_pcb from below]

Board: 2 copper layers, 125.1 x 22.4 mm, 9 parts (5 on the bottom side), 10 nets.

Parts:
J1: Conn_01x12_Female; PinHeader_1x12_P2.54mm_Vertical
J2: Conn_01x06_Male; Breakaway-Throughole
J4: Conn_01x03_Male; PinHeader_1x03_P2.54mm_Vertical
MX1, MX2, MX3, MX4, MX5: MX-LED; MXOnly-1U-NoLED
SW1: Rotary_Encoder_Switch; Encoder-BI_EN11_HSM0E

Connections:
/A0: J1.1, J2.2, J4.3, MX1.2, MX2.2, MX3.2, MX4.2, MX5.2, SW1.S2
/D2: J1.10, SW1.S1
/D3: J1.11, SW1.B
/D4: J1.12, SW1.A
/D5: J1.9, MX1.1
/D6: J1.5, J2.3, J4.2, MX5.1
/D7: J1.7, MX3.1
/D8: J1.6, J2.4, J4.1, MX4.1
/D9: J1.8, MX2.1
GND: J1.4, J2.1, SW1.C
