JackPikatea/pikatea-macropad-deej-firmware/MMCProMicro.kicad_pcb

## KiCad design MMCProMicro.kicad_pcb (2021-01-30)

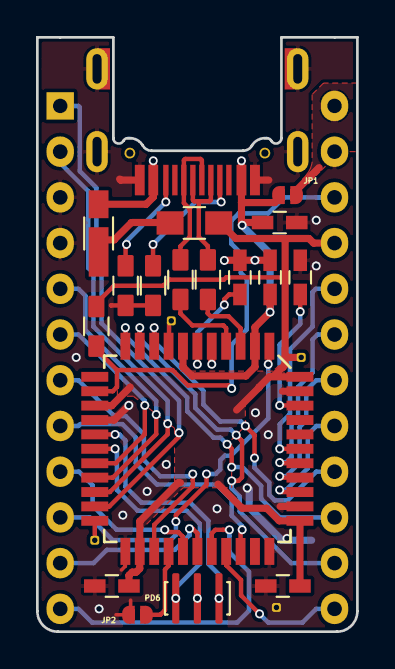
[picture p72: board MMCProMicro.kicad_pcb from above]

Board: 2 copper layers, 17.8 x 33.0 mm, 24 parts (0 on the bottom side), 37 nets.

Parts:
C1: 4u7; C_0603_HandSoldering
C2: 1u0; C_0603_HandSoldering
C3, C4, C5, C6: 0u1; C_0603_HandSoldering
D1: D_Schottky; D_TUMD2_HandSoldering
F1: Fuse; F_0805_HandSoldering
J1: USB2_C_Receptacle; Mid_Mount-USB_C_HandSoldering
J2, J3: Conn_01x12; Pin_Header_Custom_Straight_1x12_Pitch2.54mm
JP1, JP2: SolderJumper_2_Open; SolderJumper-2_P1.0mm_Open_RoundedPad0.7x1.0mm
R1, R2: 5.1k; R_0603_HandSoldering
R3, R4: 22; R_0603_HandSoldering
R5: 10k; R_0603_HandSoldering
TP1, TP2, TP3, TP4: TestPoint; Measurement_Point_RoundSquare-TH_Tiny
U1: ATmega32U4-AU; TQFP-44_10x10mm_P0.8mm
X1: Resonator; Resonator_SMD_muRata_CSTxExxV-3Pin_3.0x1.1mm_HandSoldering_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

Connections:
/NC: J3.1, JP1.2
/PD6: JP2.2, U1.26
/UCAP: C2.1, U1.6
AREF: C4.1, U1.42
D+: R3.1, U1.4
D-: R4.1, U1.3
GND: C1.2, C2.2, C3.2, C4.2, C5.2, C6.2, J1.A1B12, J1.B1A12, J1.S1, J2.3, J2.4, J3.2, JP2.1, R1.1, R2.1, TP3.1, U1.5, U1.15, U1.23, U1.33, U1.35, U1.43, X1.2
unnamed: D1.1, F1.1
unnamed: J1.A5, R2.2
unnamed: J1.A6, J1.B6, R3.2
unnamed: J1.A7, J1.B7, R4.2
unnamed: J1.B5, R1.2
PB0: TP1.1, U1.8
PB1: J3.9, U1.9
PB2: J3.11, U1.10
PB3: J3.10, U1.11
PB4: J2.11, U1.28
PB5: J2.12, U1.29
PB6: J3.12, U1.30
PC6: J2.8, U1.31
PD0: J2.6, U1.18
PD1: J2.5, U1.19
PD2: J2.2, U1.20
PD3: J2.1, U1.21
PD4: J2.7, U1.25
PD5: TP2.1, U1.22
PD7: J2.9, U1.27
PE6: J2.10, U1.1
PF4: J3.5, U1.39
PF5: J3.6, U1.38
PF6: J3.7, U1.37
PF7: J3.8, U1.36
RESET: J3.3, R5.2, U1.13
VBUS: C1.1, C3.1, D1.2, J1.A4B9, J1.B4A9, JP1.1, U1.2, U1.7
VCC: C5.1, C6.1, F1.2, J3.4, R5.1, TP4.1, U1.14, U1.24, U1.34, U1.44
XTAL1: U1.17, X1.1
XTAL2: U1.16, X1.3
