JackPikatea/pikatea-macropad-deej-firmware/(commit log)

2020-07-04 Initial Commit
    Daughter board
    [PikateaBSB.kicad_pcb, PikateaBSB.sch]
2020-07-04 Remove R6 and rename MCU data line nets
    [PikateaTPM.sch]
2020-07-04 Beginings of SD card part of the board
    [PikateaBSB.sch]
2020-07-04 Change MCU footprint to QFP-44_10x10x08P
    [PikateaTPM.sch]
2020-07-04 Finish laying out components
    [PikateaTPM.kicad_pcb]
2020-07-04 added some useful keyboard libraries. added footprints to board
    schematic still needs to be finished
    [PikateaBSB.kicad_pcb, PikateaBSB.sch]
2020-07-04 Swap pinouts
    [PikateaTPM.sch]
2020-07-04 Wire board
    [PikateaTPM.kicad_pcb]
2020-07-05 Replace usb mini footprint
    [PikateaTPM.kicad_pcb, PikateaTPM.sch]
2020-07-05 Adjust trace to move away from crystal
    [PikateaTPM.kicad_pcb]
2020-07-05 Adjust traces
    [PikateaTPM.kicad_pcb]
2020-07-05 Add labels to pins, adjust holes
    [PikateaTPM.kicad_pcb]
2020-07-05 rudimentary layout
    [PikateaBSB.kicad_pcb]
2020-07-05 add BOM
    [PikateaTPM-BOM.csv, PikateaTPM.sch]
2020-07-05 updated gerbers and bom
    [PikateaTPM-BOM.csv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]
2020-07-05 Retrace VBUS for alternate USB headers
    [PikateaTPM.kicad_pcb]
2020-07-13 Bottom Switch plate, footprints in place
    [PikateaBSB.kicad_pcb, PikateaBSB.sch, PikateaTPM.kicad_pcb, PikateaTPM.sch]
2020-07-13 Add footprint libraries to project
2020-07-14 Update to 0805 footprints
    [PikateaTPM.kicad_pcb, PikateaTPM.sch]
2020-07-18 Update Doughter board
    [PikateaBSB-BOM.csv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]
2020-07-19 remove reset pin
    [PikateaTPM.kicad_pcb]
2020-08-28 manually meged 0805 branch to master
    I hate myself for doing this
    [PikateaTPM-BOM (lcsc).csv, PikateaTPM-BOM.csv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]
2020-08-28 added circuit board cutouts
    [PikateaBSB.kicad_pcb, PikateaBSB.sch]
2020-09-01 updated gerbers for daughter board
    [PikateaBSB-BOM-updated.csv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]
2020-09-02 updated bom and gerbers for bottom switch
    [PikateaBSB-BOM-updated.csv]
2020-09-02 updated usb footprint. updated gerbers
    [PikateaTPM-B_Cu.gbl, PikateaTPM-B_Mask.gbs, PikateaTPM-B_Paste.gbp, PikateaTPM-B_SilkS.gbo, PikateaTPM-Edge_Cuts.gm1, PikateaTPM-F_Cu.gtl, PikateaTPM-F_Mask.gts, PikateaTPM-F_Paste.gtp]
2020-11-24 added Pikatea Macropad Mini
    [Pikatea Macropad Mini.kicad_pcb, Pikatea Macropad Mini.sch]
2020-11-25 finish schematic. add custom library
2021-01-25 completed mini version 1
    [Pikatea Macropad Mini-B_Cu.gbr, Pikatea Macropad Mini-B_Mask.gbr, Pikatea Macropad Mini-B_Paste.gbr, Pikatea Macropad Mini-B_SilkS.gbr, Pikatea Macropad Mini-Edge_Cuts.gbr, Pikatea Macropad Mini-F_Cu.gbr, Pikatea Macropad Mini-F_Mask.gbr, Pikatea Macropad Mini-F_Paste.gbr]
2021-01-27 updated gerbers
    [Pikatea Macropad Mini-B_Cu.gbr, Pikatea Macropad Mini-B_Mask.gbr, Pikatea Macropad Mini-B_Paste.gbr, Pikatea Macropad Mini-B_SilkS.gbr, Pikatea Macropad Mini-Edge_Cuts.gbr, Pikatea Macropad Mini-F_Cu.gbr, Pikatea Macropad Mini-F_Mask.gbr, Pikatea Macropad Mini-F_Paste.gbr]
2021-01-30 add big switch project
    [BigSwitch-B_Cu.gbr, BigSwitch-B_Mask.gbr, BigSwitch-B_Paste.gbr, BigSwitch-B_SilkS.gbr, BigSwitch-Edge_Cuts.gbr, BigSwitch-F_Cu.gbr, BigSwitch-F_Mask.gbr, BigSwitch-F_Paste.gbr]
2021-02-05 added more projects
    [PR-PCB.kicad_pcb, PR-PCB.sch, PR-TopPlate.kicad_pcb, PR-TopPlate.sch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]
2021-02-18 updated footprints added gerbers
    [PR-PCB.kicad_pcb, PR-PCB.sch, PR-TopPlate - Copy.kicad_pcb, PR-TopPlate.kicad_pcb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]
2021-03-23 update universal libraries
    [PR-BottomCase - Copy.kicad_pcb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]
2021-03-24 pikatea macropad gb3
    [Pikatea Macropad GB3-B_Cu.gbr, Pikatea Macropad GB3-B_Mask.gbr, Pikatea Macropad GB3-B_Paste.gbr, Pikatea Macropad GB3-B_SilkS.gbr, Pikatea Macropad GB3-Edge_Cuts.gbr, Pikatea Macropad GB3-F_Cu.gbr, Pikatea Macropad GB3-F_Mask.gbr, Pikatea Macropad GB3-F_Paste.gbr]
2021-05-16 update gb3
    [Pikatea Macropad GB3-B_Cu.gbr, Pikatea Macropad GB3-B_Mask.gbr, Pikatea Macropad GB3-B_Paste.gbr, Pikatea Macropad GB3-B_SilkS.gbr, Pikatea Macropad GB3-Edge_Cuts.gbr, Pikatea Macropad GB3-F_Cu.gbr, Pikatea Macropad GB3-F_Mask.gbr, Pikatea Macropad GB3-F_Paste.gbr]
2021-06-23 add 4 button macropad
    [4 Button Macropad.kicad_pcb, 4 Button Macropad.sch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]
2021-06-23 update keyboard
    [PR-TopPlate.kicad_pcb, Pikatea Keyboard - Copy.kicad_pcb, Pikatea Keyboard.kicad_pcb, Pikatea Keyboard.sch, Richard Top Plate.step, The Richard Bottom Plate.step, The richard PCB.step]
2021-06-23 add pcb3.stp
2021-06-23 finish pcb shape and add holes for standoffs
    [Pikatea Keyboard.kicad_pcb]
2021-06-23 update promicro to use teensy instead
    [JLCSMT_Sample_BOM1.xlsx, PCB1.step, PCB2.step, Pikatea Keyboard Pro Micro - JLCPCB.xls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]
2021-07-06 add pcb file
    [pcb.step]
2021-08-24 add GB3 Addon
    [JLCSMT_Sample_BOM1.xlsx, Pikatea Macropad GB3 Addon - JLCPCB.xls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]
2021-09-28 add hand wire helpers
    [JLCSMT_Sample_BOM1.xlsx, Pikatea handwire helpers - JLCPCB.xls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]
2021-10-27 add FinnGus Project
    [FinnGus.kicad_pcb, FinnGus.sch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]
2021-10-28 start finngus project
    [FinnGus.kicad_pcb, FinnGus.sch, FinnGusHeadPlate.kicad_pcb, FinnGusHeadPlate.sch, FinnGusPCB.kicad_pcb, FinnGusPCB.sch, FinnGusTailPlate.kicad_pcb, FinnGusTailPlate.sch]
2021-11-05 add full kit macropad
    [FinnGusPCB.kicad_pcb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]
2021-11-12 add handwire helpers
    [1u Hand Wire Helpers - JLCPCB.xls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]
2021-12-22 add xl macropad pcb
    [MMCProMicro.sch, Pikatea XL Macropad.kicad_pcb, Pikatea XL Macropad.sch]
2022-01-06 update andwire gerbers
    [1u Hand Wire Helpers-B_Cu.gbr, 1u Hand Wire Helpers-B_Mask.gbr, 1u Hand Wire Helpers-B_Paste.gbr, 1u Hand Wire Helpers-B_SilkS.gbr, 1u Hand Wire Helpers-Edge_Cuts.gbr, 1u Hand Wire Helpers-F_Cu.gbr, 1u Hand Wire Helpers-F_Mask.gbr, 1u Hand Wire Helpers-F_Paste.gbr]
2022-01-06 updates to XL macropad
    [Pikatea Macropad FK1.kicad_pcb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]
2022-01-12 add gerbers2
    [Pikatea Macropad FK1-B_Cu.gbr, Pikatea Macropad FK1-B_Mask.gbr, Pikatea Macropad FK1-B_Paste.gbr, Pikatea Macropad FK1-B_SilkS.gbr, Pikatea Macropad FK1-Edge_Cuts.gbr, Pikatea Macropad FK1-F_Cu.gbr, Pikatea Macropad FK1-F_Mask.gbr, Pikatea Macropad FK1-F_Paste.gbr]
2022-01-12 add gerbers flip labels
    [Pikatea Macropad FK1.kicad_pcb]
2022-01-19 update XL
    [Pikatea XL Macropad.sch]
2022-01-19 update diode direction
    [Pikatea XL Macropad.sch]
2022-01-25 update auto save
    [Pikatea XL Macropad PCB Model.step, Pikatea XL Macropad.kicad_pcb, top plate template sketch.dxf]
2022-01-31 add R26 SMD
    [Backside cover sketch.dxf, HRO TYPE-C-31-M-12.step, JLCSMT_BOM.xlsx, MMCProMicro.sch, Pikatea Keyboard Teensy2 - JLCPCB.xls, Pikatea Keyboard Teensy2-BOM.csv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]
2022-02-02 update R26
    [Pikatea R26 PCB-B_Cu.gbr, Pikatea R26 PCB-B_Mask.gbr, Pikatea R26 PCB-B_Paste.gbr, Pikatea R26 PCB-B_SilkS.gbr, Pikatea R26 PCB-Edge_Cuts.gbr, Pikatea R26 PCB-F_Cu.gbr, Pikatea R26 PCB-F_Mask.gbr, Pikatea R26 PCB-F_Paste.gbr]
2022-02-03 updae GB4
    [JLCSMT_Sample_BOM1.xlsx, Pikatea Macropad GB3 - JLCPCB.xls, Pikatea Macropad GB3.xls, Pikatea Macropad GB4.kicad_pcb, Pikatea Macropad GB4.sch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]
2022-02-05 update GB4
    [Pikatea Macropad GB4.kicad_pcb, Pikatea Macropad GB4.sch]
2022-02-07 update r26 and gb4
    [Pikatea Macropad GB4.kicad_pcb, Pikatea Macropad GB4.sch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]
2022-02-08 add R26 plate
    [Pikatea R26 Plate-B_Cu.gbr, Pikatea R26 Plate-B_Mask.gbr, Pikatea R26 Plate-B_Paste.gbr, Pikatea R26 Plate-B_SilkS.gbr, Pikatea R26 Plate-Edge_Cuts.gbr, Pikatea R26 Plate-F_Cu.gbr, Pikatea R26 Plate-F_Mask.gbr, Pikatea R26 Plate-F_Paste.gbr]
2022-02-11 Revision b of GB4
    [GB4 BOM.xlsx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]
2022-02-14 update boms and gerbers
    [GB4 BOM.xlsx, JLCSMT_BOM.xlsx, Pikatea Keyboard Teensy2 - JLCPCB.xls, Pikatea Keyboard Teensy2-BOM.csv, Pikatea Keyboard Teensy2-BOM.xls, Pikatea Macropad GB4.csv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]
2022-02-20 update handwire helpers
    [1u Hand Wire Helpers-B_Cu.gbr, 1u Hand Wire Helpers-B_Mask.gbr, 1u Hand Wire Helpers-B_Paste.gbr, 1u Hand Wire Helpers-B_Silkscreen.gbr, 1u Hand Wire Helpers-Edge_Cuts.gbr, 1u Hand Wire Helpers-F_Cu.gbr, 1u Hand Wire Helpers-F_Mask.gbr, 1u Hand Wire Helpers-F_Paste.gbr]
2022-03-31 update gb4 to kicad 6, add gb4 fkvarient
    [HRO TYPE-C-31-M-12.step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]
2022-04-29 add R26 LED
    [MMCProMicro.sch, Pikatea R26 Kit LED Macropad PCB Model.step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]
